OnePice-C/INV.5KW/INV.5KW.OG.Design/Hardware/Main_Display/PCB_Main_Display.html

Altium customize

# Board Information Report

Date: | | 20/5/2025
Time: | | 2:47:24 PM
Elapsed Time: | | 00:00:00
Filename: | | D:\DTKH.INV.13.OFG\INV.5KW.OG.Design\hardware\Main_Display\PCB_Main_Display.PcbDoc
Units: | | mmmils

## Contents

Contents

Board Specification

General

Routing

Routing Information

Layer Information

Layer Information

Drill Pairs

Copper Area

Copper Area

Board Holes

Non-Plated Hole Size

Plated Hole Size

Board Slots

Non-Plated Slot Size

Plated Slot Size

Board Square Holes

Non-Plated Square Hole Size

Plated Square Hole Size

Other

Top Layer Annular Ring Size

Mid Layer Annular Ring Size

Bottom Layer Annular Ring Size

Pad Solder Mask

Pad Paste Mask

Pad Pwr/Gnd Expansion

Pad Relief Conductor Width

Pad Relief Air Gap

Pad Relief Entries

Via Solder Mask

Via Pwr/Gnd Expansion

Track Width

Arc Line Width

Arc Radius

Arc Degrees

Text Height

Text Width

Net Track Width

Net Via Size

## Board Specification

General
Board Size | 125mm x 115mm
Components on board | 172

Back to top

## Routing

Routing Information
Routing completion | 98.84%
Connections | 431
Connections routed | 426
Connections remaining | 5

Back to top

## Layer Information

Layer | Arcs | Pads | Vias | Tracks | Texts | Fills | Regions | ComponentBodies
Top Layer | 0 | 516 | 0 | 776 | 0 | 1 | 701 | 0
Bottom Layer | 0 | 10 | 0 | 191 | 0 | 0 | 157 | 0
Mechanical 1 | 0 | 0 | 0 | 7 | 0 | 0 | 0 | 160
Mechanical 7 | 0 | 0 | 0 | 36 | 12 | 27 | 0 | 0
Mechanical 13 | 9 | 0 | 0 | 28 | 0 | 0 | 0 | 11
Mechanical 14 | 0 | 0 | 0 | 4 | 0 | 0 | 0 | 0
Mechanical 15 | 2 | 1 | 0 | 554 | 0 | 0 | 0 | 0
Multi-Layer | 0 | 133 | 220 | 0 | 0 | 0 | 1 | 0
Top Paste | 0 | 0 | 0 | 0 | 0 | 0 | 1 | 0
Top Overlay | 57 | 0 | 0 | 810 | 314 | 1 | 0 | 0
Top Solder | 0 | 0 | 0 | 1 | 0 | 0 | 1 | 0
Bottom Solder | 0 | 0 | 0 | 0 | 0 | 0 | 1 | 0
Bottom Overlay | 11 | 0 | 0 | 69 | 38 | 0 | 3 | 0
Bottom Paste | 0 | 0 | 0 | 0 | 0 | 0 | 0 | 0
Drill Guide | 0 | 0 | 0 | 0 | 0 | 0 | 0 | 0
Keep-Out Layer | 4 | 0 | 0 | 4 | 0 | 0 | 0 | 0
Drill Drawing | 0 | 0 | 0 | 0 | 0 | 0 | 0 | 0
Total | 83 | 660 | 220 | 2480 | 364 | 29 | 865 | 171

Back to top

Drill Pairs | Vias
Top Layer - Bottom Layer | 220
Total | 220

Back to top

## Copper Area

Layer | Sq.In. | Sq.MM. | Percent of layer
Top Layer | 18.365 | 11848.6 | 82%
Bottom Layer | 18.402 | 11872.267 | 83%
Total | 36.767 | 23720.867

Back to top

## Board Holes

Non-Plated Hole Size | Pads | Vias
Total | 0 | 0

Back to top

Plated Hole Size | Pads | Vias
0mm | 517 | 0
0.3mm | 0 | 220
0.5mm | 32 | 0
0.8mm | 2 | 0
0.8128mm | 9 | 0
0.8636mm | 4 | 0
0.889mm | 4 | 0
1mm | 4 | 0
1.016mm | 20 | 0
1.02mm | 4 | 0
1.2mm | 20 | 0
1.3mm | 2 | 0
1.5mm | 4 | 0
1.5mm | 12 | 0
2mm | 8 | 0
3mm | 4 | 0
3.1mm | 4 | 0
Total | 650 | 220

Back to top

## Board Slots

Non-Plated Slot Size / Length | Pads
Total | 0

Back to top

Plated Slot Size / Length | Pads
Total | 0

Back to top

## Board Square Holes

Non-Plated Square Hole Size | Pads
Total | 0

Back to top

Plated Square Hole Size | Pads
Total | 0

Back to top

## Other

Top Layer Annular Ring Size | Count
0mm | 36
0.1mm | 12
0.2mm | 216
0.635mm | 4
0.762mm | 20
0.78mm | 4
0.8mm | 2
0.8mm | 20
0.8382mm | 9
1mm | 2
1.0414mm | 4
1.2mm | 2
1.24mm | 2
1.5mm | 12
1.5mm | 4
1.9mm | 4
Total | 353

Back to top

Mid Layer Annular Ring Size | Count
0mm | 36
0.1mm | 12
0.2mm | 216
0.635mm | 4
0.762mm | 20
0.78mm | 4
0.8mm | 2
0.8mm | 20
0.8382mm | 9
1mm | 2
1.0414mm | 4
1.2mm | 2
1.24mm | 2
1.5mm | 12
1.5mm | 4
1.9mm | 4
Total | 353

Back to top

Bottom Layer Annular Ring Size | Count
0mm | 36
0.1mm | 12
0.2mm | 216
0.635mm | 4
0.762mm | 20
0.78mm | 4
0.8mm | 2
0.8mm | 20
0.8382mm | 9
1mm | 2
1.0414mm | 4
1.2mm | 2
1.24mm | 2
1.5mm | 12
1.5mm | 4
1.9mm | 4
Total | 353

Back to top

Pad Solder Mask | Count
0mm | 1
0.0508mm | 8
0.1016mm | 651
Total | 660

Back to top

Pad Paste Mask | Count
-1mm | 1
0mm | 659
Total | 660

Back to top

Pad Pwr/Gnd Expansion | Count
0.508mm | 660
Total | 660

Back to top

Pad Relief Conductor Width | Count
0.254mm | 660
Total | 660

Back to top

Pad Relief Air Gap | Count
0.254mm | 660
Total | 660

Back to top

Pad Relief Entries | Count
4 | 660
Total | 660

Back to top

Via Solder Mask | Count
0.1016mm | 220
Total | 220

Back to top

Via Pwr/Gnd Expansion | Count
0.508mm | 220
Total | 220

Back to top

Track Width | Count
0.05mm | 32
0.0762mm | 4
0.1mm | 1111
0.1016mm | 156
0.127mm | 53
0.15mm | 17
0.1778mm | 14
0.2mm | 82
0.2032mm | 564
0.254mm | 29
0.3mm | 344
0.5mm | 70
1mm | 4
Total | 2480

Back to top

Arc Line Width | Count
0.05mm | 2
0.1mm | 5
0.127mm | 2
0.15mm | 1
0.1778mm | 1
0.178mm | 3
0.2mm | 46
0.2032mm | 1
0.25mm | 7
0.254mm | 9
0.4mm | 1
0.6mm | 5
Total | 83

Back to top

Arc Radius | Count
0.0254mm | 2
0.1mm | 4
0.125mm | 7
0.2mm | 1
0.254mm | 1
0.3mm | 5
0.5mm | 5
0.55mm | 1
1mm | 4
2mm | 3
2.5mm | 2
2.8mm | 36
3.0871mm | 4
4mm | 4
4.25mm | 2
4.5mm | 1
11.557mm | 1
Total | 83

Back to top

Arc Degrees | Count
30 | 36
90 | 4
174 | 1
184 | 2
302 | 3
320 | 1
360 | 36
Total | 83

Back to top

Text Height | Count
0.5mm | 12
0.6mm | 1
0.8mm | 343
1mm | 2
1.524mm | 2
3mm | 4
Total | 364

Back to top

Text Width | Count
0.1mm | 1
0.2mm | 343
0.2032mm | 2
0.254mm | 18
Total | 364

Back to top

Net Track Width | Count
0.2032mm | 129
0.254mm | 2
Total | 131

Back to top

Net Via Size | Count
0.5mm | 131
Total | 131

Back to top
