OnePice-C/INV.5KW/INV.5KW.OG.Design/Hardware/INV.OG5K.MAIN.V1/INV.MAIN.PCB1.html

Altium customize

# Board Information Report

Date: | | 26/2/2025
Time: | | 6:48:35 PM
Elapsed Time: | | 00:00:00
Filename: | | D:\DTKH.INV\INV.5KW.OG.Design\Hardware\INV.OG5K.MAIN\INV.MAIN.PCB1.PcbDoc
Units: | | mmmils

## Contents

Contents

Board Specification

General

## Board Specification

General
Board Size | 320mm x 320mm
Components on board | 541

Back to top
