OnePice-C/INV.5KW/INV.5KW.OG.Design/firmware/exemple/sinv_F28P55x/RELEASE/syscfg/pinmux.csv

All device pins and their pinmux options
Pin | Name | Selected Mode | 0 | 1 | 2 | 3 | 4 | 5 | 6 | 7 | 8 | 9 | 10 | 11 | 12 | 13 | 14 | 15
1 | GPIO29 |  | GPIO29 | SCIA_TX |  | EPWM7_B | GPIO29 | OUTPUTXBAR6 | EQEP1_B |  | GPIO29 | EQEP2_INDEX | LINA_RX | SPIB_PTE | GPIO29 | ERRORSTS | I2CB_SCL
2 | A16/ B16/ C16/ GPIO28 |  | GPIO28 | SCIA_RX |  | EPWM7_A | GPIO28 | OUTPUTXBAR5 | EQEP1_A |  | GPIO28 | EQEP2_STROBE | LINA_TX | SPIB_CLK | GPIO28 | ERRORSTS | I2CB_SDA
3 | XRSn | XRSn
4 | GPIO46 |  | GPIO46 |  |  | LINA_TX | GPIO46 | MCANA_TX |  | FSITXA_D1 | GPIO46 | PMBUSA_SDA |  |  | GPIO46
5 | VDDIO | VDDIO
6 | VDD | VDD
7 | VSS | VSS
8 | GPIO47 |  | GPIO47 |  |  | LINA_RX | GPIO47 | MCANA_RX |  | CLB_OUTPUTXBAR2 | GPIO47 | PMBUSA_SCL |  |  | GPIO47
9 | GPIO66 |  | GPIO66 | EQEP1_B | EPWM12_A |  | GPIO66 |  | SPIB_POCI |  | GPIO66 | MCANA_RX |  | I2CA_SDA | GPIO66
10 | GPIO67 |  | GPIO67 | EPWM7_B | EPWM12_B | MCANA_TX | GPIO67 | EQEP1_INDEX | SCIB_RX | PMBUSA_ALERT | GPIO67 | FSIRXA_CLK | LINA_RX | SPIA_POCI | GPIO67 |  |  | SCIC_RX
11 | GPIO48 |  | GPIO48 | OUTPUTXBAR3 |  |  | GPIO48 | MCANA_TX | SCIA_TX |  | GPIO48 | PMBUSA_SDA |  |  | GPIO48
12 | GPIO49 |  | GPIO49 | OUTPUTXBAR4 |  |  | GPIO49 | MCANA_RX | SCIA_RX |  | GPIO49 | LINA_RX |  |  | GPIO49 |  | FSITXA_D0
13 | GPIO50 |  | GPIO50 | EQEP1_A |  |  | GPIO50 | MCANA_TX | SPIB_PICO |  | GPIO50 | I2CB_SDA |  |  | GPIO50 |  | FSITXA_D1
14 | GPIO51 |  | GPIO51 | EQEP1_B |  |  | GPIO51 | MCANA_RX | SPIB_POCI |  | GPIO51 | I2CB_SCL |  |  | GPIO51 |  | FSITXA_CLK
15 | GPIO52 | GPIO52 | GPIO52 | EQEP1_STROBE |  |  | GPIO52 | CLB_OUTPUTXBAR5 | SPIB_CLK |  | GPIO52 | SYNCOUT |  |  | GPIO52 |  | FSIRXA_D0
16 | GPIO53 | GPIO53 | GPIO53 | EQEP1_INDEX |  |  | GPIO53 | CLB_OUTPUTXBAR6 | SPIB_PTE |  | GPIO53 | ADCSOCAO | MCANB_RX |  | GPIO53 |  | FSIRXA_D1
17 | GPIO54 |  | GPIO54 | SPIA_PICO |  |  | GPIO54 | EQEP2_A | OUTPUTXBAR2 |  | GPIO54 | ADCSOCBO | LINA_TX |  | GPIO54 |  | FSIRXA_CLK
18 | A6/ D14/ E14/ GPIO228 | A6_D14_E14_GPIO228 | GPIO228 | EPWM10_A |  | ADCSOCAO | GPIO228 | MCANA_TX | SPIA_POCI |  | GPIO228 | EPWM2_B |  | EQEP1_B | GPIO228 | ADCE_EXTMUXSEL0
19 | B2/ C6/ E12/ GPIO226 | B2_C6_E12_GPIO226 | GPIO226 | EPWM10_B |  | LINA_RX | GPIO226 | EPWM6_A | SPIA_CLK |  | GPIO226 | EPWM1_B |  | EQEP1_STROBE | GPIO226 | ADCE_EXTMUXSEL1 | SCIC_RX
20 | A3/ B3/ PGA2_INP/ C5/ GPIO242 | A3_B3_PGA2_INP_C5_GPIO242 | GPIO242 | EPWM11_A |  |  | GPIO242 | OUTPUTXBAR2 | SPIA_PTE |  | GPIO242 | EPWM4_A | MCANA_RX | EQEP1_INDEX | GPIO242 | ADCE_EXTMUXSEL2
21 | A2/ B6/ C9/ PGA1_INP/ GPIO224 |  | GPIO224 | EPWM11_B |  |  | GPIO224 | OUTPUTXBAR3 | SPIA_PICO |  | GPIO224 | EPWM1_A | MCANA_TX | EQEP1_A | GPIO224 | ADCE_EXTMUXSEL3 | SCIC_TX
22 | A15/ B9/ C7/ PGA1_INM |  | AIO233
23 | C25/ D5/ E5 |  | AIO208
24 | A26/ D6/ E6 |  | AIO209
25 | B26/ D7/ E7 |  | AIO210
26 | A14/ B14/ C4/ PGA1_OUT |  | AIO239
27 | A11/ B10/ C0/ PGA2_OUT |  | AIO237
28 | A5/ B12/ C2/ PGA2_INM |  | AIO244
29 | A1/ B7/ D11/ CMP1_DACL |  | AIO232
30 | A0/ B15/ C15/ DACA_OUT |  | AIO231
31 | D20/ E20/ VREFHI |  | AIO234
32 | D20/ E20/ VREFHI | D20/ E20/ VREFHI
33 | A13/ B13/ C13/ D13/ E13/ VREFLO | A13/ B13/ C13/ D13/ E13/ VREFLO
34 | A13/ B13/ C13/ D13/ E13/ VREFLO |  | AIO235
35 | A12/ C1/ E11/ PGA3_INP |  | AIO238
35 | A12/ C1/ E11/ PGA3_INP |  | AIO248
36 | B11/ D16/ E16/ PGA3_INM |  | AIO251
37 | A7/ B30/ C3/ D12/ E30 |  | AIO245
38 | B5/ D15/ E15/ PGA3_OUT |  | AIO252
39 | A8/ B0/ C11 |  | AIO241
40 | VSSA | VSSA
41 | VDDA | VDDA
42 | A4/ B8/ C14 |  | AIO225
43 | C26/ D8/ E8/ GPIO211 |  | GPIO211 | EPWM10_A |  |  | GPIO211 | EQEP3_A |  |  | GPIO211 |  |  |  | GPIO211
44 | A27/ D9/ E9/ GPIO212 | A27_D9_E9_GPIO212 | GPIO212 | EPWM10_B |  |  | GPIO212 | EQEP3_B |  |  | GPIO212 |  |  |  | GPIO212
45 | B27/ D10/ E10/ GPIO213 | B27_D10_E10_GPIO213 | GPIO213 | EPWM11_A |  |  | GPIO213 | EQEP3_STROBE |  |  | GPIO213 |  |  |  | GPIO213
46 | C27/ D18/ E18/ GPIO214 |  | GPIO214 | EPWM11_B |  |  | GPIO214 | EQEP3_INDEX |  |  | GPIO214 |  |  |  | GPIO214
47 | A28/ D19/ E19/ GPIO215 | A28_D19_E19_GPIO215 | GPIO215 | EPWM7_B |  |  | GPIO215 | EQEP2_A |  |  | GPIO215 |  |  |  | GPIO215
48 | A9/ GPIO227 | A9_GPIO227 | GPIO227 | I2CB_SCL |  | EPWM3_A | GPIO227 | OUTPUTXBAR1 | EPWM2_B |  | GPIO227 |  |  |  | GPIO227
49 | B4/ C8/ GPIO236 | B4_C8_GPIO236 | GPIO236 | EPWM7_A |  |  | GPIO236 | EQEP1_INDEX |  |  | GPIO236 | EPWM12_A |  |  | GPIO236
50 | A10/ B1/ C10/ GPIO230 |  | GPIO230 | I2CB_SDA |  | EPWM3_B | GPIO230 | MCANA_RX | EPWM2_A | I2CA_SDA | GPIO230 | PMBUSA_SCL |  |  | GPIO230
51 | GPIO55 | GPIO55 | GPIO55 | SPIA_POCI |  |  | GPIO55 | EQEP2_B | OUTPUTXBAR3 |  | GPIO55 | ERRORSTS | LINA_RX |  | GPIO55
52 | GPIO60 | GPIO60 | GPIO60 | EPWM12_B |  | MCANA_TX | GPIO60 | OUTPUTXBAR3 | SPIB_PICO |  | GPIO60 |  |  |  | GPIO60
53 | VSS | VSS
54 | VDD | VDD
55 | VDDIO | VDDIO
56 | GPIO64 |  | GPIO64 | SCIA_RX | EPWM11_A | EPWM7_A | GPIO64 | OUTPUTXBAR5 | EQEP1_A |  | GPIO64 | EQEP2_STROBE | LINA_TX | SPIB_CLK | GPIO64 | ERRORSTS | I2CB_SDA
57 | GPIO65 |  | GPIO65 | EQEP1_A | EPWM11_B |  | GPIO65 |  | SPIB_PICO |  | GPIO65 | MCANA_TX |  | I2CA_SCL | GPIO65
58 | GPIO62 | GPIO62 | GPIO62 | EPWM10_A | OUTPUTXBAR3 |  | GPIO62 | MCANA_TX | SCIA_TX |  | GPIO62 | PMBUSA_SDA |  |  | GPIO62
59 | GPIO63 |  | GPIO63 | EPWM10_B | OUTPUTXBAR4 |  | GPIO63 | MCANA_RX | SCIA_RX |  | GPIO63 | LINA_RX |  |  | GPIO63
60 | A17/ B17/ C17/ GPIO20 |  | GPIO20 | EQEP1_A |  |  | GPIO20 | EPWM12_A | SPIB_PICO |  | GPIO20 | MCANA_TX | ADCE_EXTMUXSEL0 | I2CA_SCL | GPIO20 |  |  | SCIC_TX
61 | A18/ B18/ C18/ GPIO21 |  | GPIO21 | EQEP1_B |  |  | GPIO21 | EPWM12_B | SPIB_POCI |  | GPIO21 | MCANA_RX | ADCE_EXTMUXSEL1 | I2CA_SDA | GPIO21 |  |  | SCIC_RX
62 | A19/ B19/ C19/ GPIO13 |  | GPIO13 | EPWM7_B |  | MCANA_TX | GPIO13 | EQEP1_INDEX | SCIB_RX | PMBUSA_ALERT | GPIO13 | FSIRXA_CLK | LINA_RX | SPIA_POCI | GPIO13
63 | A20/ B20/ C20/ GPIO12 |  | GPIO12 | EPWM7_A |  | MCANA_RX | GPIO12 | EQEP1_STROBE | SCIB_TX | PMBUSA_CTL | GPIO12 | FSIRXA_D0 | LINA_TX | SPIA_CLK | GPIO12
64 | A24/ D0/ E0/ GPIO11 | EPWM6_B | GPIO11 | EPWM6_B | MCANA_RX | OUTPUTXBAR7 | GPIO11 | EQEP1_B | SCIB_RX | SPIA_PTE | GPIO11 | FSIRXA_D1 | LINA_RX | EQEP2_A | GPIO11 | SPIA_PICO |  | EQEP3_INDEX
65 | B24/ D1/ E1/ GPIO33 |  | GPIO33 | I2CA_SCL |  | SPIB_PTE | GPIO33 | OUTPUTXBAR4 | LINA_RX |  | GPIO33 | FSIRXA_CLK | MCANB_RX | EQEP2_B | GPIO33 | ADCSOCAO |  | SCIC_RX
66 | C24/ D2/ E2/ GPIO16 |  | GPIO16 | SPIA_PICO |  | OUTPUTXBAR7 | GPIO16 | EPWM9_A | SCIA_TX |  | GPIO16 | EQEP1_STROBE | PMBUSA_SCL | XCLKOUT | GPIO16 | EQEP2_B | SPIB_POCI | EQEP3_STROBE
67 | A25/ D3/ E3/ GPIO17 |  | GPIO17 | SPIA_POCI |  | OUTPUTXBAR8 | GPIO17 | EPWM9_B | SCIA_RX |  | GPIO17 | EQEP1_INDEX | PMBUSA_SDA | MCANA_TX | GPIO17 |  | EPWM6_A
68 | B25/ D4/ E4/ GPIO24 |  | GPIO24 | OUTPUTXBAR1 | EQEP2_A | SPIA_PTE | GPIO24 | EPWM8_A | SPIB_PICO |  | GPIO24 | LINA_TX | PMBUSA_SCL | SCIA_TX | GPIO24 | ERRORSTS | EPWM9_A
69 | GPIO25 |  | GPIO25 | OUTPUTXBAR2 | EQEP2_B |  | GPIO25 | EQEP1_A | SPIB_POCI |  | GPIO25 | FSITXA_D1 | PMBUSA_SDA | SCIA_RX | GPIO25 | EQEP3_A
70 | GPIO26 |  | GPIO26 | OUTPUTXBAR3 | EQEP2_INDEX |  | GPIO26 | OUTPUTXBAR3 | SPIB_CLK |  | GPIO26 | FSITXA_D0 | PMBUSA_CTL | I2CA_SDA | GPIO26 | EQEP3_B
71 | GPIO27 |  | GPIO27 | OUTPUTXBAR4 | EQEP2_STROBE |  | GPIO27 | OUTPUTXBAR4 | SPIB_PTE |  | GPIO27 | FSITXA_CLK | PMBUSA_ALERT | I2CA_SCL | GPIO27 | EQEP3_STROBE
72 | GPIO68 |  | GPIO68 | EPWM7_A | EPWM3_A | MCANA_RX | GPIO68 | EQEP1_STROBE | SCIB_TX | PMBUSA_CTL | GPIO68 | FSIRXA_D0 | LINA_TX | SPIA_CLK | GPIO68 |  |  | SCIC_TX
73 | GPIO69 |  | GPIO69 | EPWM6_B | EPWM3_B | OUTPUTXBAR7 | GPIO69 | EQEP1_B | SCIB_RX | SPIA_PTE | GPIO69 | FSIRXA_D1 | LINA_RX | EQEP2_A | GPIO69 | SPIA_PICO |  | EQEP3_INDEX
74 | GPIO70 |  | GPIO70 | I2CA_SCL |  | SPIB_PTE | GPIO70 | OUTPUTXBAR4 | LINA_RX |  | GPIO70 | FSIRXA_CLK | MCANA_RX | EQEP2_B | GPIO70 | ADCSOCAO |  | EQEP3_A
75 | TCK | TCK
76 | GPIO37/TDO |  | GPIO37 | OUTPUTXBAR2 | SPIA_PTE | I2CA_SCL | GPIO37 | SCIA_TX | MCANB_TX | LINA_TX | GPIO37 | EQEP1_B | PMBUSA_ALERT | EPWM5_A | GPIO37 |  |  | TDO
77 | TMS | TMS
78 | GPIO35/TDI |  | GPIO35 | SCIA_RX | SPIA_POCI | I2CA_SDA | GPIO35 | MCANB_RX | PMBUSA_SCL | LINA_RX | GPIO35 | EQEP1_A | PMBUSA_CTL | EPWM5_B | GPIO35 |  |  | TDI
79 | GPIO32 |  | GPIO32 | I2CA_SDA | EQEP1_INDEX | SPIB_CLK | GPIO32 | EPWM8_B | LINA_TX |  | GPIO32 | FSIRXA_D0 | MCANB_TX | PMBUSA_SDA | GPIO32 | ADCSOCBO
80 | GPIO56 | GPIO56 | GPIO56 | SPIA_CLK | CLB_OUTPUTXBAR7 | MCANA_TX | GPIO56 | EQEP2_STROBE | SCIB_TX |  | GPIO56 | SPIB_PICO | I2CA_SDA | EQEP1_A | GPIO56 |  | FSIRXA_D1
81 | GPIO57 | GPIO57 | GPIO57 | SPIA_PTE | CLB_OUTPUTXBAR8 | MCANA_RX | GPIO57 | EQEP2_INDEX | SCIB_RX |  | GPIO57 | SPIB_POCI | I2CA_SCL | EQEP1_B | GPIO57 |  | FSIRXA_CLK
82 | GPIO58 | GPIO58 | GPIO58 |  |  |  | GPIO58 | OUTPUTXBAR1 | SPIB_CLK |  | GPIO58 | LINA_TX | MCANB_TX | EQEP1_STROBE | GPIO58 |  | FSIRXA_D0
83 | GPIO71 |  | GPIO71 | SPIA_PICO | EPWM4_B | OUTPUTXBAR7 | GPIO71 | EPWM9_A | SCIA_TX |  | GPIO71 | EQEP1_STROBE | PMBUSA_SCL | XCLKOUT | GPIO71 | EQEP2_INDEX | SPIB_POCI | EQEP3_STROBE
84 | GPIO72 |  | GPIO72 | SPIA_POCI | EPWM5_A | OUTPUTXBAR8 | GPIO72 | EPWM9_B | SCIA_RX |  | GPIO72 | EQEP1_INDEX | PMBUSA_SDA | MCANA_TX | GPIO72 |  | EPWM6_A | EQEP3_B
85 | GPIO73 |  | GPIO73 | OUTPUTXBAR1 | EPWM5_B | SPIA_PTE | GPIO73 | EPWM8_A | SPIB_PICO |  | GPIO73 | LINA_TX | PMBUSA_SCL | SCIA_TX | GPIO73 | ERRORSTS | EPWM9_A
86 | GPIO74 |  | GPIO74 | EPWM2_B |  | ADCSOCAO | GPIO74 | MCANA_TX | SPIA_POCI |  | GPIO74 |  |  | EQEP1_B | GPIO74
87 | GPIO18/ X2 |  | GPIO18 | SPIA_CLK | SCIB_TX | MCANB_RX | GPIO18 | EPWM6_A | I2CA_SCL |  | GPIO18 | EQEP2_A | PMBUSA_CTL | XCLKOUT | GPIO18 | LINA_TX |  | EQEP3_INDEX
88 | GPIO19/ X1 |  | GPIO19 | SPIA_PTE | SCIB_RX | MCANB_TX | GPIO19 | EPWM6_B | I2CA_SDA |  | GPIO19 | EQEP2_B | PMBUSA_ALERT | CLB_OUTPUTXBAR1 | GPIO19 | LINA_RX
89 | VDDIO | VDDIO
90 | VDD | VDD
91 | GPIO43 |  | GPIO43 |  |  | OUTPUTXBAR6 | GPIO43 | PMBUSA_ALERT | I2CA_SCL | SCIC_TX | GPIO43 | PMBUSA_ALERT | EQEP1_INDEX | CLB_OUTPUTXBAR4 | GPIO43
92 | VSS | VSS
93 | VREGENZ | VREGENZ
94 | GPIO42 |  | GPIO42 |  | LINA_RX | OUTPUTXBAR5 | GPIO42 | PMBUSA_CTL | I2CA_SDA | SCIC_RX | GPIO42 |  | EQEP1_STROBE | CLB_OUTPUTXBAR3 | GPIO42
95 | GPIO8 | EPWM5_A | GPIO8 | EPWM5_A |  | ADCSOCAO | GPIO8 | EQEP1_STROBE | SCIA_TX | SPIA_PICO | GPIO8 | I2CA_SCL | FSITXA_D1 | CLB_OUTPUTXBAR5 | GPIO8 | EPWM11_A
96 | GPIO4 | EPWM3_A | GPIO4 | EPWM3_A | I2CA_SCL | MCANA_TX | GPIO4 | OUTPUTXBAR3 |  | SPIB_CLK | GPIO4 | EQEP2_STROBE | FSIRXA_CLK | CLB_OUTPUTXBAR6 | GPIO4 | EPWM11_B | SPIA_POCI | EPWM1_A
97 | GPIO3 | EPWM2_B | GPIO3 | EPWM2_B | OUTPUTXBAR2 |  | GPIO3 | OUTPUTXBAR2 | PMBUSA_SCL | SPIA_CLK | GPIO3 | SCIA_RX | FSIRXA_D0 | I2CB_SCL | GPIO3 |  | MCANB_RX | EPWM4_B
98 | GPIO2 | EPWM2_A | GPIO2 | EPWM2_A |  |  | GPIO2 | OUTPUTXBAR1 | PMBUSA_SDA | SPIA_PICO | GPIO2 | SCIA_TX | FSIRXA_D1 | I2CB_SDA | GPIO2 | EPWM10_A | MCANB_TX | EPWM4_A
99 | GPIO1 | EPWM1_B | GPIO1 | EPWM1_B |  |  | GPIO1 | SCIA_TX | I2CA_SCL | SPIA_POCI | GPIO1 | EQEP1_STROBE | MCANA_TX | CLB_OUTPUTXBAR7 | GPIO1 | EPWM10_B |  | EPWM3_B
100 | GPIO0 | EPWM1_A | GPIO0 | EPWM1_A |  | OUTPUTXBAR7 | GPIO0 | SCIA_RX | I2CA_SDA | SPIA_PTE | GPIO0 | FSIRXA_CLK | MCANA_RX | CLB_OUTPUTXBAR8 | GPIO0 | EQEP1_INDEX |  | EPWM3_A
101 | GPIO40 | GPIO40 | GPIO40 | SPIB_PICO |  |  | GPIO40 | EPWM2_B | PMBUSA_SDA | FSIRXA_D0 | GPIO40 | SCIB_TX | EQEP1_A | LINA_TX | GPIO40 |  | CLB_OUTPUTXBAR4 | EQEP3_STROBE
102 | GPIO23 |  | GPIO23 | EQEP1_INDEX |  | SCIB_RX | GPIO23 |  | SPIB_PTE |  | GPIO23 | LINA_RX | CLB_OUTPUTXBAR3 | LINA_RX | GPIO23 | EPWM12_A | EPWM4_B
103 | GPIO41 |  | GPIO41 | EPWM7_A |  |  | GPIO41 | EPWM2_A | PMBUSA_SCL | FSIRXA_D1 | GPIO41 | SCIB_RX | EQEP1_B | LINA_RX | GPIO41 | EPWM12_B | SPIB_POCI
104 | GPIO22 |  | GPIO22 | EQEP1_STROBE |  | SCIB_TX | GPIO22 |  | SPIB_CLK |  | GPIO22 | LINA_TX | CLB_OUTPUTXBAR1 | LINA_TX | GPIO22 |  | EPWM4_A | EQEP3_A
105 | GPIO7 |  | GPIO7 | EPWM4_B | EPWM2_A | OUTPUTXBAR5 | GPIO7 | EQEP1_B |  | SPIB_PICO | GPIO7 | FSITXA_CLK | CLB_OUTPUTXBAR2 | SCIA_TX | GPIO7 |  | MCANA_TX | EPWM2_B
106 | GPIO44 | GPIO44 | GPIO44 |  |  | OUTPUTXBAR7 | GPIO44 | EQEP1_A | PMBUSA_SDA | FSITXA_CLK | GPIO44 | PMBUSA_CTL | CLB_OUTPUTXBAR3 | FSIRXA_D0 | GPIO44 |  | LINA_TX
107 | VSS | VSS
108 | VDD | VDD
109 | VDDIO | VDDIO
110 | GPIO45 |  | GPIO45 |  |  | OUTPUTXBAR8 | GPIO45 |  |  | FSITXA_D0 | GPIO45 | PMBUSA_ALERT | CLB_OUTPUTXBAR4 |  | GPIO45
111 | GPIO75 |  | GPIO75 | EPWM1_B |  | LINA_RX | GPIO75 | EPWM6_A | SPIA_CLK |  | GPIO75 |  |  | EQEP1_STROBE | GPIO75 |  | SCIC_RX
112 | GPIO76 |  | GPIO76 | EPWM4_A |  |  | GPIO76 | OUTPUTXBAR2 | SPIA_PTE |  | GPIO76 |  | MCANA_RX | EQEP1_INDEX | GPIO76
113 | GPIO77 |  | GPIO77 | EPWM1_A |  |  | GPIO77 | OUTPUTXBAR3 | SPIA_PICO |  | GPIO77 |  | MCANA_TX | EQEP1_A | GPIO77 |  | SCIC_TX
114 | GPIO78 |  | GPIO78 |  | EPWM8_A | EPWM3_A | GPIO78 | OUTPUTXBAR1 | EPWM2_B |  | GPIO78 | FSITXA_CLK |  |  | GPIO78
115 | GPIO79 |  | GPIO79 |  | EPWM8_B | EPWM3_B | GPIO79 | MCANA_RX | EPWM2_A | I2CA_SDA | GPIO79 | PMBUSA_SCL |  |  | GPIO79
116 | GPIO80 |  | GPIO80 | EPWM1_A |  | OUTPUTXBAR7 | GPIO80 | SCIA_RX | I2CB_SDA | SPIA_PTE | GPIO80 | FSITXA_D0 | MCANA_RX | CLB_OUTPUTXBAR8 | GPIO80 | EQEP1_INDEX |  | EPWM3_A
117 | GPIO81 |  | GPIO81 | EPWM1_B | OUTPUTXBAR6 | SCIC_RX | GPIO81 | SPIB_CLK | I2CB_SCL |  | GPIO81 | FSITXA_D1 | MCANA_TX | EQEP3_INDEX | GPIO81
118 | GPIO5 | EPWM3_B | GPIO5 | EPWM3_B | I2CA_SDA | OUTPUTXBAR3 | GPIO5 | MCANA_RX |  | SPIA_PTE | GPIO5 | FSITXA_D1 | CLB_OUTPUTXBAR5 | SCIA_RX | GPIO5 |  |  | EPWM1_B
119 | GPIO9 | EPWM5_B | GPIO9 | EPWM5_B | SCIB_TX | OUTPUTXBAR6 | GPIO9 | EQEP1_INDEX | SCIA_RX | SPIA_CLK | GPIO9 | I2CA_SCL | FSITXA_D0 | LINA_RX | GPIO9 | PMBUSA_SCL | I2CB_SCL | EQEP3_B
120 | GPIO61 | GPIO61 | GPIO61 |  |  | MCANA_RX | GPIO61 | OUTPUTXBAR4 | SPIB_POCI |  | GPIO61 |  |  |  | GPIO61 |  | MCANB_RX
121 | GPIO59 |  | GPIO59 |  |  |  | GPIO59 | OUTPUTXBAR2 | SPIB_PTE |  | GPIO59 | LINA_RX | MCANB_RX | EQEP1_INDEX | GPIO59
122 | GPIO10 | EPWM6_A | GPIO10 | EPWM6_A |  | ADCSOCBO | GPIO10 | EQEP1_A | SCIB_TX | SPIA_POCI | GPIO10 | I2CA_SDA | FSITXA_CLK | LINA_TX | GPIO10 | EQEP3_STROBE |  | CLB_OUTPUTXBAR4
123 | GPIO34 | GPIO34 | GPIO34 | OUTPUTXBAR1 |  |  | GPIO34 |  | PMBUSA_SDA |  | GPIO34 |  |  |  | GPIO34 |  | I2CB_SDA
124 | GPIO15 |  | GPIO15 | EPWM8_B | SCIB_RX |  | GPIO15 | I2CB_SCL | OUTPUTXBAR4 | PMBUSA_SCL | GPIO15 | SPIB_PTE | EQEP2_B | LINA_RX | GPIO15 | EPWM3_B | CLB_OUTPUTXBAR6
125 | GPIO14 |  | GPIO14 | EPWM8_A | SCIB_TX |  | GPIO14 | I2CB_SDA | OUTPUTXBAR3 | PMBUSA_SDA | GPIO14 | SPIB_CLK | EQEP2_A | LINA_TX | GPIO14 | EPWM3_A | CLB_OUTPUTXBAR7
126 | GPIO6 |  | GPIO6 | EPWM4_A | OUTPUTXBAR4 | SYNCOUT | GPIO6 | EQEP1_A |  | SPIB_POCI | GPIO6 | FSITXA_D0 |  | FSITXA_D1 | GPIO6 |  | CLB_OUTPUTXBAR8 | EPWM2_A
127 | GPIO30 |  | GPIO30 |  |  | SPIB_PICO | GPIO30 | OUTPUTXBAR7 | EQEP1_STROBE |  | GPIO30 | FSIRXA_CLK | MCANA_RX | EPWM1_A | GPIO30 | EQEP3_INDEX
128 | GPIO31 |  | GPIO31 |  |  | SPIB_POCI | GPIO31 | OUTPUTXBAR8 | EQEP1_INDEX |  | GPIO31 | FSIRXA_D1 | MCANA_TX | EPWM1_B | GPIO31
