OnePice-C/INV.5KW/Mẫu thiết kế INV/Off Grid 5kw.MPS/Picture INV.5k/ACDC/DCDC/Q30+Q28.bmp

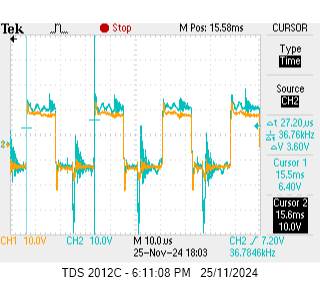
Mẫu thiết kế INV/Off Grid 5kw.MPS/Picture INV.5k/ACDC/DCDC/Q30+Q28.bmp
