OnePice-C/INV.5KW/Mẫu thiết kế INV/Off Grid 5kw.MPS/Picture INV.5k/dcac/QB2+QC1.S1.bmp

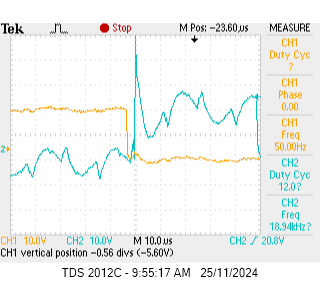
Mẫu thiết kế INV/Off Grid 5kw.MPS/Picture INV.5k/dcac/QB2+QC1.S1.bmp
