OnePice-C/INV.5KW/Mẫu thiết kế INV/Off Grid 5kw.MPS/Picture INV.5k/dcdc/gt1-hl.bmp

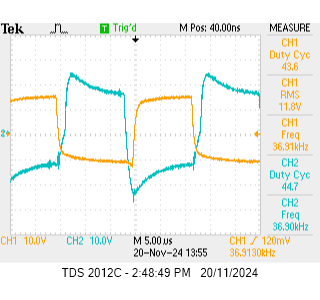
Mẫu thiết kế INV/Off Grid 5kw.MPS/Picture INV.5k/dcdc/gt1-hl.bmp
