OnePice-C/INV.5KW/Mẫu thiết kế INV/Off Grid 5kw.MPS/Picture INV.5k/dcdc/gt1L_gt2L_deadtime.bmp

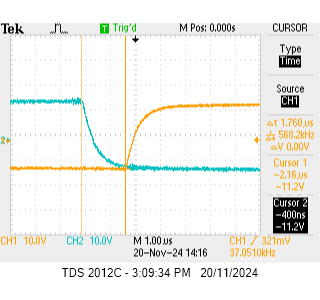
Mẫu thiết kế INV/Off Grid 5kw.MPS/Picture INV.5k/dcdc/gt1L_gt2L_deadtime.bmp
