OnePice-C/INV.5KW/Doc.Design.INV.OFG/Bom.DAB.Ti.pdf

Fitted Fitted Fitted | Description CAP, CERM, 0.01 uF, 100 V, +/- 5%, Printed Circuit Board X7R, 0603 | Designator C1, C4, C6, C12, C313, C319, C320, !PCB1 C321, C322 | PartNumber C0603C103J1RAC TU TIDA-DAB-010054 | Quantity | Manufacturer 9 Kemet 1 Any | PackageReference 0603 | Value 0.01uF

Fitted | CAP, CERM, 10 µF, 25 V,+/- 10%, X7R, 1206 | C2, C8, C14 | C3216X7R1E106K 160AB | 3 TDK | 1206 | 10uF

Fitted | CAP, CERM, 1 µF, 16 V,+/- 10%, X7R, AEC-Q200 Grade 1, 0603 | C3, C7, C13 | CL10B105KO8VPN C | 3 Samsung Electro-Mechanics | 0603 | 1uF

Fitted | CAP, CERM, 0.1 uF, 50 V, +/- 10%, X7R, 0603 | C5, C154, C197 | 885012206095 | 3 Wurth Elektronik | 0603 | 0.1uF

Fitted | CAP, CERM, 47 pF, 50 V, +/- 5%, C0G/NP0, 0603 | C9, C11 | JA01D GRM1885C1H470 | 2 MuRata | 0603 | 47pF

Fitted | CAP, CERM, 4700 pF, 50 V, +/- 10%, X7R, 0603 | C10 | C0603X472K5RAC TU | 1 Kemet | 0603 | 4700pF

Fitted | CAP, CERM, 0.1 uF, 1000 V, +/-30 µF Film Capacitor 800V Polypropylene 10%, X7R, 1812 (PP), Metallized Radial - 4 Leads | C15, C16, C19, C20, C25, C26, C21, C22 C28, C30 | C1812V104KDRAC TU B32716H8306K00 0 | 8 Kemet 2 TDK | 1812 RADIAL | 0.1uF 30µF

Fitted | Power Film Capacitor, 15 uF, 1.1 kVDC, ± 10%, Metallized PP, Radial Box - 4 Pin, Through Hole | C23, C24 | B32716H1156K00 0 | 2 TDK | RADIAL | 15µF

Fitted | CAP, CERM, 0.47 µF, 1000 V,+/-10%, X7R, AEC-Q200 Grade 1, 2220 | C31, C33, C35, C37, C39, C41, C43, C45, C47, C49, C51, C53, C55, C57 | 2220Y1K00474KE TWS2 | 14 Knowles Capacitors | 2220 | 0.47uF

Fitted | CAP, CERM, 0.47 µF, 630 V,+/- 20%, X7T, AEC-Q200 Grade 1, 2220 | C32, C34, C36, C38, C40, C42, C44, C46, C48, C50, C52, C54, | CGA9P1X7T2J474 M250KC | 14 TDK | 2220 | 0.47uF

Fitted | CAP, CERM, 2200 pF, 3KV, +/- 20%, E, Cap, 7x12x9 mm | C56, C58 C59, C60, C61 | CK45-B3FD222KYVNA | 3 MuRata | Cap, 7x12x9 mm | 2200pF

Fitted | CAP, CERM, 0.1 uF, 50 V, +/- 10%, X7R, AEC-Q200 Grade 1, 0402 | C62, C85, C86, C91, C116, C117, C120 | GCM155R71H104 KE02D | 7 MuRata | 0402 | 0.1uF

Fitted | CAP, CERM, 2.2 uF, 16 V, +/- 10%, X7R, 0603 | C63, C65, C67, C69 C64, C68, C78, | EMK107BB7225K A-T | 4 Taiyo Yuden | 0603 | 2.2uF

Fitted | Automotive CAP, 100㎋, 25V, ±10%, X7R, 0603, 5mm Bending | C80, C81, C88, C94, C95, C97, C99, C102, C104, C126, C146, C151 | CL10B104KA8VPJ C | 15 Samsung | 0603 | 100nF

Fitted | CAP, CERM, 0.22 uF, 16 V, +/- 10%, X7R, 0603 | C66, C77 | C1608X7R1C224K 080AC | 2 TDK | 0603 | 0.22uF

Fitted | CAP, CERM, 1 uF, 16 V, +/- 10%, X7R, AEC-Q200 Grade 1, 0603 | C70 | GCM188R71C105 KA64D | 1 MuRata | 0603 | 1uF

Fitted | CAP, CERM, 47 uF, 10 V, +/- 10%, X7R, 1210 | C71, C72 | GRM32ER71A476 KE15L | 2 MuRata | 1210 | 47uF

Fitted | CAP, AL, 100 µF, 25 V, +/- 20%, SMD | C73, C96, C138, C145, C314 | UWT1E101MCL1G S | 5 Nichicon | 6.6x6.6mm | 100uF

Fitted | CAP, CERM, 10 uF, 50 V, +/- 10%, X7R, 1206 | C74, C75 | CL31B106KBHNN NE | 2 Samsung | 1206 | 10uF

Fitted | CAP, CERM, 33 pF, 50 V, +/- 5%, CAP, CERM, 2.2 µF, 16 V,+/- 10%, C0G/NP0, 0603 X7R, 0603 | C76 C79, C82, C98, C100, C101, C103, C129, C131, C142, C143 | JA01D GRM1885C1H330 CC0603KRX7R7BB 225 | 1 MuRata 10 Yageo America | 0603 | 33pF 2.2uF

Fitted | Cap Ceramic 1uF 25V X7R ±10% Pad SMD 0603 +125°C T/R | C84, C87, C90, C111, C115, C118, C119, C148 | CL10B105KA8VPJ C | 8 Samsung | 0603 | 1µF

Fitted | CAP, CERM, 0.082 CAP, CERM, 10 pF, 10 V, +/- 10%, uF, 16 V, +/- 10%, X7R, 0603 X7R, 0603 | C93, C107, C108, C239, C267 C89, C124 | 0603ZC100KAT2A 0603YC823KAT2A | 5 AVX 2 AVX | 0603 | 10pF 0.082uF

Fitted | CAP, CERM, 82 pF, 50 V, +/- 10%, C0G/NP0, 0603 | C105, C106 | C0603C820K5GAC TU | 2 Kemet | 0603 | 82pF

Fitted | CAP, CERM, 220 pF, 50 V, +/- 5%, C0G/NP0, 0603 | C109 | JA01D GRM1885C1H221 | 1 MuRata | 0603 | 220pF

Fitted | CAP, CERM, 0.1 uF, 25 V, +/- 10%, CAP, CERM, 10 µF, 50 V,+/- 10%, X7R, X7R, 0603 AEC-Q200 Grade 1, 1206 | C110, C147 C112, C149, C155, C157, C198, C200, C237, C275, C325, C326, C327, C328, C329, C330, C331, C332 | 06033C104KAT2A CGA5L1X7R1H106 K160AC | 2 AVX 16 TDK | 0603 1206 | 0.1uF 10uF

Fitted | CAP, CERM, 0.1 uF, 50 V, +/- 10%, X7R, AEC-Q200 Grade 1, 0603 | C113, C150, C156, C158, C159, C160, C165, C167, C199, C201, C202, C203, C208, C210, C232, C236, C238, C244, C246, C276, C277, C280, C282, C285 | CGA3E2X7R1H104 K080AA | 24 TDK | 0603 | 0.1uF

Fitted | CAP, CERM, 3900 pF, 100 V,+/- 5%, C0G/NP0, 0603 | C114, C140, C153, C323, C324, C333, C334 | C1608C0G2A392J 080AE | 7 TDK | 0603 | 3900pF

Fitted | CAP, CERM, 10 pF, 50 V, +/- 5%, C0G/NP0, 0603 CAP, CERM, 1000 | C121, C122, C136, C137 | C0603C100J5GAC TU | 4 Kemet | 0603 | 10pF

Fitted | pF, 250 V, +/- 10%, CAP, CERM, 0.1 uF, 25 V, +/- 10%, X7R, AEC-Q200 X7R, 0603 Grade 1, 0603 | C128, C139 C130, C132, C141, C144 | GRM188R72E102 KW07D CGA3E2X7R1E104 K080AA | 2 MuRata 4 TDK | 0603 | 1000pF 0.1uF

Fitted | CAP, CERM, 0.01 uF, 100 V, +/- 10%, X7R, 0603 | C135 | GRM188R72A103 KA01D | 1 MuRata | 0603 | 0.01uF

Fitted | CAP, CERM, 0.01 uF, 25 V, +/- 5%, C0G/NP0, 0603 CAP, CERM, 330 pF, 50 V, +/- 10%, X7R, 0603 | C152 C161, C162, C163, C164, C188, C189, C204, C205, C206, C207, C230, C235, C240, C241, C242, C243, C269, C278, C279, C283, C284, C302, C308, C312 | C0603H103J3GAC TU C0603C331K5RAC TU | 1 Kemet 24 Kemet | 0603 | 0.01uF 330pF

Fitted | CAP, CERM, 2.2 uF, 50 V, +/- 10%, X7R, 1206 CAP, CERM, 0.1 uF, 50 V, +/- 10%, X7R, 1206 | C166, C168, C209, C169, C171, C173, C176, C178, C181, C211, C245, C247, C281, C286 C196, C213, C215, C218, C220, C223, C248, C250, C252, C255, C257, C260, C287, C289, C291, C294, C296, C300 | C3216X7R1H225K 160AB C1206C104K5RAC TU | 8 TDK 24 Kemet | 1206 | 2.2uF 0.1uF

Fitted | CAP, CERM, 3.3 uF, 50 V, +/- 10%, X5R, 1206 CAP, CERM, 1 uF, 100 V, +/- 10%, X7R, 1206 | C170, C172, C212, C214, C249, C251, C288, C290 C174, C177, C216, C219, C253, C256, C292, C295 | C3216X5R1H335K 160AB C3216X7R2A105K 160AA | 8 TDK | 1206 | 3.3uF 1uF

Fitted | CAP, CERM, 100 pF, 50 V,+/- 1%, C0G/NP0, 0603 | C175, C180, C183, C184, C185, C190, C217, C222, C225, C226, C227, C231, C254, C259, C262, C264, C265, C270, C293, C299, C303, C304, C305, C309 | C0603C101F5GAC TU | 24 Kemet | 0603 | 100pF

Fitted | CAP, CERM, 0.47 uF, 50 V, +/- 10%, X7R, 1206 | C179, C182, C221, C224, C258, C261, C297, C301 | C3216X7R1H474K 160AA | 8 TDK | 1206 | 0.47uF

Fitted | Automotive CAP, 1㎌, 35V, ±10%, X7R, 0603, 5mm Bending | C186, C191, C228, C233, C266, C274, C306, C310 | CL10B105KL9VPJC | 8 Samsung | 0603 | 1µF

Fitted | CAP, CERM, 0.1 uF, 10 V, +/- 10%, X7R, 0603 CAP, CERM, 330 | C187, C192, C229, C234, C268, C298, C307, C311 | 0603ZC104KAT2A | 8 AVX | 0603 | 0.1uF

Fitted | pF, 50 V, +/- 5%, Diode, Standard Recovery Rectifier, 250 V, 0.2 A, SOD-C0G/NP0, 0603 323 | C315, C316, C317, C318 D1, D3 | 06035A331JAT2A BAV21WS-TP | 4 AVX 2 Micro Commercial Components | 0603 SOD-323 | 330pF 250V

Fitted Fitted Fitted Fitted Fitted Fitted Fitted | Diode, Zener, 12 V, 1.5 W, SMA Diode TVS Single Bi-Dir 36V 600W 2-Pin SMB Diode, TVS, Bi, 36 V, 58.1 Vc, SMC LED, Red, SMD Diode, Schottky, 50 V, 2 A, SMA LED, Green, SMD Diode, Schottky, 60 V, 0.5 A, SOD-123 Diode Standard | D2, D4 D5 D7 D6 D9 D8, D10, D11, D12 D13, D16 | 1SMA5927BT3G SMBJ36CA SMCJ36CA LTST-C193KRKT-5A B250A-13-F 150060VS75000 SBR0560S1-7 | 2 ON Semiconductor 1 Littelfuse 1 1 Littelfuse Lite-On 1 4 Wurth Elektronik Diodes Inc. 2 Diodes Inc. | SMA DO-214AA SMC 1.6x0.8mm SMA LED_0603 SOD-123 | 12V 36V Red 50V Green 60V

Fitted | 1200 V 1A Surface Mount DO-214AC (SMA) | D14, D15, D18, D19, D22, D25, D26, D27 | US1Q-TP | 8 MCC | SMA

Fitted | Standard LEDs -SMD Green TOPLED E 1608 | D17, D20, D21, D23, D31, D32, D33, D34 | JGKH-24 KG DELLS1.22- | 8 Osram Opto | 0603

Fitted | Fiducial mark. There is nothing to buy or mount. | FID1, FID2, FID3, FID4, FID5, FID6 | N/A | 6 N/A | N/A

Fitted | Machine Screw, Round, #4-40 x 1/4, Nylon, Philips panhead | H1, H2, H3, H4 | NY PMS 440 0025 PH | 4 B&F Fastener Supply | Screw

Fitted Fitted Fitted | Header, 2.54mm, 2x1, Gold, SMT Standoff, Hex, 0.5"L #4-40 Nylon C2000 controlCARD-120HSEC connector, SMT | J1, J3 H5, H6, H7, H8 J2 | 61000218321 1902C HSEC8-160-01-L-DV-A-BL | 2 Wurth Elektronik 4 Keystone 1 Samtec | Header, 2.54mm, Standoff C2000 pin 2x1, SMT numbering

Fitted | Header, 2.54mm, 3x1, Gold, SMT Receptacle, D-Sub, 9 Position, R/A, TH | J4, J5 J6 | 61000318221 618009231121 | 2 Wurth Elektronik 1 Wurth Elektronik | Header, 2.54mm, Receptacle, D-Sub, 9 Position, R/A, TH 3x1, SMT

Fitted | Shorting Jumper, 7.62mm, 2 Position, Gold, TH | J8, J9 | 999-11-113-10-000000 | 2 Mill-Max | Shorting Jumper, 7.62mm, 2 Position, Gold, TH

Fitted Fitted | Power Element Bush, M3, TH Header, 2.54 mm, 2x1, Gold, TH General Purpose Power Jack, SMT Relay SPST-NO (1 Form A) 12VDC Coil Through Hole | J11, J12, J13, J14 J10 J15 K1, K3 | 74650073R 61300211121 PJ-002AH-SMT-TR G9KB-1A DC12 | 4 Wurth Elektronik 1 Wurth Elektronik 1 CUI Inc. 2 Omron | Power Element Header, 2.54mm, 2x1, TH Bush, M3, TH 14.8x11x12.6mm PTH_RELAY_50M M0_36MM7

Fitted | Ferrite Bead, 26 ohm @ 100 MHz, 6.5 A, 0603 | L1, L2, L4, L5, L6, L7, L8, L9, L10, L11, L12, L13, L14, L15, L17, L18 | 74279228260 | 16 Wurth Elektronik | 0603 | 26 ohm

Fitted | 100µH @ 100kHz 2 Line Common Mode Choke Surface Mount 5.8 kOhms @ 10MHz 150mA DCR 2Ohm | L3 | ACT45B-101-2P-TL003 | 1 TDK | SMT_4MM5_3M M2

Fitted | Thermal Transfer Printable Labels, 0.650" W x 0.200" H - 10,000 per roll | LBL1 | THT-14-423-10 | 1 Brady | PCB Label 0.650 x 0.200 inch

Fitted | CD-02-05 Series 0.95 x 0.75 inch w/ Hole TO-247 Phase Change Thermal Pad | MP1, MP2, MP4, MP5, MP8, MP9, MP11, MP12 | CD-02-05-247 | 8 Wakefield-Vette | THERM_PAD_24M M13_19MM05

Fitted | Heat Sinks Aluminum heatsink 50mmdegreased | MP3, MP6, MP7, MP10 | CR201-50VE | 4 Ohmite | PTH_HEATSINKS_ 34MM0_50MM0

Fitted | Hex Standoff Threaded #8-32 Brass 0.500" (12.70mm) 1/2" #8-32 Pan Head | MP13, MP14, MP15, MP16 | 1474C | 4 Keystone Electronics | HEX_STANDOFF_8-32_1IN2

Fitted | Machine Screw Phillips Drive Stainless Steel | MP17, MP18, MP19, MP20 | PMSSS 832 0063 PH | 4 Building Fasteners | SCREW_0IN322

Fitted | Test Point, Miniature, SMT | PWM1, PWM2, PWM3, PWM4, PWM5, PWM6, PWM7, PWM8, TP6, TP8, TP9, TP10, TP12, TP13, TP14, TP15, TP16, TP17, TP18, TP19, TP20, TP21, TP22, TP23, TP24, TP25, TP26, TP27, TP28, TP29, TP31 | 5015 | 31 Keystone Electronics | Testpoint_Keyston e_Miniature

Fitted | 30-V N-Channel NexFET™ Power MOSFET | Q1, Q2, Q3, Q4 | CSD17318Q2 | 4 Texas Instruments | WSON6

Fitted | MOSFET, N-CH, 900 V, 63 A, TO-247-4 | Q6, Q7, Q10, Q11 | C3M0030090K | 4 Cree | TO-247-4 | 900V

Fitted Fitted | MOSFET, N-CH, 1200 V, 30 A, TO-247-4 RES, 10.0 k, 0.1%, 0.1 W, 0603 RES, 200, 0.1%, 0.1 W, 0603 RES, 0, 1%, 0.1 W, AEC-Q200 Grade 0, 0603 | Q8, Q9, Q12, Q13 R2, R5, R43, R51, R158 R1, R4, R39, R48 R3, R10, R15, R19, R22, R23, R36, R38, R41, R61, R63, R85, R137, R141, R144, R147, R150, R193, R194, R206, R207, R210, R211, R212, R213, R251, R252, R263, R264 | C3M0075120K RT0603BRD0710K L RT0603BRD07200 RL RMCF0603ZT0R00 | 4 Cree 5 Yageo America 4 Yageo America 29 Stackpole Electronics Inc | TO-247-4 0603 0603 0603 | 1200V 10.0k 200 0

Fitted | RES, 10.0 k, 1%, 0.1 W, AEC-Q200 Grade 0, 0603 | R24, R25, R26, R27, R28, R31, R32, R34, R35, R52, R79, R82, R174, R175, R176, R177, R178, R179, R180, R181, R182, R186, R190, R204, R205, R232, R233, R234, R235, R236, R237, R238, R239, R240, R244, R248, R287, R292, R330, R345 | CRCW060310K0F KEA | 40 Vishay-Dale | 0603 | 10.0k

Fitted Fitted Fitted Fitted Fitted | RES, 8.2 k, 5%, 0.1 W, 0603 RES, 49.9, 1%, 0.1 W, 0603 RES, 1.2 k, 5%, 0.1 RES, 2.2 k, 5%, 0.1 W, 0603 0 Ohms Jumper 0.1W, 1/10W Chip W, 0603 Resistor 0603 (1608 Metric) -Thick Film | R37, R45 R30, R33, R42, R86 R40 R46 R53, R56 | RC0603JR-078K2L RC0603FR-0749R9L RC0603JR-072K2L RC0603JR-071K2L CR0603-10W-000T | 2 Yageo 4 Yageo 1 Yageo 1 Yageo 2 Venkel | 0603 0603 0603 0603 0603 | 8.2k 49.9 2.2k 1.2k 0uΩ

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

# IMPORTANT NOTICE AND DISCLAIMER

TI PROVIDES TECHNICAL AND RELIABILITY DATA (INCLUDING DATA SHEETS), DESIGN RESOURCES (INCLUDING REFERENCE DESIGNS), APPLICATION OR OTHER DESIGN ADVICE, WEB TOOLS, SAFETY INFORMATION, AND OTHER RESOURCES “AS IS” AND WITH ALL FAULTS, AND DISCLAIMS ALL WARRANTIES, EXPRESS AND IMPLIED, INCLUDING WITHOUT LIMITATION ANY IMPLIED WARRANTIES OF MERCHANTABILITY, FITNESS FOR A PARTICULAR PURPOSE OR NON-INFRINGEMENT OF THIRD PARTY INTELLECTUAL PROPERTY RIGHTS.
These resources are intended for skilled developers designing with TI products. You are solely responsible for (1) selecting the appropriate TI products for your application, (2) designing, validating and testing your application, and (3) ensuring your application meets applicable standards, and any other safety, security, regulatory or other requirements.
These resources are subject to change without notice. TI grants you permission to use these resources only for development of an application that uses the TI products described in the resource. Other reproduction and display of these resources is prohibited. No license is granted to any other TI intellectual property right or to any third party intellectual property right. TI disclaims responsibility for, and you will fully indemnify TI and its representatives against, any claims, damages, costs, losses, and liabilities arising out of your use of these resources.
TI’s products are provided subject to TI’s Terms of Sale (https://www.ti.com/legal/terms-conditions/terms-of-sale.html) or other applicable terms available either on ti.com or provided in conjunction with such TI products. TI’s provision of these resources does not expand or otherwise alter TI’s applicable warranties or warranty disclaimers for TI products.
TI objects to and rejects any additional or different terms you may have proposed. IMPORTANT NOTICE

# Mailing Address: Texas Instruments, Post Office Box 655303, Dallas, Texas 75265 Copyright © 2024, Texas Instruments Incorporated
