OnePice-C/INV.5KW/INV.5KW.OG.Design/Hardware/BomList/INV.5KW.OG.BOM.xlsx

Sheet: INV_500W
 |  |  | DANH SÁCH LINH KIỆN - VẬT TƯ BILL OF MATERIALS |  |  |  |  |  | Số hiệu:
Đơn vị: TT R&D Chiếu Sáng |  |  | Sản phẩm: BỘ INVETTER 500W NỘI ĐỊA |  |  |  |  |  | Model: |  |  | Giá sơ bộ(đồng)
STT No. | Name | Ký hiệu Designator | Mô tả - đặc tính kỹ thuật Description - Specification | Mã linh kiện Part Number (chính/dự phòng) | Định mức | Nhà cung cấp Vendor |  | Mức độ kiểm soát/ Control level | Ghi chú | Mã ERP | Tên hàng hóa + Model
 |  |  |  |  |  | Chính Preferable | Dự phòng Alternative
I. | Mạch INV
1 | Capacitor | C1, C2, C4, C6, C11, C12 | 100nF/25V; Multilayer Ceramic Capacitor Tụ dán-104K-25V-X7R-0805; 104K/25V/10%/X7R/0805, Tape type, PN: 0805B104K0250NT, Fenghua | 00018342 | 6 |  |  |  | SMT
 |  | C3 | Tụ Dán 1uF/25V/10%/0805 |  | 1 |  |  |  | SMT
 |  | C5 | Tụ điện cao áp CBB 630V 104J 100nF 0.1UF 104J630V 16mm |  | 1 |  |  |  | THT
 |  | C7, C8 | Tụ lọc cao áp 0.47uF/275Vac/15mm Metallized Polypropylene Film Capacitor |  | 2 |  |  |  | THT
 |  | C9 | Tụ lọc cao áp 2.2uF/275Vac/27mm Metallized Polypropylene Film Capacitor |  | 1 |  |  |  | THT
 |  | C13, C14, C15 | Tụ cao áp 103/10nF/2KV/8mm | CLA1234 | 3 | Linhkienchatluong |  |  | THT |  |  | 400
 |  | E1, E12, E13 | Tụ hoá 4.7uF/50V/5x10mm |  | 3 |  |  |  | THT
 |  | E2, E5, E10, E11 | Tụ hoá 47uF/50V/6.5x12mm |  | 4 |  |  |  | THT
 |  | E3 | Tụ hoá 100uF/35V/6.5x12mm |  | 1 |  |  |  | THT
 |  | E4 | Tụ hoá 4700uF/35V/18x25MM |  | 1 |  |  |  | THT
 |  | E6, E7 | Tụ hoá 47uF/500V/18x25MM |  | 2 |  |  |  | THT
 |  | E8, E9 | tụ hoá 1000uF/35V/10x22MM |  | 2 |  |  |  | THT
2 | Diode | D1, D2, D3, D4, D13, D14, D15, D16 | DIODE RS1M 1000V/1A/DO214AC-SMA |  | 8 |  |  |  | SMT
 |  | D5, D6, D9, D10 | DIODE chỉnh lưu SF58 600V/5A |  | 4 |  |  |  | THT
 |  | D7, D8, D11, D12, D17, D18, D20 | DIODE Xung 1N4148-T4 100V/2A/SOD-123 |  | 7 |  |  |  | SMT
 |  | D19 | DIODE P6KE6 600W/T-18, Axial | CLA1525 | 1 | Linhkienchatluong |  |  | THT |  |  | 1800
3 | Header | H5 | Header đực 5P XH2.54-5P chân thẳng | CLA1881 | 1 | Linhkienchatluong |  |  | THT |  |  | 2500
 |  | H6 | Header đực 2P XH2.54-2P chân thẳng | CLA1878 | 1 | Linhkienchatluong |  |  | THT |  |  | 1500
4 | Transformer | T1 | Biến áp xung 600W | VC23116 | 1 | VICOILS |  |  | THT
 |  | PT1 | Biến áp đo điện áp ZHTPT107 |  | 1 |  |  |  | THT
5 | Common Mode Choke | L1 | Cuận Kháng lọc | VC23115 | 1 | VICOILS |  |  | THT
6 | Current Transformer | L2 | Cản biến dòng 1:25 | VC23114 | 1 | VICOILS |  |  | THT
7 |  | CT1 | Cảm biến dòng 1:3000 |  | 1 |  |  |  | THT
8 | Mosfet | M1, M2, M3, M4 | N-Channel Power MOSFET CS1404 202A/40V/TO-220AB |  | 4 |  |  |  | THT
 |  | VS1, VS2, VS3, VS4 | N-Channel Power MOSFET CS25N50 500V/25A/TO-220AB |  | 4 |  |  |  | THT |  |  | 1.65$/200pcs
9 | Transistor | Q1, Q3, Q5 | TRANSISTOR D882 NPN 30V/3A/SOT-89 |  | 3 | IBS technology |  |  | SMT |  |  | 0.18$/200pcs
 |  | Q2, Q4 | TRANSISTOR B772 PNP 30V/3A/SOT-89 |  | 2 | IBS technology |  |  | SMT |  |  | 0.18$/200pcs
10 | Resistor | R1, R57 | - Resistor 2K/0.25W/1% 0805 - Tape type for auto insertion machine |  | 2 |  |  |  | SMT
 |  | R2, R4, R18, R52, R61 | - Resistor 10K/0.125W/1% 0805 - Tape type for auto insertion machine |  | 5 |  |  |  | SMT
 |  | R3, R58, R60 | - Resistor 200R/0.125W/5% 0805 - Tape type for auto insertion machine |  | 3 |  |  |  | SMT
 |  | R5 | - Resistor 4K99/0.125W/1% 0805 - Tape type for auto insertion machine |  | 1 |  |  |  | SMT
 |  | R7, R8, R9 | - Resistor 200K/0.125W/5% 0805 - Tape type for auto insertion machine |  | 3 |  |  |  | SMT
 |  | R11 | - Resistor 20K/0.125W/1% 0805 - Tape type for auto insertion machine |  | 1 |  |  |  | SMT
 |  | R12, R22 | - Resistor 100R/0.125W/5% 0805 - Tape type for auto insertion machine |  | 2 |  |  |  | SMT
 |  | R13, R14, R15, R25, R29, R55 | - Resistor 10R/0.125W/5% 0805 - Tape type for auto insertion machine |  | 6 |  |  |  | SMT
 |  | R30 | Trở dán-0.033 ôm-2W-1%-2512 |  | 1 |  |  |  | SMT
 |  | R20, R21, R24, R26, R32, R33, R34, R35 | - Resistor 20R/0.125W/5% 0805 - Tape type for auto insertion machine |  | 8 |  |  |  | SMT
 |  | R10, R16, R17, R27, R28, R31, R36, R37,R56 | - Resistor 4K7/0.125W/5% 0805 - Tape type for auto insertion machine |  | 9 |  |  |  | SMT
 |  | R49, R50 | - Resistor 47K/0.125W/5% 0805 - Tape type for auto insertion machine |  | 2 |  |  |  | SMT
 |  | R23 | - Resistor 470K/0.125W/5% 0805 - Tape type for auto insertion machine |  | 1 |  |  |  | SMT
 |  | R38, R59, R62 | - Resistor 1K/0.125W/1% 0805 - Tape type for auto insertion machine |  | 3 |  |  |  | SMT
 |  | R6,R39, R40, R46, R47, R51 | - Resistor 51K/0.125W/5% 0805 - Tape type for auto insertion machine |  | 6 |  |  |  | SMT
 |  | R48, R54 | - Resistor 100K/0.125W/5% 0805 - Tape type for auto insertion machine |  | 2 |  |  |  | SMT
 |  | R53 | - Resistor 6K8/0.125W/5% 0805 - Tape type for auto insertion machine |  | 1 |  |  |  | SMT
11 | Rheostat | VR1 | Biến trở dán 3x3mm 20K ôm EVM3ESX50B24 | CLA3213 | 1 | Linhkienchatluong |  |  | SMT |  |  | 1500
12 | Sensor Temp | RT1 | Cảm biến nhiệt độ |  | 1 |  |  |  | THT
13 | IC | U3 | Shunt Voltage Reference IC TL431 36V ±1% SOT-23-3 | TL431G-AE2-R | 1 | IBS technology |  |  | SMT |  |  | 0.1$/200pcs
 |  | U1, U2, U5, U6 | Single Opto FL817/SOP4 |  | 4 |  |  |  | SMT |  |  | 0.17$/200pcs
 |  | U4 | IC nguồn ổn áp 78M12/12V/1A/TO252 | 78R12G-TN3-R | 1 | IBS technology |  |  | SMT |  |  | 0.25$/200pcs
 |  | U7 | IC so sánh LM358 Dual, 32-V, 1-MHz op ampb SOP8 |  | 1 |  |  |  | SMT
14 | Fuse | Fu1, Fu2 | Cầu chì dẹp 40A chân to | CL06592 | 2 | Linhkienchatluong |  |  | THT |  |  | 2000
15 | Mạch PCB FR4 | PCB | Phíp thủy tinh FR4-1.6mm, mạ thiếc, Size: 199x132mm |  | 1

Sheet: DCDC
 |  |  | DANH SÁCH LINH KIỆN - VẬT TƯ BILL OF MATERIALS |  |  |  |  |  | Số hiệu:
Đơn vị: TT R&D Chiếu Sáng |  |  | Sản phẩm: BOARD ĐIỀU KHIỂN DCDC INVERTER 500W NỘI ĐỊA |  |  |  |  |  | Model:
STT No. | Name | Ký hiệu Designator | Mô tả - đặc tính kỹ thuật Description - Specification | Mã linh kiện Part Number (chính/dự phòng) | Định mức | Nhà cung cấp Vendor |  | Mức độ kiểm soát/ Control level | Ghi chú | Mã ERP | Tên hàng hóa + Model | Báo giá
 |  |  |  |  |  | Chính Preferable | Dự phòng Alternative
I. | Mạch Điều khiển DCDC
1 | Header | P1 | Jump đực đơn 2.54mm 1x40P chân cong | 00034937 | 1 |  |  |  | THT
 |  | P3 | IDE10 đực cong 2.54mm | CLA2540 | 1 | Linhkienchatluong |  |  | THT |  |  | 0.05$/100pcs
2 | IC | AMS1 | IC nguồn ổn áp AMS1117 3.3V/1A/SOT223 |  | 1 |  |  |  | SMT
 |  | IC1 | IC đo dòng điện, điện áp, tần số BL0937 3.3V/1.7mA/SOP-8 |  | 1 |  |  |  | SMT
 |  | U1 | MCU AMP32F030CCT6 48-pin LQFP-48 |  | 1 | IBS teachnology |  |  | SMT |  |  | 1.6$
 |  | U2 | IC nguồn dao động SG3525AN 40V/500mA/SOP-16 |  | 1 | IBS teachnology |  |  | SMT
 |  | U3 | IC nguồn 78M05/5V/1A/TO-252 |  | 1 | IBS teachnology |  |  | SMT |  |  | 0.25$/200pcs
3 | Capacitor | C1, C3, C4, C13, C16, C17, C18 | CAP 22uF/25V/10%/1206 |  | 7 |  |  |  | SMT
 |  | C2, C5, C6, C7, C8, C15, C19, C21, C23 | CAP 104-100nF/25V/10%/0805 | 00018342 | 9 |  |  |  | SMT
 |  | C11 | CAP 103-10nF/25V/1%/0805 |  | 1 |  |  |  | SMT
 |  | C12 | CAP 103-10nF/25V/10%/0805 |  | 1 |  |  |  | SMT
 |  | C22 | CAP 105-1uF/25V/10%/0805 |  | 1 |  |  |  | SMT
4 | Resistor | R1, R9, R26, R15, R22 | Resistor 4K7/5%/0805 |  | 5 |  |  |  | SMT
 |  | R2, R3, R5, R13, R24, R27, R28 | Resistor 10K/1%/0805 |  | 7 |  |  |  | SMT
 |  | R4 | Resistor 20K/1%/0805 |  | 1 |  |  |  | SMT
 |  | R6 | Resistor 5K6/1%/0805 |  | 1 |  |  |  | SMT
 |  | R8, R10 | Resistor 510R/5%/0805 |  | 2 |  |  |  | SMT
 |  | R11, R19 | Resistor 1K/1%/0805 |  | 2 |  |  |  | SMT
 |  | R12, R25 | Resistor 51K/5%/0805 |  | 2 |  |  |  | SMT
 |  | R14 | Resistor 100K/5%/0805 |  | 1 |  |  |  | SMT
 |  | R16 | Resistor 100R/5%/0805 |  | 1 |  |  |  | SMT
 |  | R17 | Resistor 6K8/5%/0805 |  | 1 |  |  |  | SMT
 |  | R18 | Resistor 200R/5%/0805 |  | 1 |  |  |  | SMT
 |  | R20 | Resistor 2K2/5%/0805 |  | 1 |  |  |  | SMT
 |  | R21,R23 | Resistor 10R/5%/0805 |  | 2 |  |  |  | SMT
5 | DIODE | D1 | FR207 S2M-SMA Diode xung 2A/1000V/DO-214AA(SMB) |  | 1 |  |  |  | SMT
6 | LED | LED1 | LED dán 0805 màu đỏ |  | 1 |  |  |  | SMT
7 | Buzz | LS1 | Còi Xung 3V 8.5x8.5x3 MLT-8530 | MLT-8530 | 1 | jiangsu |  |  | SMT |  |  | 0.17$/150pcs
8 | Transistor | Q1 | Transistor J3Y/S8050 0.5A/40V SOT-23 |  | 1 |  |  |  | SMT
9 | Rheostat | VR1,VR2 | Biến trở dán 3x3mm 10K Ôm EVM3ESX50B14 | CLA3212 | 2 | Linhkienchatluong |  |  | SMT |  |  | 0.048$/100pcs
10 | Mạch PCB FR4 | PCB | Phíp thuỷ tinh FR4-1.6mm, mạ thiếc, Size: 60.8x31.5mm |  | 1

Sheet: SPWM
 |  |  | DANH SÁCH LINH KIỆN - VẬT TƯ BILL OF MATERIALS |  |  |  |  |  | Số hiệu:
STT No. | Name | Ký hiệu Designator | Mô tả - đặc tính kỹ thuật Description - Specification | Mã linh kiện Part Number (chính/dự phòng) | Định mức | Nhà cung cấp Vendor |  | Mức độ kiểm soát/ Control level | Ghi chú | Mã ERP | Tên hàng hóa + Model | Báo giá
 |  |  |  |  |  | Chính Preferable | Dự phòng Alternative
I. | Mạch Điều khiển SPWM
1 | Header | H2 | Jump đực đơn 2.54mm 1x40P chân cong | 00034937 | 1 |  |  |  | THT
2 | Capacitor | C1, C2, C9, C22,C10, C11 C13, C14, C15, C21, C25, C28 | Capacitor 104-100nF/25V/10%/0805 | 00018342 | 12 |  |  |  | SMT
 |  | C3, C4,C23 | Capacitor 22uF/25V/10%/1206 |  | 3 |  |  |  | SMT
 |  | C12, C18 | Capacitor Tantalum 22uF/25V/10%/1210(3528) 3.5x2.8mm |  | 2 | IBS technology |  |  | SMT |  |  | 0.62$/200pcs
 |  | C17 | Capacitor 470nF/10V/10%/0805 |  | 1 |  |  |  | SMT
 |  | C19, C20 | Capacitor 20pF/10V/10%/0603 |  | 2 |  |  |  | SMT
 |  | C24, C26, C27 | Capacitor 103-10nF/25V/10%/0805 |  | 3 |  |  |  | SMT
3 | Resistor | R1, R3, R5, R8,R19 | Resistor 3K/5%/0805 |  | 5 |  |  |  | SMT
 |  | R2, R4, R7, R9 | Resistor 4R7/5%/0805 |  | 4 |  |  |  | SMT
 |  | R6, R10, R17 | Resistor 1K/1%/0805 |  | 3 |  |  |  | SMT
 |  | R11,R20 | Resistor 510R/5%/0805 |  | 2 |  |  |  | SMT
 |  | R13,R14,R15,R22, R24 | Resistor 10K/1%/0805 |  | 5 |  |  |  | SMT
 |  | R16 | Resistor 30K/5%/0805 |  | 1 |  |  |  | SMT
 |  | R18 | Resistor 270K/5%/0805 |  | 1 |  |  |  | SMT
 |  | R21,R25 | Resistor 4K7/5%/0805 |  | 2 |  |  |  | SMT
 |  | R23 | Resistor 51K/5%/0805 |  | 1 |  |  |  | SMT
4 | DIODE | D1, D4 | DIODE xung S2M/1000V/2A/DO-214 |  | 2 |  |  |  | SMT
 |  | D2 | DIODE xung 1N4148-T4 100V/2A/SOD-123 |  | 1 |  |  |  | SMT
 |  | D3 | DIODE zener BZT52C3V3-W3 3.3V/500mW/SOD-123 |  | 1 |  |  |  | SMT
5 | IC | IC1, IC2 | IC Driver IR2113S 600V/2A/SOIC-16 |  | 2 | IBS technology |  |  | SMT |  |  | 1.52$/200pcs
 |  | IC3 | MCU APM32F030CCT6 48-pin LQFP-48 |  | 1 | IBS technology |  |  | SMT |  |  | 1.6$
 |  | U1 | IC nguồn 78M05 5V/1A/TO-252 |  | 1 | IBS technology |  |  | SMT |  |  | 0.25$/200pcs
 |  | U2 | IC nguồn LM1117 3.3V/800mA/SOT-89 |  | 1 |  |  |  | SMT
 |  | U3,U4 | IC so sánh LM393 36V/20mA/SOP-8 |  | 2 | IBS technology |  |  | SMT |  |  | 0.12$/200pcs
6 | Transistor | Q1,Q2 | Transistor J3Y/S8050 0.5A/40V SOT-23 |  | 2 |  |  |  | SMT
7 | Crystal | X1 | Thạch anh 8Mhz HC-49S DIP | CLA1571 | 1 | Linhkienchatluong |  |  | THT |  |  | 0.07$/100pcs
8 | LED | LED1 | LED dán 0805 màu đỏ |  | 1 |  |  |  | SMT
9 | Mạch PCB FR4 | PCB | Phíp thuỷ tinh FR4-1.6mm, mạ thiếc, Size 60.4x32.4mm |  | 1

Sheet: Vật Tư Khác
 |  |  | DANH SÁCH LINH KIỆN - VẬT TƯ BILL OF MATERIALS |  |  |  |  |  | Số hiệu:
STT No. | Name | Ký hiệu Designator | Mô tả - đặc tính kỹ thuật Description - Specification | Mã linh kiện Part Number (chính/dự phòng) | Định mức | Nhà cung cấp Vendor |  | Mức độ kiểm soát/ Control level | Ghi chú | Mã ERP | Tên hàng hóa + Model | Báo giá
 |  |  |  |  |  | Chính Preferable | Dự phòng Alternative
I. | Vật Tư Khác
1 | Header |  | Dây IDE10 10P 30cm chân 2.54mm bấm sẵn đầu cốt | CLA3943 | 1 | Linhkienchatluong |  |  |  |  |  | 6000
 |  |  | Dây Bus 5P XH2.54 dây 22AWG 1 đầu cắm | CL06921, CLA2437 | 1 | Linhkienchatluong |  |  |  |  |  | 4500
2 | Swich Power |  | Nút nhấn nguồn nhấn thả có đèn LED |  | 1
3 | LCD - HT1621 |  | Màn hình hiển thị LCD | JDA0801-16037C1 | 1 | JDA LCM R&D CENTER
4 | Ổ cắm đôi |  | Ổ cắm đôi đầu ra 220VAC |  | 1
5 | Dây nguồn Ắc Quy |  | Dây Silicon 8 AWG (6-7mm) màu đỏ |  | 1 | Shopee
 |  |  | Dây Silicon 8 AWG (6-7mm) màu xanh |  | 1 | Shopee
6 | Đầu COS |  | Đầu Cos SC6-8 đường kính lỗ bắt ốc vít: 8mm |  | 2 | Shopee |  |  |  |  |  | 2000
 |  |  | Đầu Cos SC6-6 đường kính lỗ bắt ốc vít: 6mm |  |  |  |  |  |  |  |  | 1800
 |  |  | Cốt kim lỗ 3.2mm VE4009 màu đỏ | CL09432 | 1 | Linhkienchatluong |  |  |  |  |  | 200
 |  |  | Cốt kim lỗ 3.2mm VE4009 màu xanh | CL09433 | 1 | Linhkienchatluong |  |  |  |  |  | 200
7 | Tiếp địa |  | Dây tiếp địa |  | 1
8 | Bộ vỏ |  | Bộ vỏ |  | 1
9 | Tản nhiệt |  | Tấm tản nhiệt cho Mosfet |  | 2
10 | Quạt |  | Quạt tản nhiệt DC 12V/50mA |  | 1
11 | Cầu đấu |  | TERMINAL hàn mạch 4 chân lỗ M5 - 70A | CL08833 (https://dgtelian.en.made-in-china.com/product/ImWYusCDXbVU/China-Welding-Tab-Terminal-M5-Pure-Copper-Tinned-Soldering-Terminal-Four-Pins-PCB-Wire-Connector-Sc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) | 2 | Linhkienthanhcong |  |  |  |  |  | 5000
 |  |  | Bộ đầu cắm đực – cái 6.3mm(tìm kiếm lại) |  | 2
12 | Ốc vít |  | Ốc vít M3 cho thanh tản nhiệt 2 tầng |  | 8
 |  |  | Vòng đệm cách điện TO220 | CLA2158 | 4 | Linhkienchatluong |  |  |  |  |  | 100
 |  |  | Bulong lục giác đầu bắt vít |  | 2 |  |  |  |  |  |  | 860
 |  |  | Ốc vít tiếp địa |  | 1

Sheet: SAP
 | Mã SAP | Description
CAP | 00018342 | Tụ dán-104K-50V-X7R-0805 | v
 | 00022393 | Tụ dán 470nF/50V- F (0805) | v
 | 00022388 | Tụ dán 22pF/50V- Y (0805) | v
 | 00021491 | Tụ dán-103K-50V-X7R-0805 | v
 | 00018305 | Tụ dán-105K-50V-X7R-0805 | v
 |  | tụ dán 22uF-50V-1206
RES | 00022014 | Trở dán-0.033 ôm-2W-1%-2512 | v
 | 00002490 | Trở dán-10 ôm-0.25W-5%-1206-FH | R15
 | 00024007 | Trở dán-10 ôm-0.125W-5%-0805 | k.ddtd
 | 00024307 | Trở dán-100 ôm-0.125W-5%-0805 | v
 | 00022169 | Trở dán-1 K.ôm-0.125W-1%-0805 | v
 | 00022220 | Trở dán-10 K.ôm-0.125W-1%-0805 | có thể dùng 5% - K.s
 | 00022212 | Trở dán-100 K.ôm-0.125W-5%-0805 | v
 | 00022226 | Trở dán-18 ôm-0.125W-1%-0805 | thay thế 20R - k.s v
 | 00034994 | Trở dán-4.7 ôm-0.125W-1%-0805 | thay thế 4R7 5% - K.ddtd
 | 00022200 | Trở dán-4.7 K.ôm-0.125W-5%-0805 | kho hết 1%, có thể dùng 5%
 | 00022208 | Trở dán-47 K.ôm-0.125W-5%-0805 | k.ddtd
 | 00022219 | Trở dán-470 K.ôm-0.125W-5%-0805 | v
 | 00041207 | Trở dán-200 ôm-0.125W-5%-0805 | v
 | 00040122 | Trở dán-2 K.ôm-0.25W-1%-0805 | kho sẵn 1% v
 | 00022159 | Trở dán-2.2 K.ôm-0.125W-5%-0805 | v
 | 00040129 | Trở dán-20 K.ôm-0.25W-1%-0805 | v
 | 00022217 | Trở dán-270 K.ôm-0.125W-5%-0805 | v
 | 00022170 | Trở dán-510 ôm-0.125W-5%-0805 | v
 | 00022260 | Trở dán-5.6 K.ôm-0.125W-1%-0805 | v
 | 00022209 | Trở dán-51 K.ôm-0.125W-5%-0805 | v
 | 00022201 | Trở dán-6.8 K.ôm-0.125W-5%-0805 | v
 | 00026181 | Trở dán-3 K.ôm-0.125W-5%-0805 | v
 | 00021515 | Trở dán-30 k.ôm-0.125W-5%-0805 | v
 | 00040746 | Transistor PMBT2222A (SOT-23) | 0.6A-40V thay thế S8050 (giao thiếu)
 | 00042987 | Con LED Green FC-DA1608UGK-520D10 | Faill
 | 00042988 | Con LED đỏ FC-DA1608HRK-620D | Faill
 | 00022303 | IC dán LM358DR | v
 | 00043650 | IC nguồn SCJT1117B-3.3 (SOT-223) | k đặt
 | 00039721 | IC nguồnAZ1117CR-3.3V (SOT89) | v
 | 00022318 | IC dán L78M05CTD-1 | Faill
 | 00044704 | Diode zener-BZT52C3V3-T-S (SOD123) | v
 | 00018308 | Diode-1N4148WS-T-S | v
 | 00034937 | Jump đực đơn 2.54mm 1x40P chân cong | v
 | 00020498 | IC-TL431 (SMT) | v
 | 00022003 | Điot cắm SF58 | k đặt
 | 00002022 | Diode-RS1MA-T-S-HY | cũ quá
 | 00002091 | Tụ hóa-22MF-50V-LY-6.3x12-B-10-FH | v
Bộ sạc PWM Hybrid
 | 00022006 | Điot dán BZT52C12S-7-F | Faill
 | 00022360 | Transitor BCP56-16.115 | v
 | 00022364 | Tranzitor dán MMBT8050D | v
 | 00037156 | Tranzitor MMBT5551L-SOT23 | v
 | 00022359 | Tranzitor BC857 | v (test lại)
 | 00022542 | IC dán HT7133-1/SOT89 | v
 | 00057486 | Diode TVS SMBJ100A-SMB-600W | v
 | 00002005 | Diode-1N4007-T-S-HY | Faill
 | 00047542 | Trở dán-0 ôm-0.5W-1%-2010-FH | Faill - 1210
 | 00039907 | Trở dán-100 ôm-0.1W-5%-0603 | v
 | 00029830 | Trở dán-1 K.ôm-0.1W-5%-0603 | v
 | 00032524 | Trở dán-10 k.ôm-0.1W-5%-0603 | Giao thiếu
 | 00002521 | Trở dán-10 K.ôm-0.25W-5%-1206-FH | v
 | 00038273 | Trở dán-15 K.ôm-0.1W-5%-0603 | thay cho 16K (v)
 | 00032533 | Trở dán-100 K.ôm-0.1W-1%-0603 | v
 | 00002491 | Trở dán-100 K.ôm-0.25W-5%-1206-FH | thay thế 1%
 | 00022249 | Trở dán-150 K.ôm-0.25W-1%-1206 | thay thế 200K
 | 00002452 | Trở dán-1 M.ôm-0.25W-5%-1206-FH | v
 | 00002584 | Trở dán-30 ôm-0.25W-5%-1206-VH | v
 | 00002551 | Trở dán-3.9 ôm-0.25W-1%-1206-FH | thay 3.6R v
 | 00043569 | Trở dán-470 ôm-0.1W-5%-0603 | v
 | 00032535 | Trở dán-4.7 K.ôm-0.1W-5%-0603 | v
 | 00029811 | Trở dán-47 K.ôm-0.1W-1%-0603 | thay cho 5% v
 | 00025179 | Trở dán-20 K.ôm-0.25W-5%-1206-FH | v

Sheet: Sheet1
 |  | PHIẾU YÊU CẦU MUA LINH KIỆN THỬ NGHIỆM |  |  |  | Số : MTN……...2021
 |  | Đơn vị đề nghị: TRUNG TÂM R&D CHIẾU SÁNG |  |  |  | PR
STT No. | Name | Mô tả - đặc tính kỹ thuật Description - Specification | Mã linh kiện Part Number (chính/dự phòng) | Định mức (quantity) | Nhà cung cấp Vendor | Liên kết (Link)
1 | Capacitor | Tụ cao áp 103/10nF/2KV/8mm | CLA1234 |  | linhkienchatluong | linhkienchatluong (https://linhkienchatluong.vn/tu-cao-ap/tu-cao-ap-2kv103-10nf-2000v_sp638_ct2446.aspx)
 |  | Tụ hóa 35V/1000uF/10x25mm | ERJ1VM102G25OT |  | AiShi
 |  | Tụ hoá 500V/47uF/18x30/10000hrs | EGN2HM470M30OT |  | AiShi
 |  | Tụ hoá 35V/1800uF/18x20/10000hrs | ERS1VM182M20OT |  | AiShi
 |  | Tụ gốm 50V/22uF/1206 | 1206B226K500NT |  | Fenghua
 |  | Capacitor Tantalum 22uF/25V/10%/1210(3528) 3.5x2.8mm | CA45B226K200T |  | Fenghua
2 | Diode | DIODE P6KE6 600W/T-18, Axial | P6KE6.8 |  | M.C.C
 |  | Diode FR2M-L - 1000V/2A | FR2M-L |  | M.C.C
3 | Transistor | TRANSISTOR D882 NPN 30V/3A/SOT-89 | D882 |  | Unisonic - UTC
 |  | TRANSISTOR B772 PNP 30V/3A/SOT-89 | B772 |  | Unisonic - UTC
4 | IC | Shunt Voltage Reference IC TL431 36V ±1% SOT-23-3 | TL431 |  | Unisonic - UTC
 |  | IC nguồn ổn áp 5V/1A/TO252 | 78R05 |  | Unisonic - UTC
 |  | IC nguồn ổn áp 12V/1A/TO252 | 78R12 |  | Unisonic - UTC
 |  | IC nguồn ổn áp 5V/1.5A/TO-252 | 78D05 |  | Unisonic - UTC
 |  | IC so sánh LM393/SOP8 | LM393 |  | Unisonic - UTC
 |  | IR2113S SOP-16 chính hãng IR | CL06725 |  | linhkienchatluong | linhkienchatluong (https://linhkienchatluong.vn/ic-driver/ir2113s-sop-16-chinh-hang-ir_sp568_ct8900.aspx)
5 | Khác | Cầu chì dẹp 40A 32V chân to cho ô tô, xe máy | CL06594 |  | linhkienchatluong | linhkienchatluong (https://linhkienchatluong.vn/cau-chi-dep-o-to-xe-may/cau-chi-dep-40a-32v-chan-to-cho-o-to-xe-may_sp996_ct8706.aspx)
 |  | Biến trở dán 3x3mm 10K EVM3ESX50B14 | CLA3212 |  | linhkienchatluong | linhkienchatluong (https://linhkienchatluong.vn/bien-tro-dan-evm3e-3x3mm/bien-tro-dan-3x3mm-10k-evm3esx50b14_sp904_ct4481.aspx)
 |  | Nhiệt điện trở NTC | BT103F3435B30 |  | Fenghua
Tổng số lượng mẫu: |  |  |  | 0
DUYỆT (nếu cần) |  |  | ĐƠN VỊ MUA HÀNG |  | Ngày tháng năm 2023
 |  |  | P.KDTV |  | P. ĐƠN VỊ ĐỀ NGHỊ
 |  |  |  |  | Nguyễn Hồng Thu
