OnePice-C/INV.5KW/(list of files, cad)

Other CAD files:
INV.5KW.OG.Design/firmware/FW.INV.HR.V1.0/use.main/CPU1_FLASH/inv_hr_main.obj
INV.5KW.OG.Design/firmware/FW.INV.HR.V1.0/use.main/CPU1_RAM/inv_hr_main.obj
INV.5KW.OG.Design/firmware/exemple/sinv_F28P55x/RELEASE/syscfg/device.obj
INV.5KW.OG.Design/firmware/FW.INV.HR.V1.0/use.main/CPU1_FLASH/device/device.obj
INV.5KW.OG.Design/firmware/FW.INV.HR.V1.0/use.main/CPU1_FLASH/syscfg/c2000ware_libraries.obj
INV.5KW.OG.Design/firmware/FW.INV.HR.V1.0/use.main/CPU1_RAM/controler_CL.obj
INV.5KW.OG.Design/firmware/FW.INV.HR.V1.0/use.main/CPU1_RAM/device/device.obj
INV.5KW.OG.Design/firmware/FW.INV.HR.V1.0/use.main/CPU1_RAM/syscfg/board.obj
INV.5KW.OG.Design/firmware/exemple/sinv_F28P55x/RELEASE/syscfg/board.obj
INV.5KW.OG.Design/firmware/FW.INV.HR.V1.0/use.main/CPU1_FLASH/controler_CL.obj
INV.5KW.OG.Design/firmware/FW.INV.HR.V1.0/use.main/CPU1_FLASH/device/f28p65x_codestartbranch.obj
INV.5KW.OG.Design/firmware/FW.INV.HR.V1.0/use.main/CPU1_FLASH/syscfg/board.obj
INV.5KW.OG.Design/firmware/FW.INV.HR.V1.0/use.main/CPU1_RAM/device/f28p65x_codestartbranch.obj
INV.5KW.OG.Design/firmware/FW.INV.HR.V1.0/use.main/CPU1_RAM/syscfg/c2000ware_libraries.obj
INV.5KW.OG.Design/firmware/exemple/sinv_F28P55x/RELEASE/syscfg/device_cmd.obj
INV.5KW.OG.Design/firmware/exemple/sinv_F28P55x/RELEASE/syscfg/c2000ware_libraries.obj
