OnePice-C/INV.5KW/Doc.Design.INV.OFG/DAB-SCH.pdf

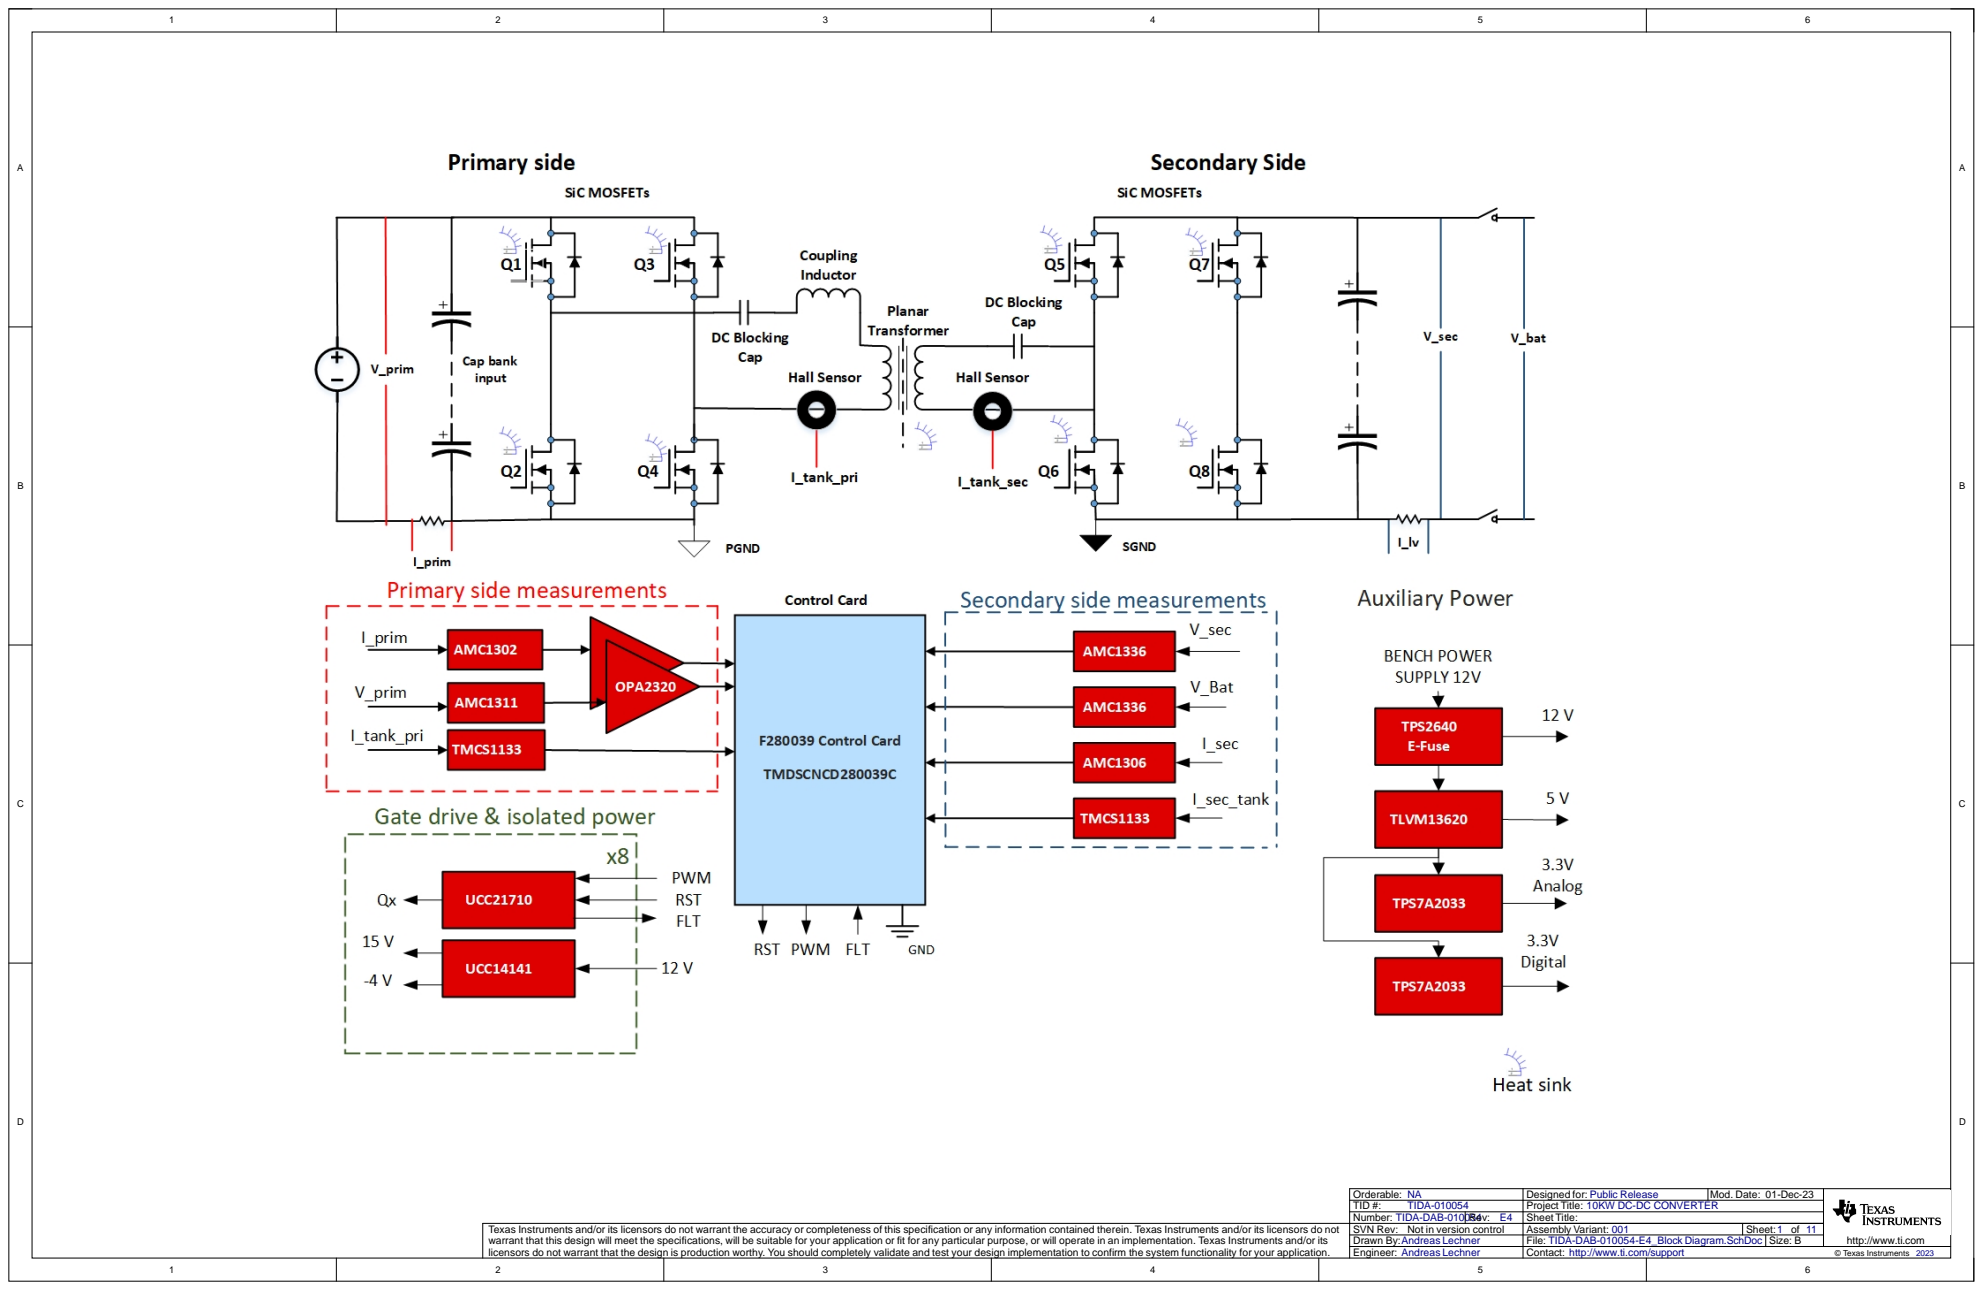
[picture p87: page 1]

Designed for: Public Release

TID #: TIDA-010054 | Project Title: 10KW DC-DC CONVERTER
Number: TIDA-DAB-010054 Rev: E4 | | Sheet Title:
SVN Rev: Not in version control | Assembly Variant: 001 | Sheet: of

Texas Instruments and/or its licensors do not warrant the accuracy or completeness of this specification or any information contained therein. Texas Instruments and/or its licensors do not
warrant that this design will meet the specifications, will be suitable for your application or fit for any particular purpose, or will operate in an implementation. Texas Instruments and/or its
licensors do not warrant that the design is production worthy. You should completely validate and test your design implementation to confirm the system functionality for your application.

TIDA-DAB-010054-E4_Block Diagram.SchDoc
File:
Contact: http://www.ti.com/support

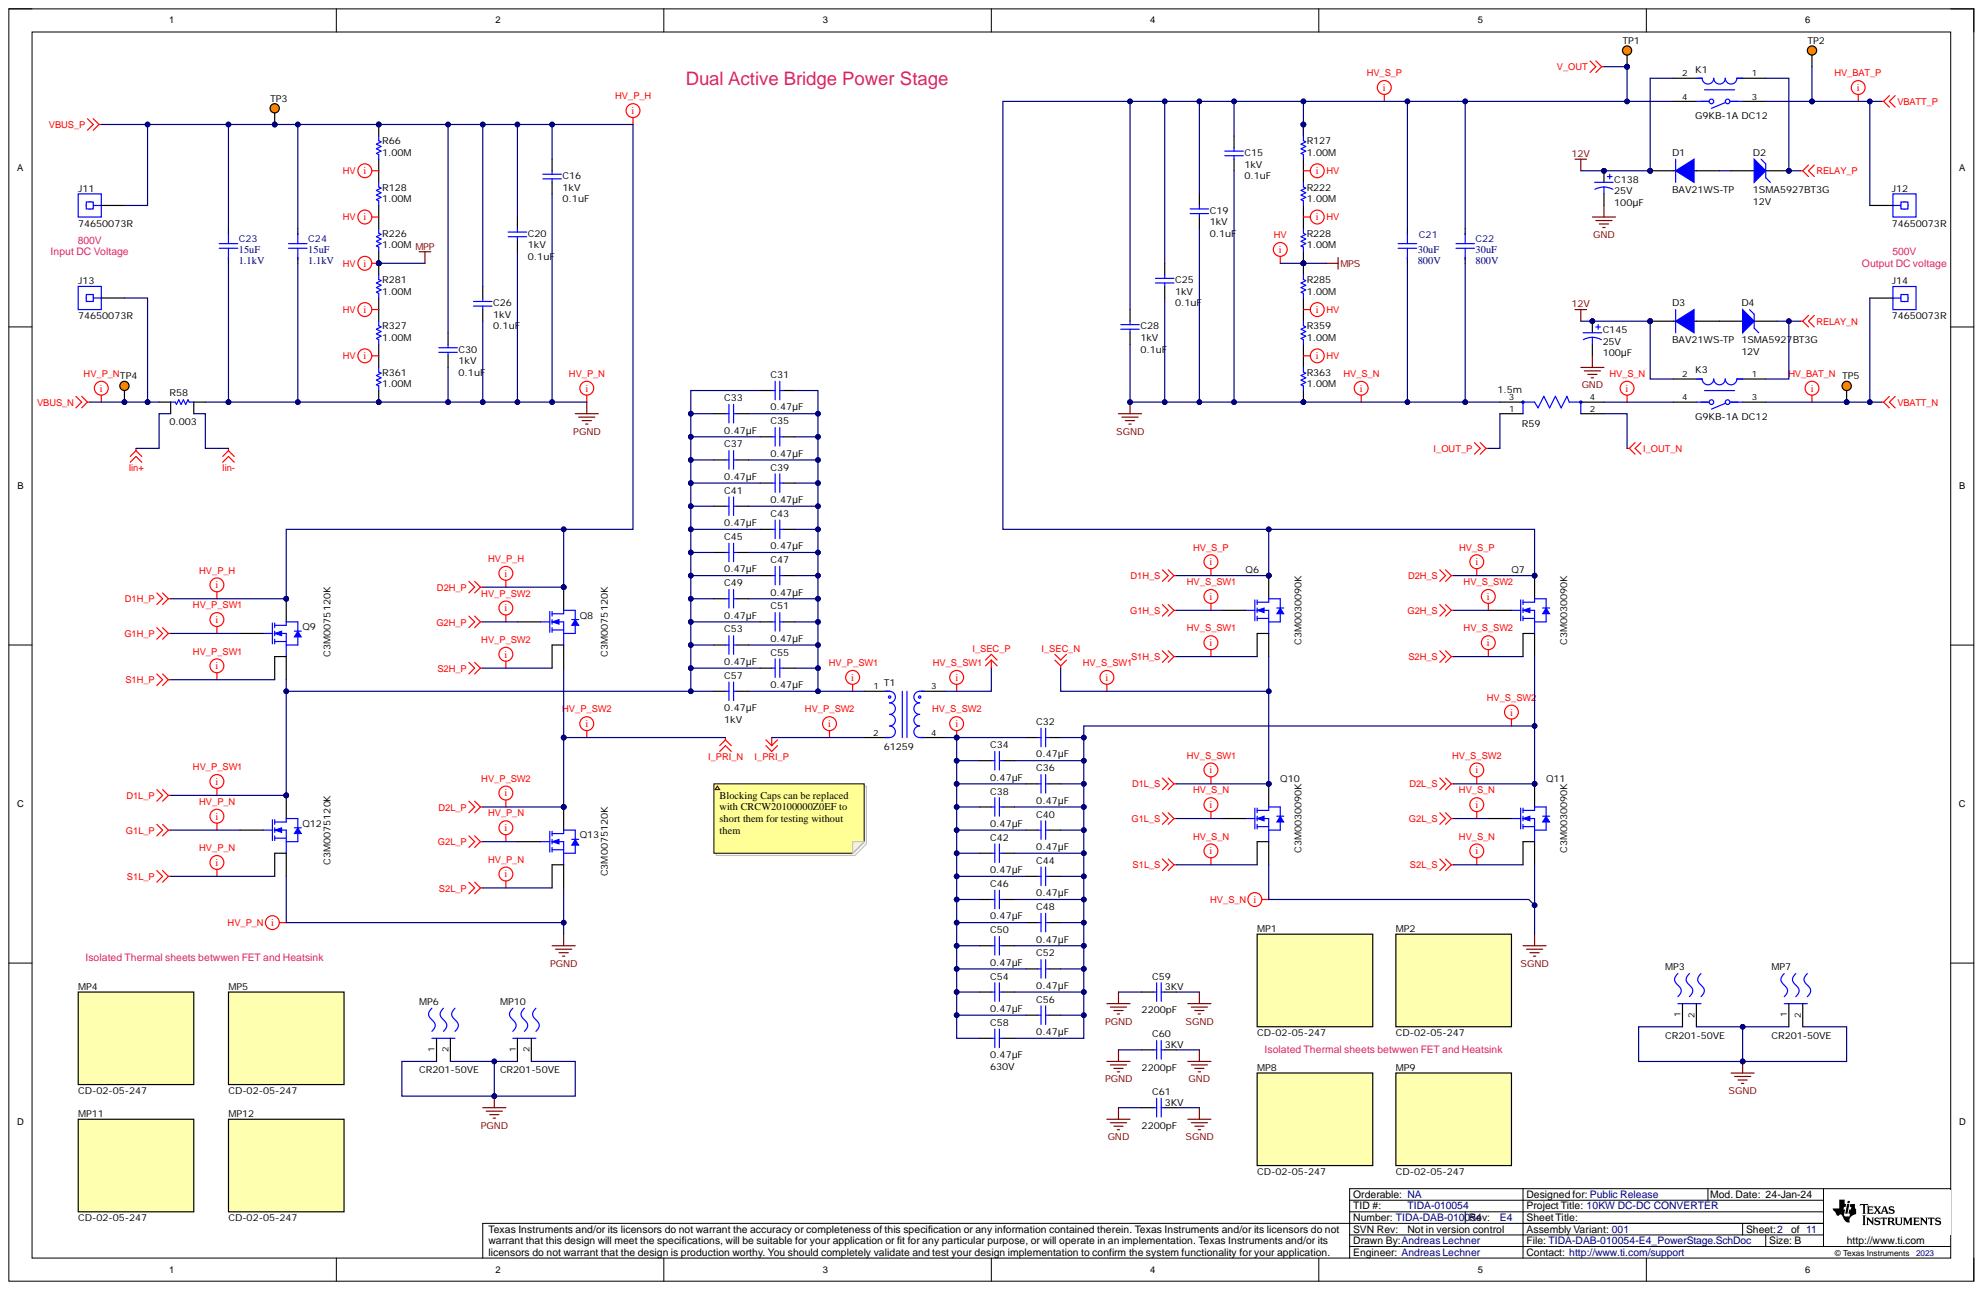
[picture p88: page 2]

Dual Active Bridge Power Stage

Blocking Caps can be replaced
with CRCW20100000Z0EF to
short them for testing without
them

TID TIDA-010054 | Project 0KW DC-DC CONVER TER
Number TIDA-DAB-010054 Rev: E4 | | Sh e et Title :
SVN Rev: Not in versio ntro l | Assembly Varia nt: 001 | eet

http://www.ti.com

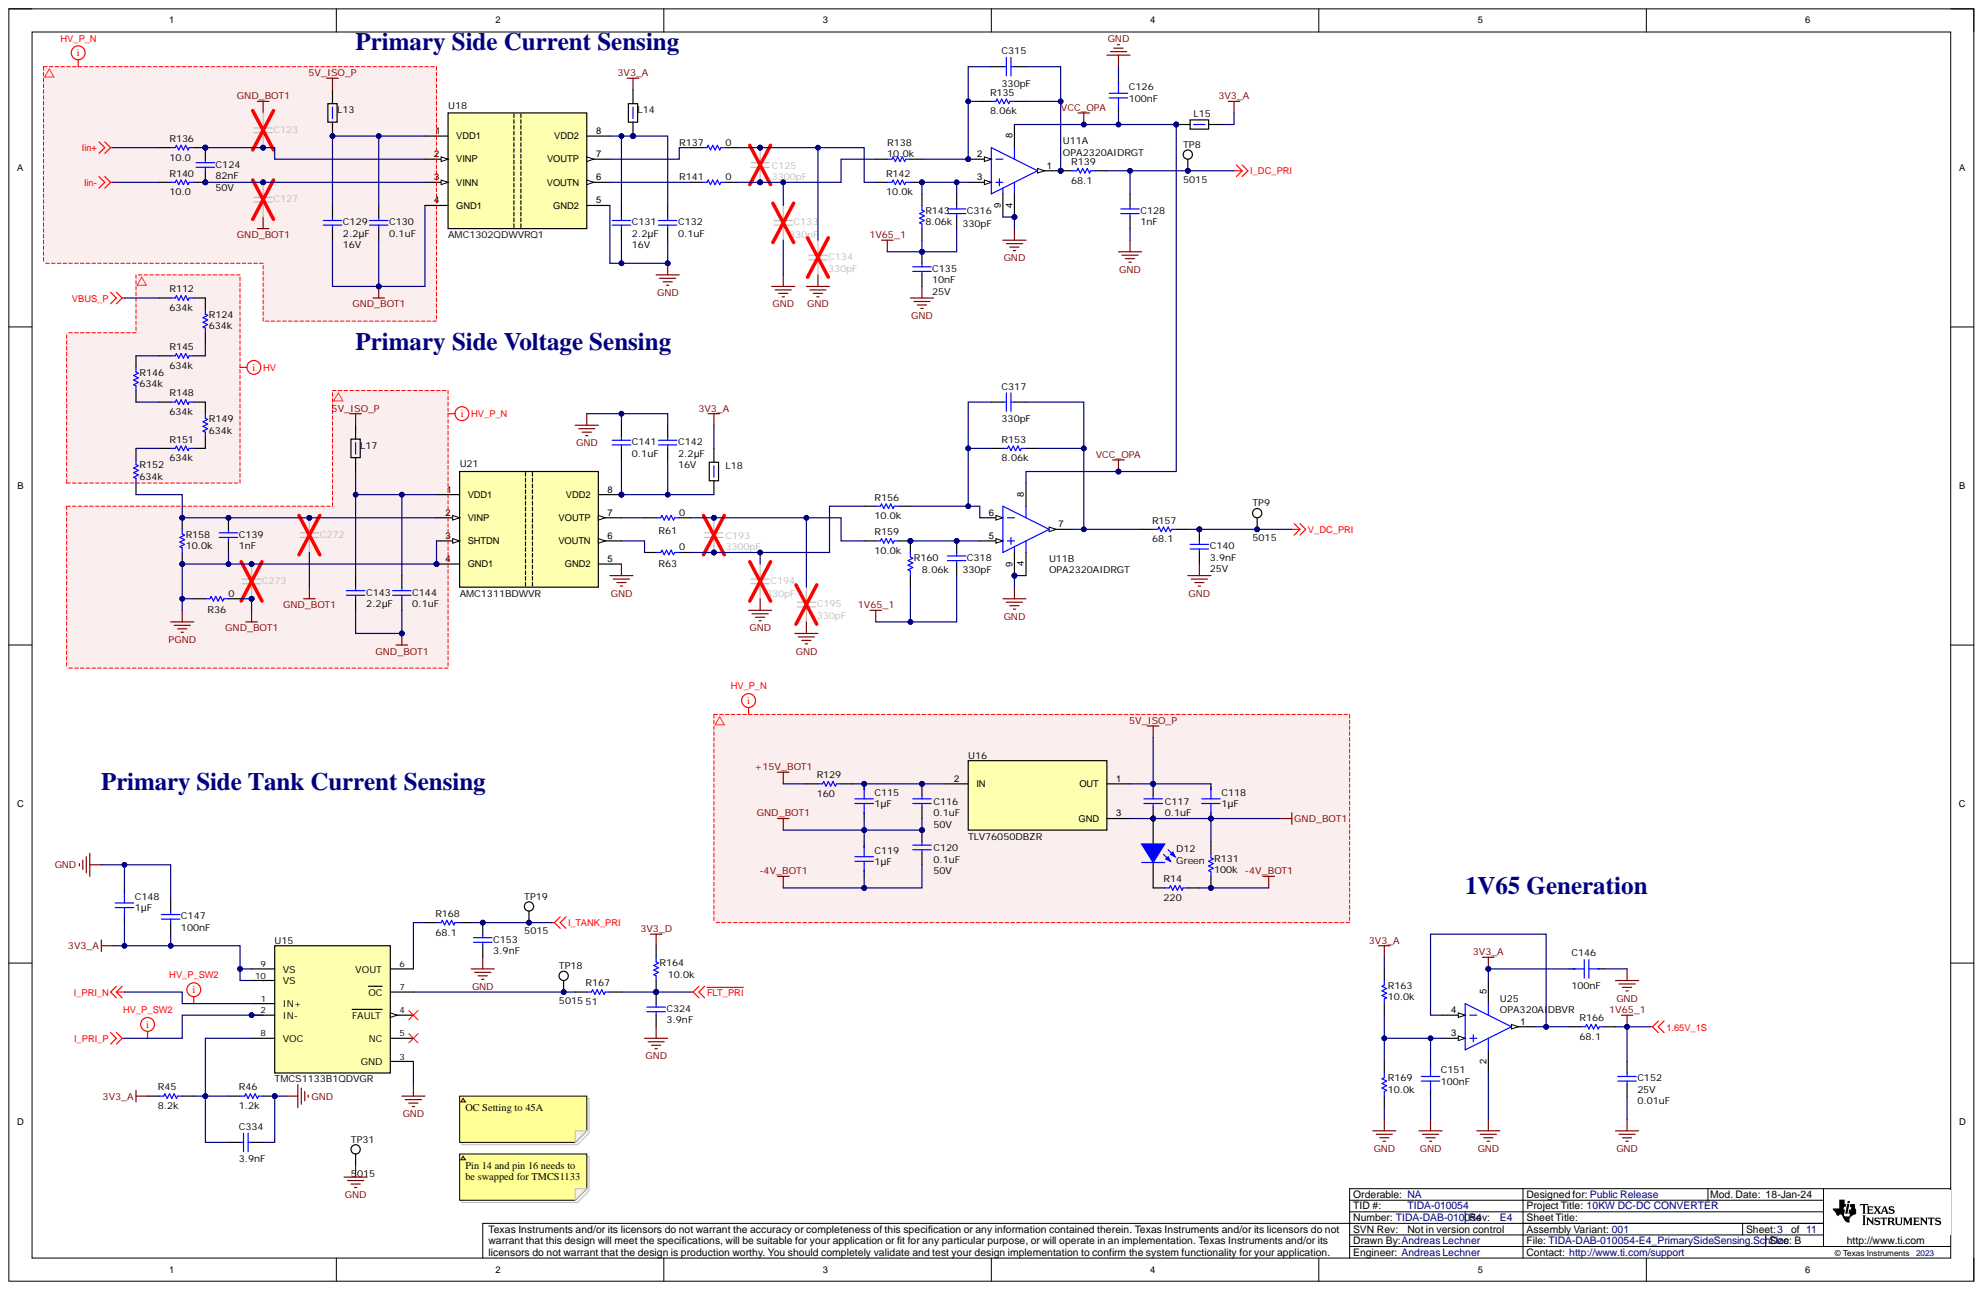
[picture p89: page 3]

Primary Side Current Sensing

GND_BOT1
Primary Side Voltage Sensing

Primary Side Tank Current Sensing

Pin 14 and pin 16 needs to
be swapped for TMCS1133

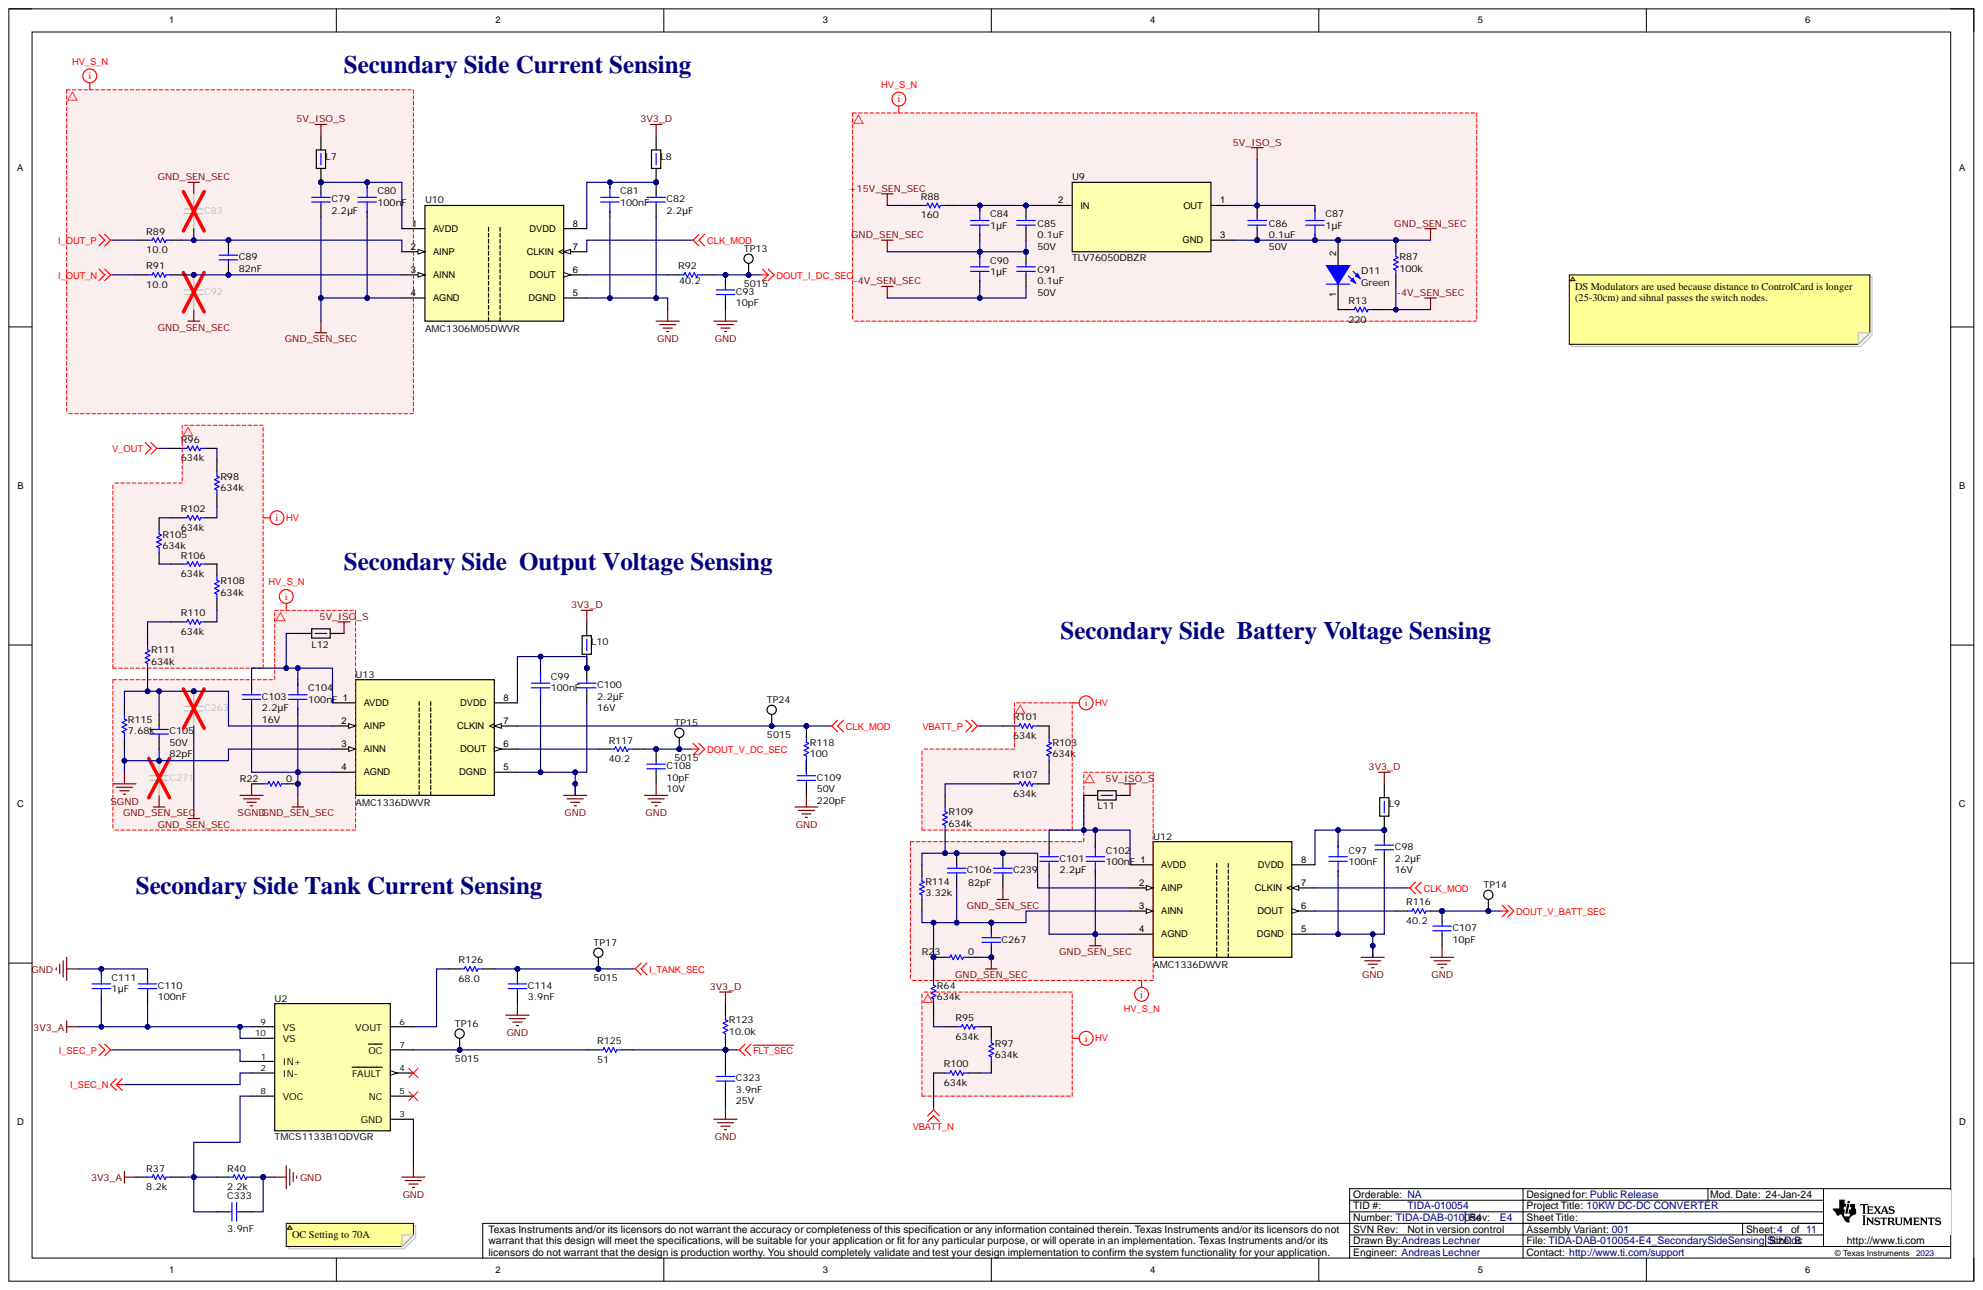
[picture p90: page 4]

Secundary Side Current Sensing

AINP 2

DS Modulators are used because distance to ControlCard is longer
(25-30cm) and sihnal passes the switch nodes.

Secondary Side Output Voltage Sensing

Secondary Side Tank Current Sensing

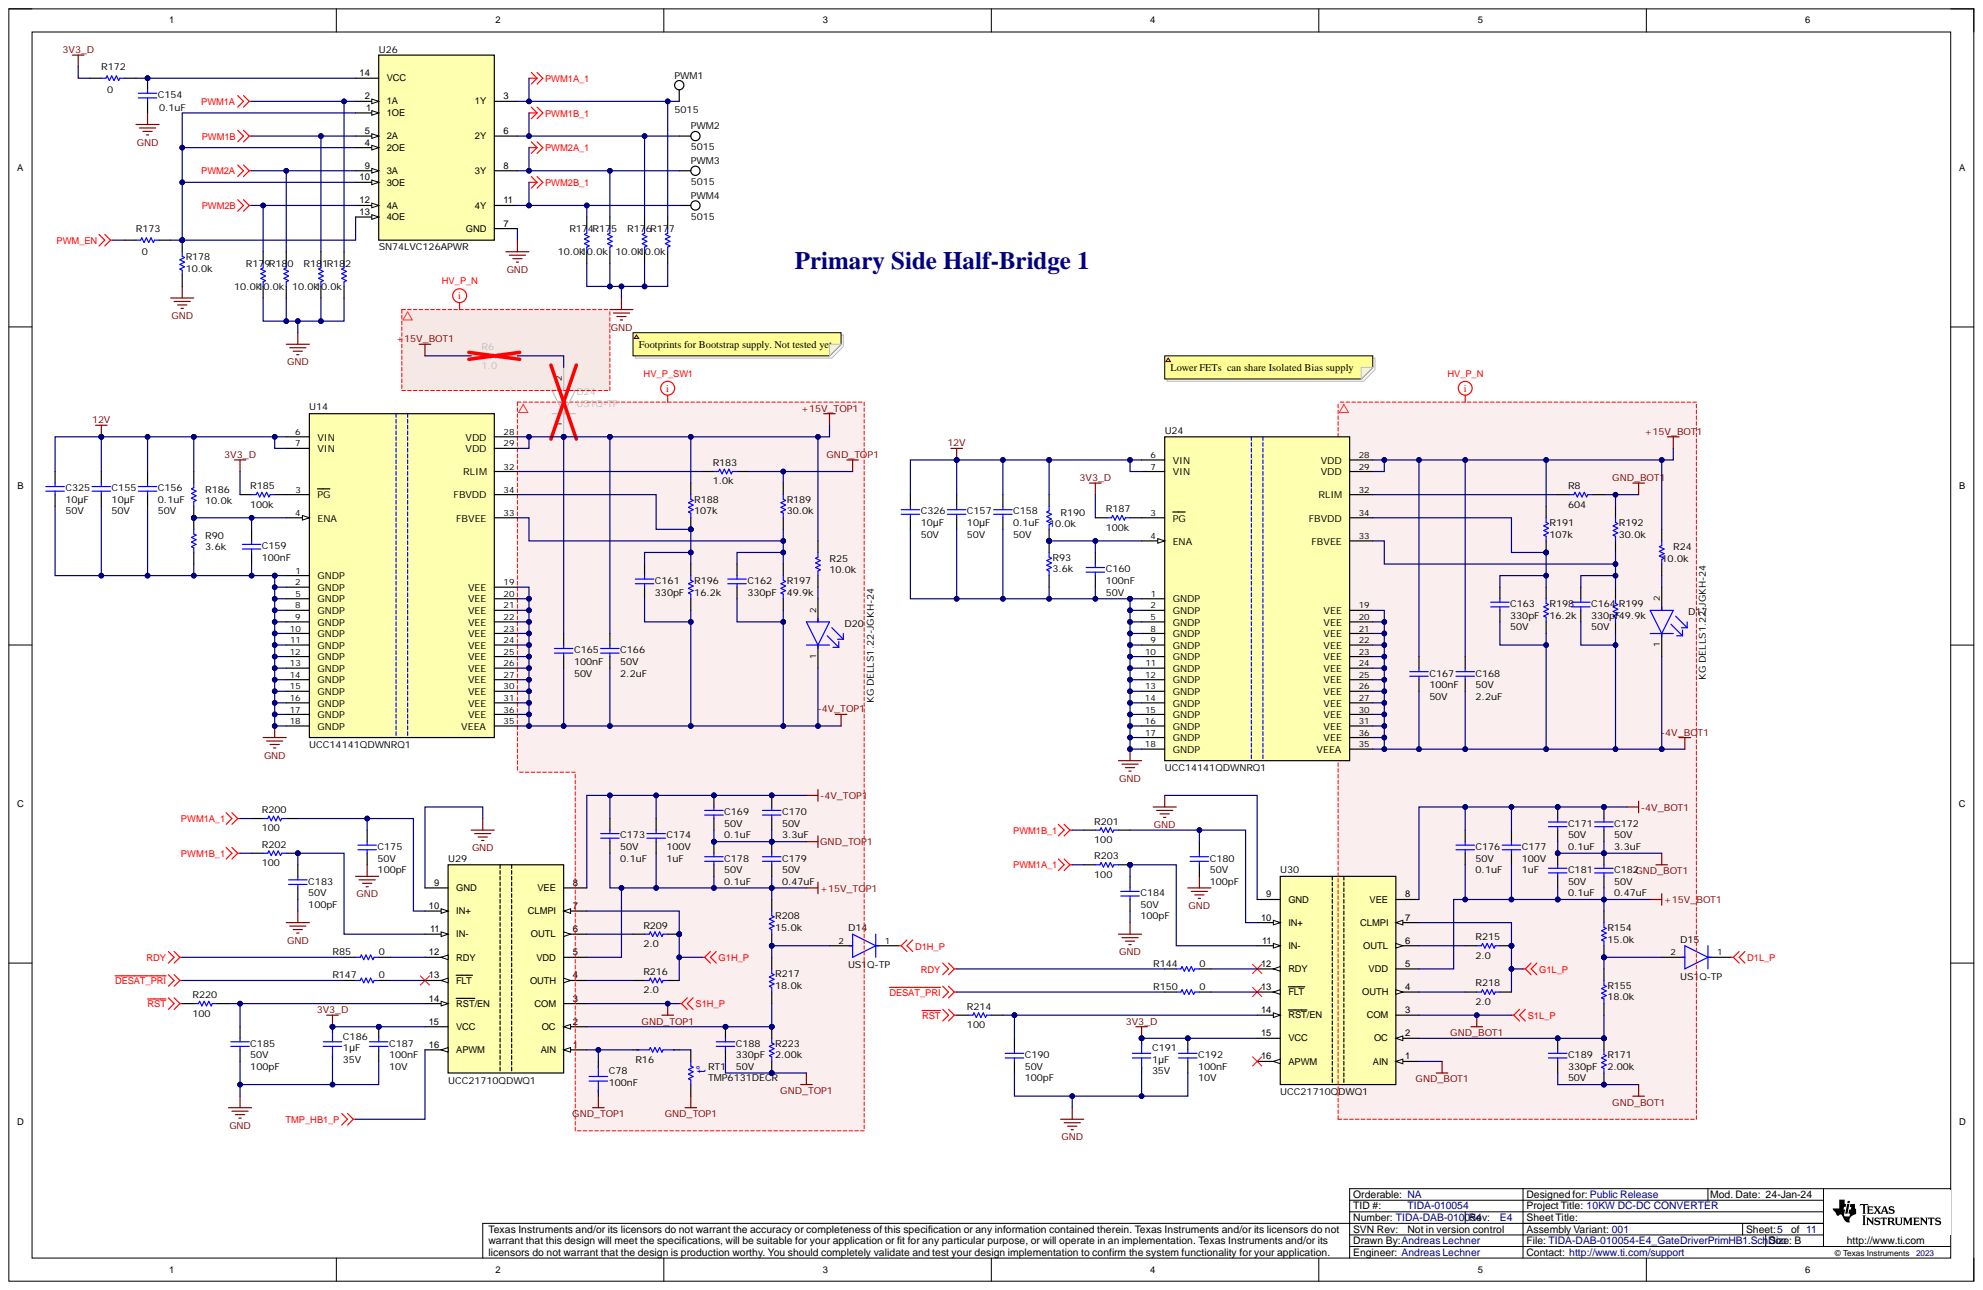
[picture p91: page 5]

Primary Side Half-Bridge 1

GND
Footprints for Bootstrap supply. Not tested yet

Lower FETs can share Isolated Bias supply

US1Q-TP +15V_TOP1

U24 VIN 6

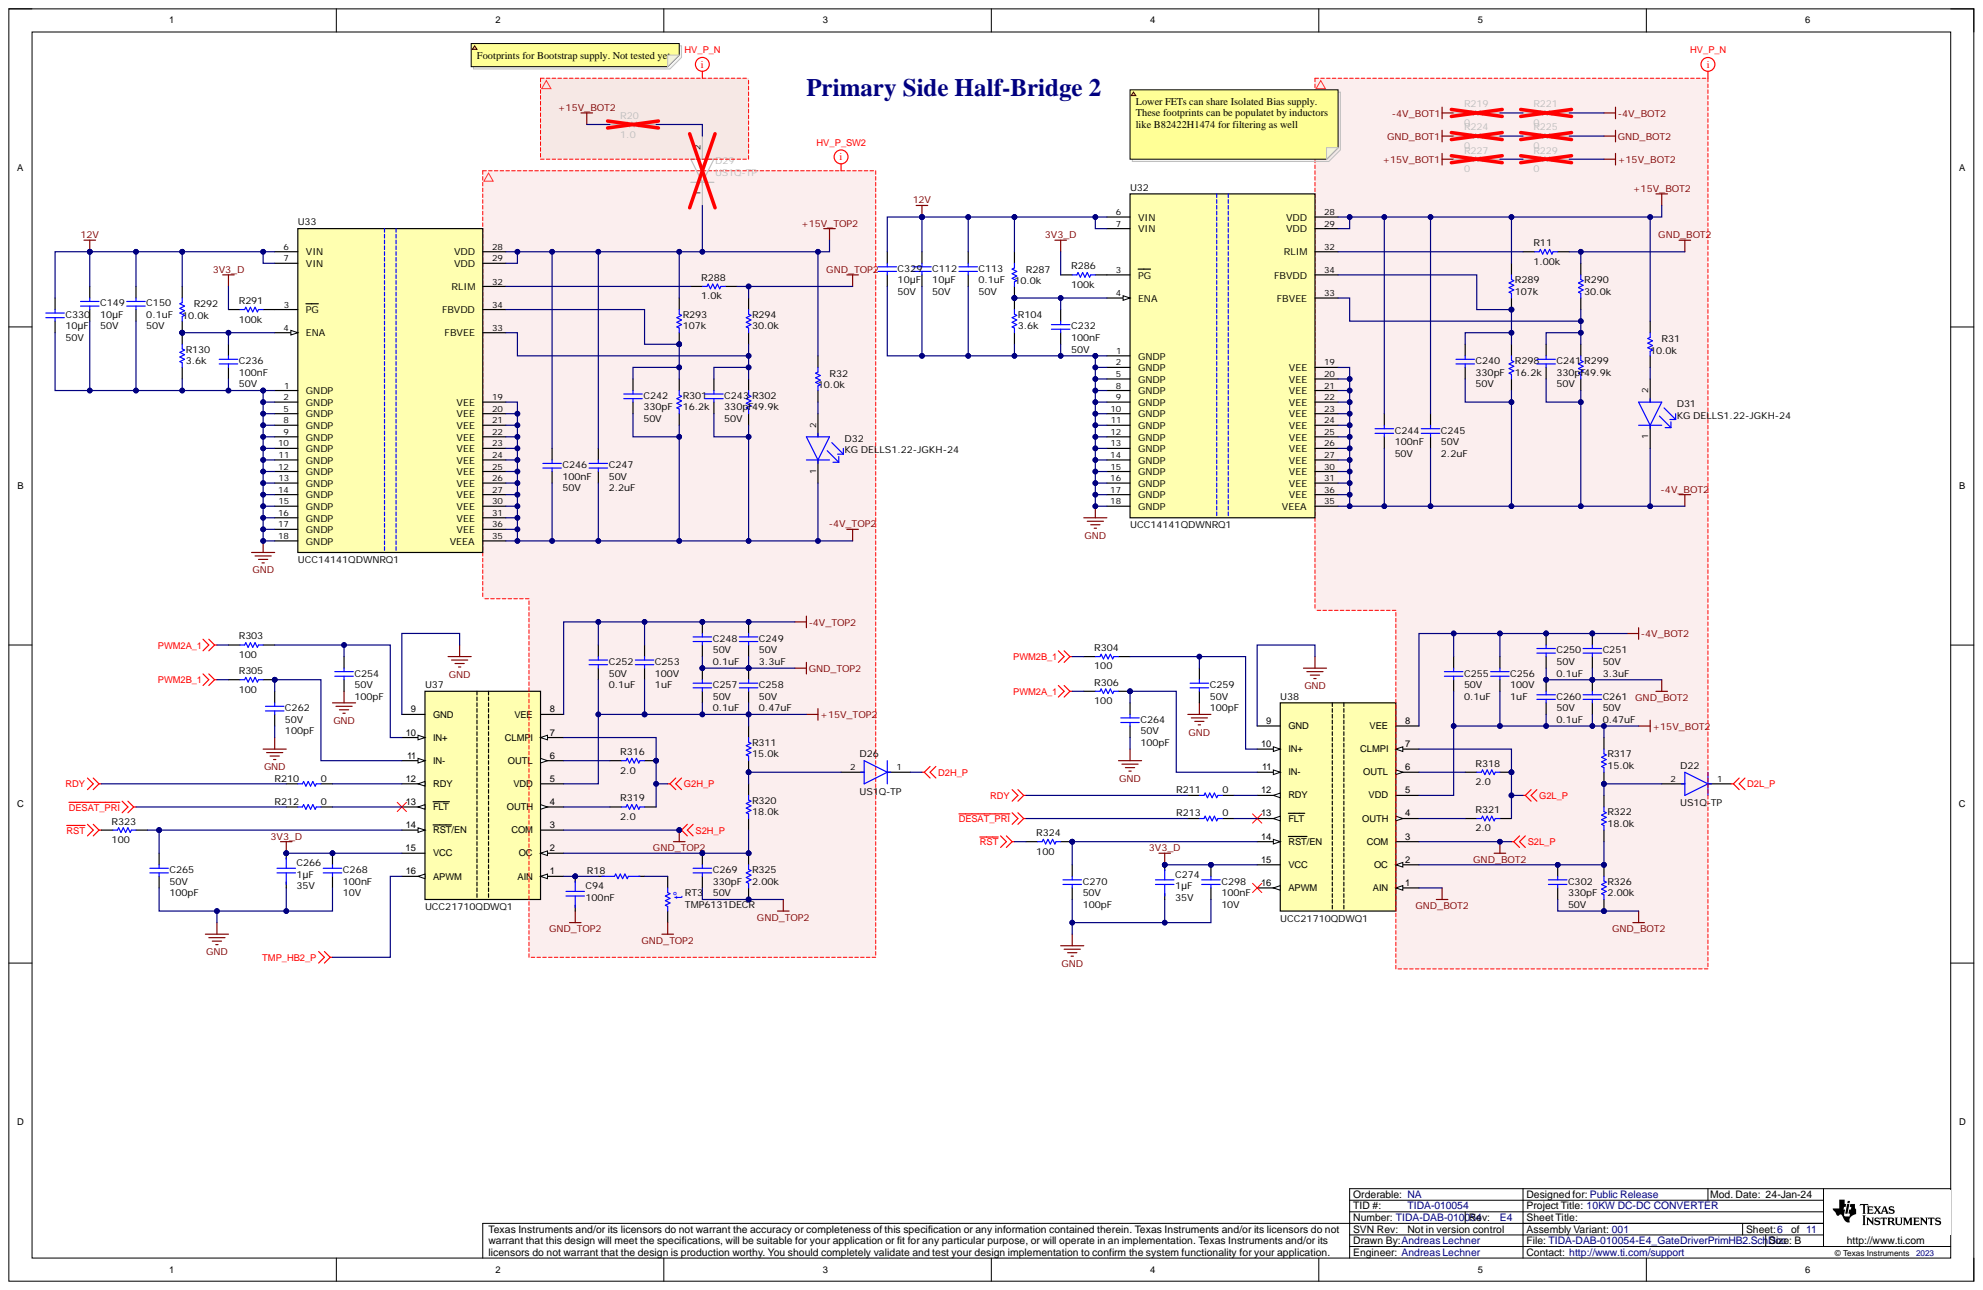
[picture p92: page 6]

Footprints for Bootstrap supply. Not tested yet

Primary Side Half-Bridge

Lower FETs can share
These footprints can be populatet by inductors
like B82422H1474 for filtering as well

CLM P OUT V D D OUT N CO M O C AI N | E I L H | 7 IN+ 1 APWM

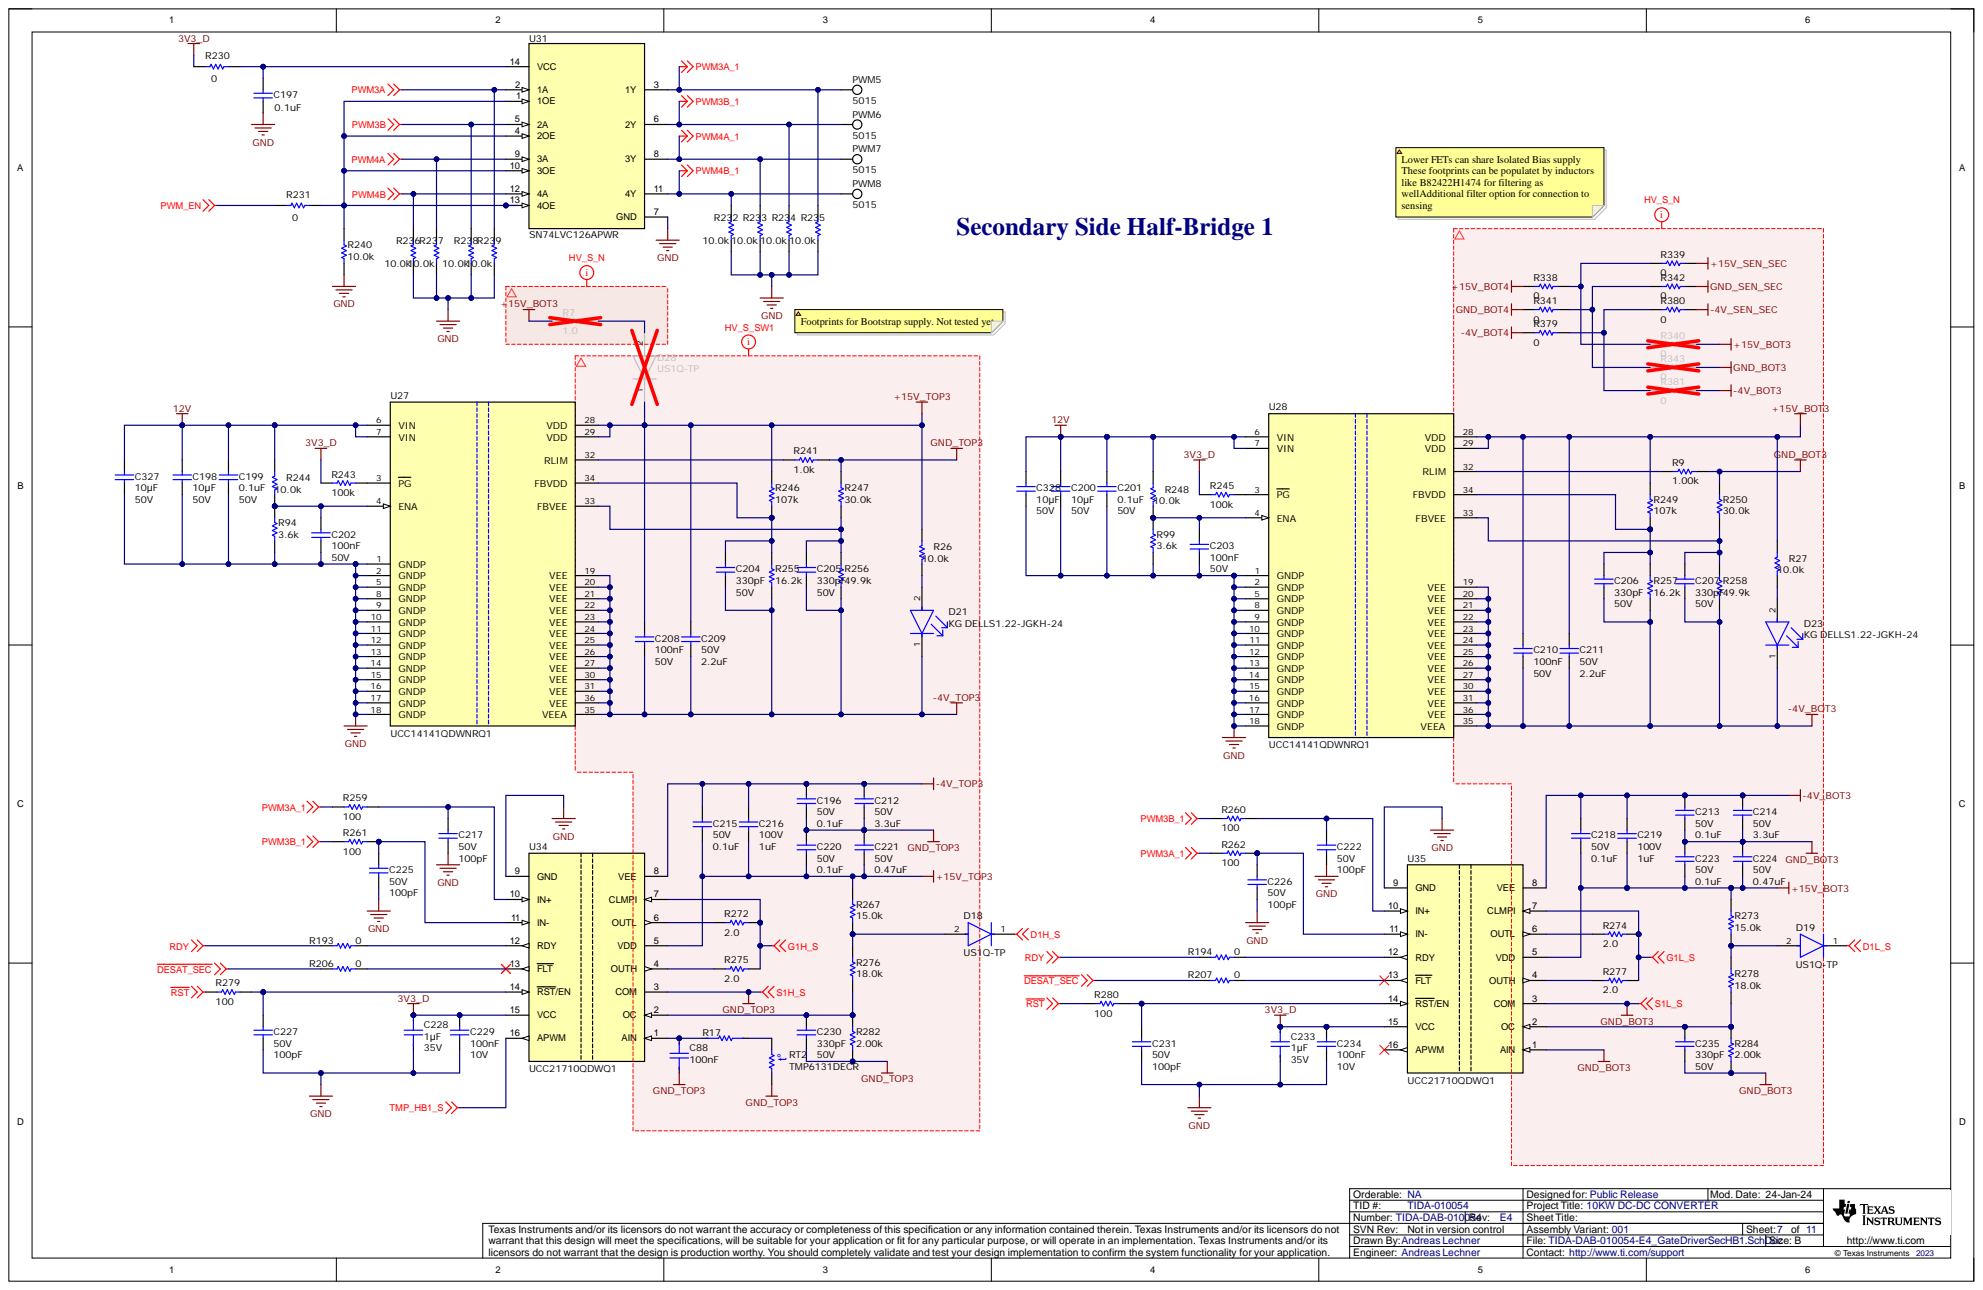
[picture p93: page 7]

PWM3B | 2A 5

PWM4A

Lower FETs can share Isolated Bias supply
These footprints can be populatet by inductors
like B82422H1474 for filtering as
wellAdditional filter option for connection to
sensing

Secondary Side Half-Bridge 1

Footprints for Bootstrap supply. Not tested yet

VIN 7 | R241 R246 107k

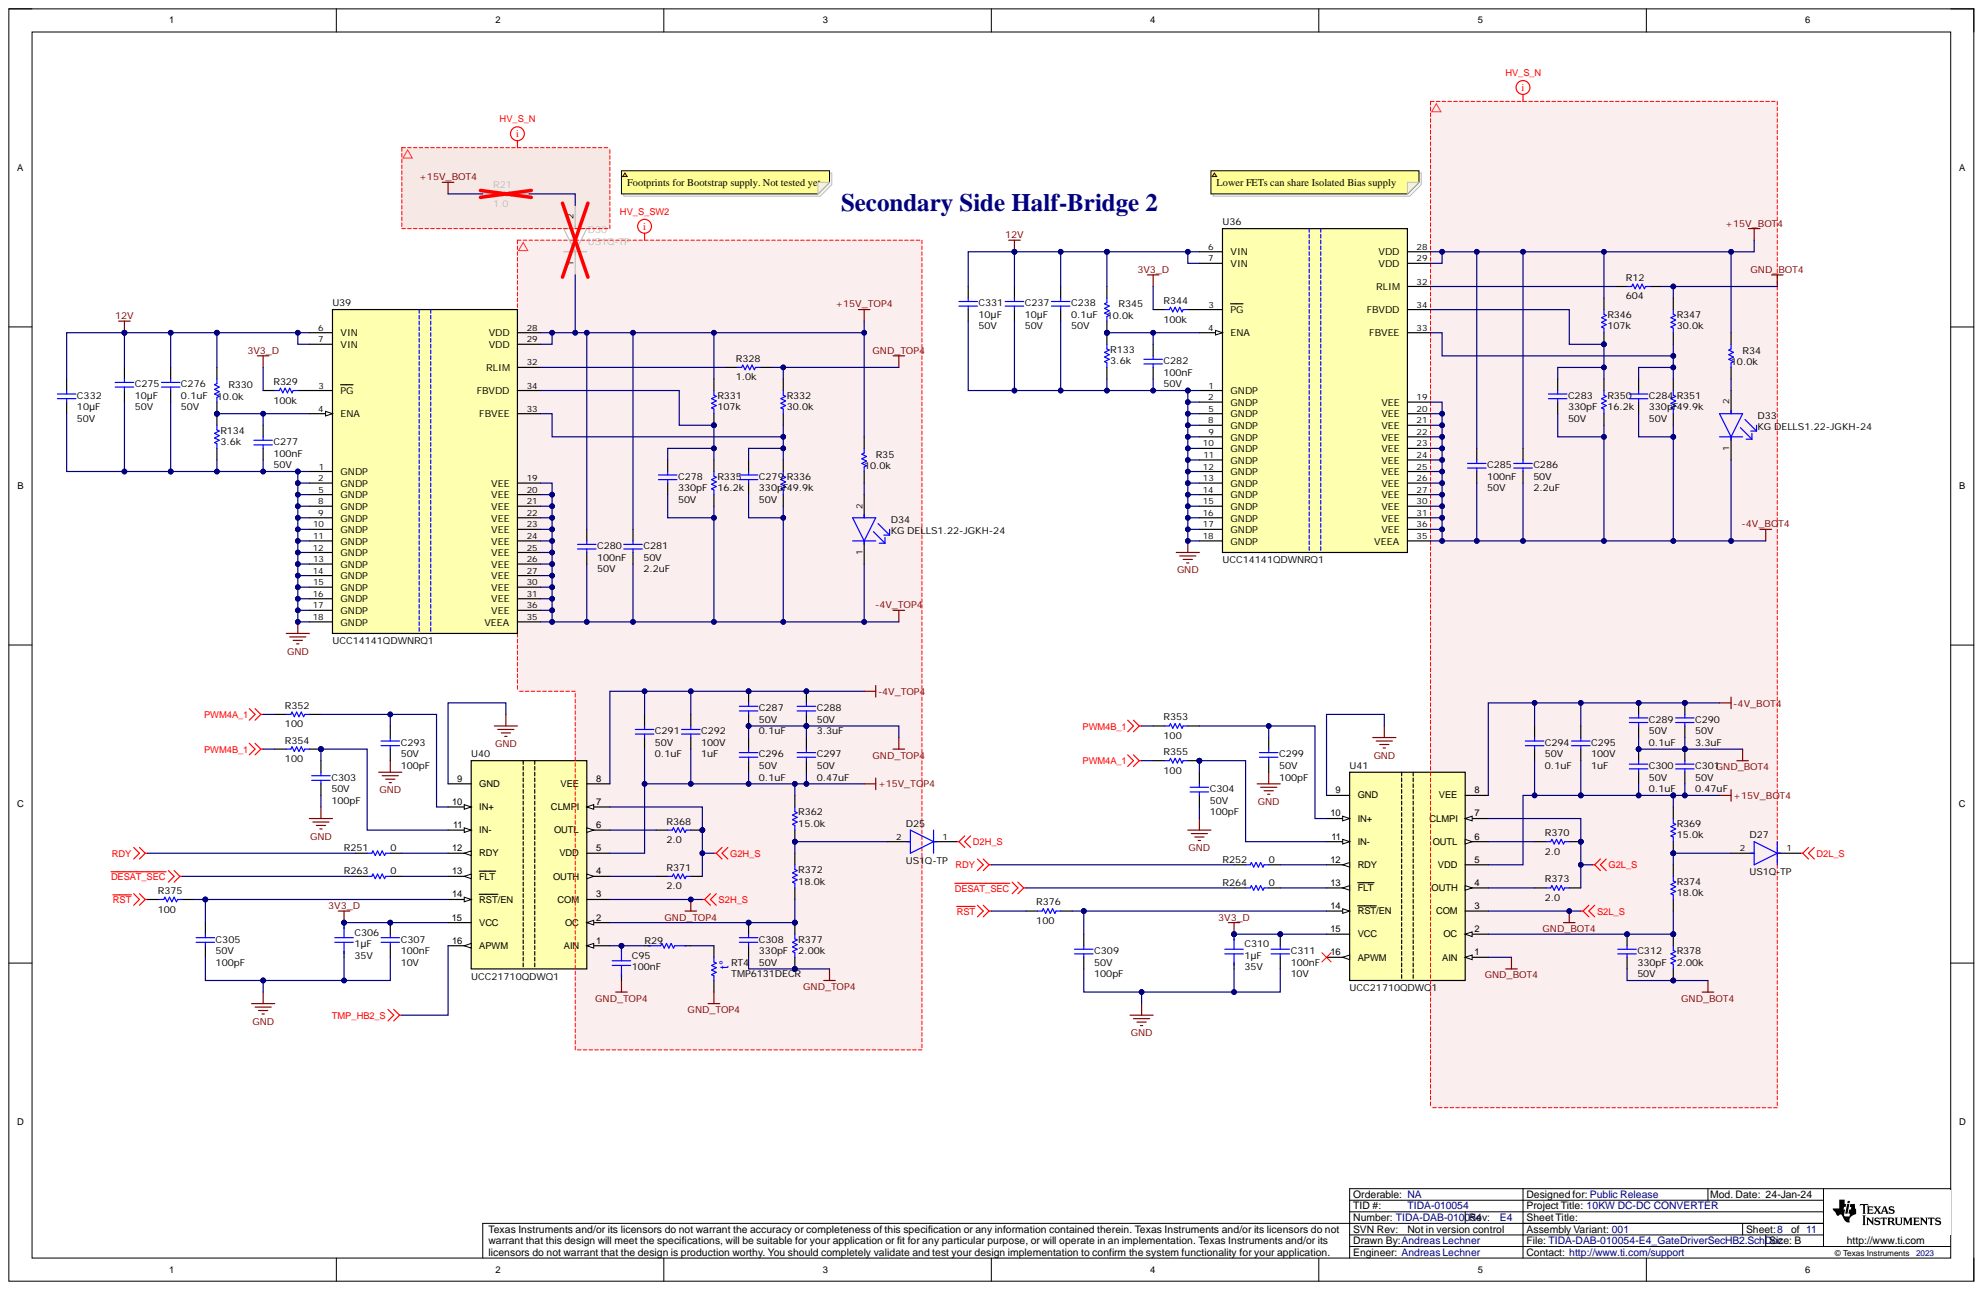
[picture p94: page 8]

Secondary Side Half-Bridge

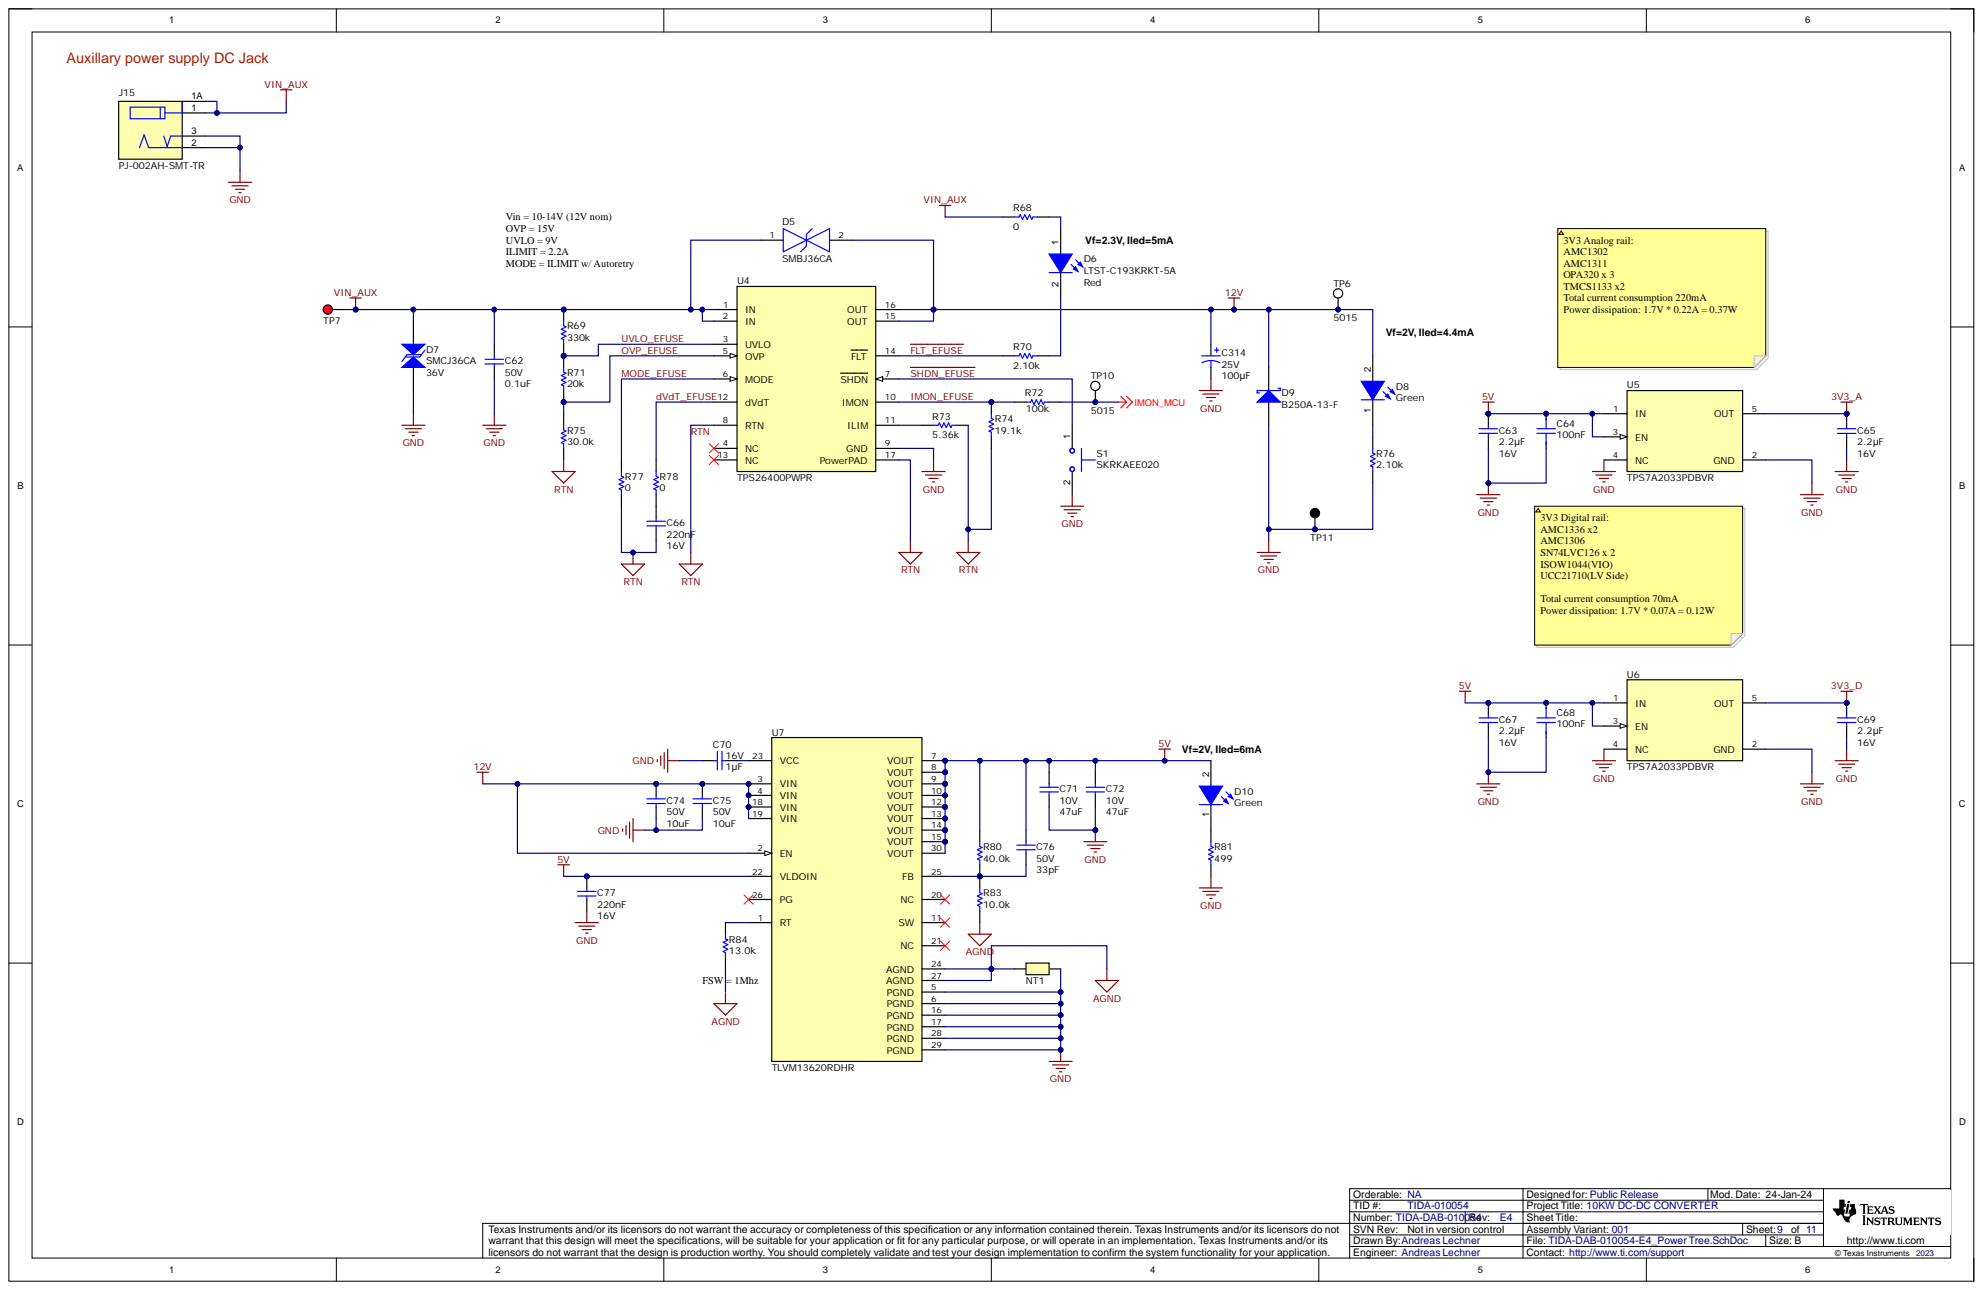
[picture p95: page 9]

Auxillary power supply DC Jack

OVP_E F U S E | 5

R71 MODE_E F U S E | 6

Total current consumption 70mA Power dissipation: 1.7V * 0.07A = 0.12W

FS W = 1Mhz

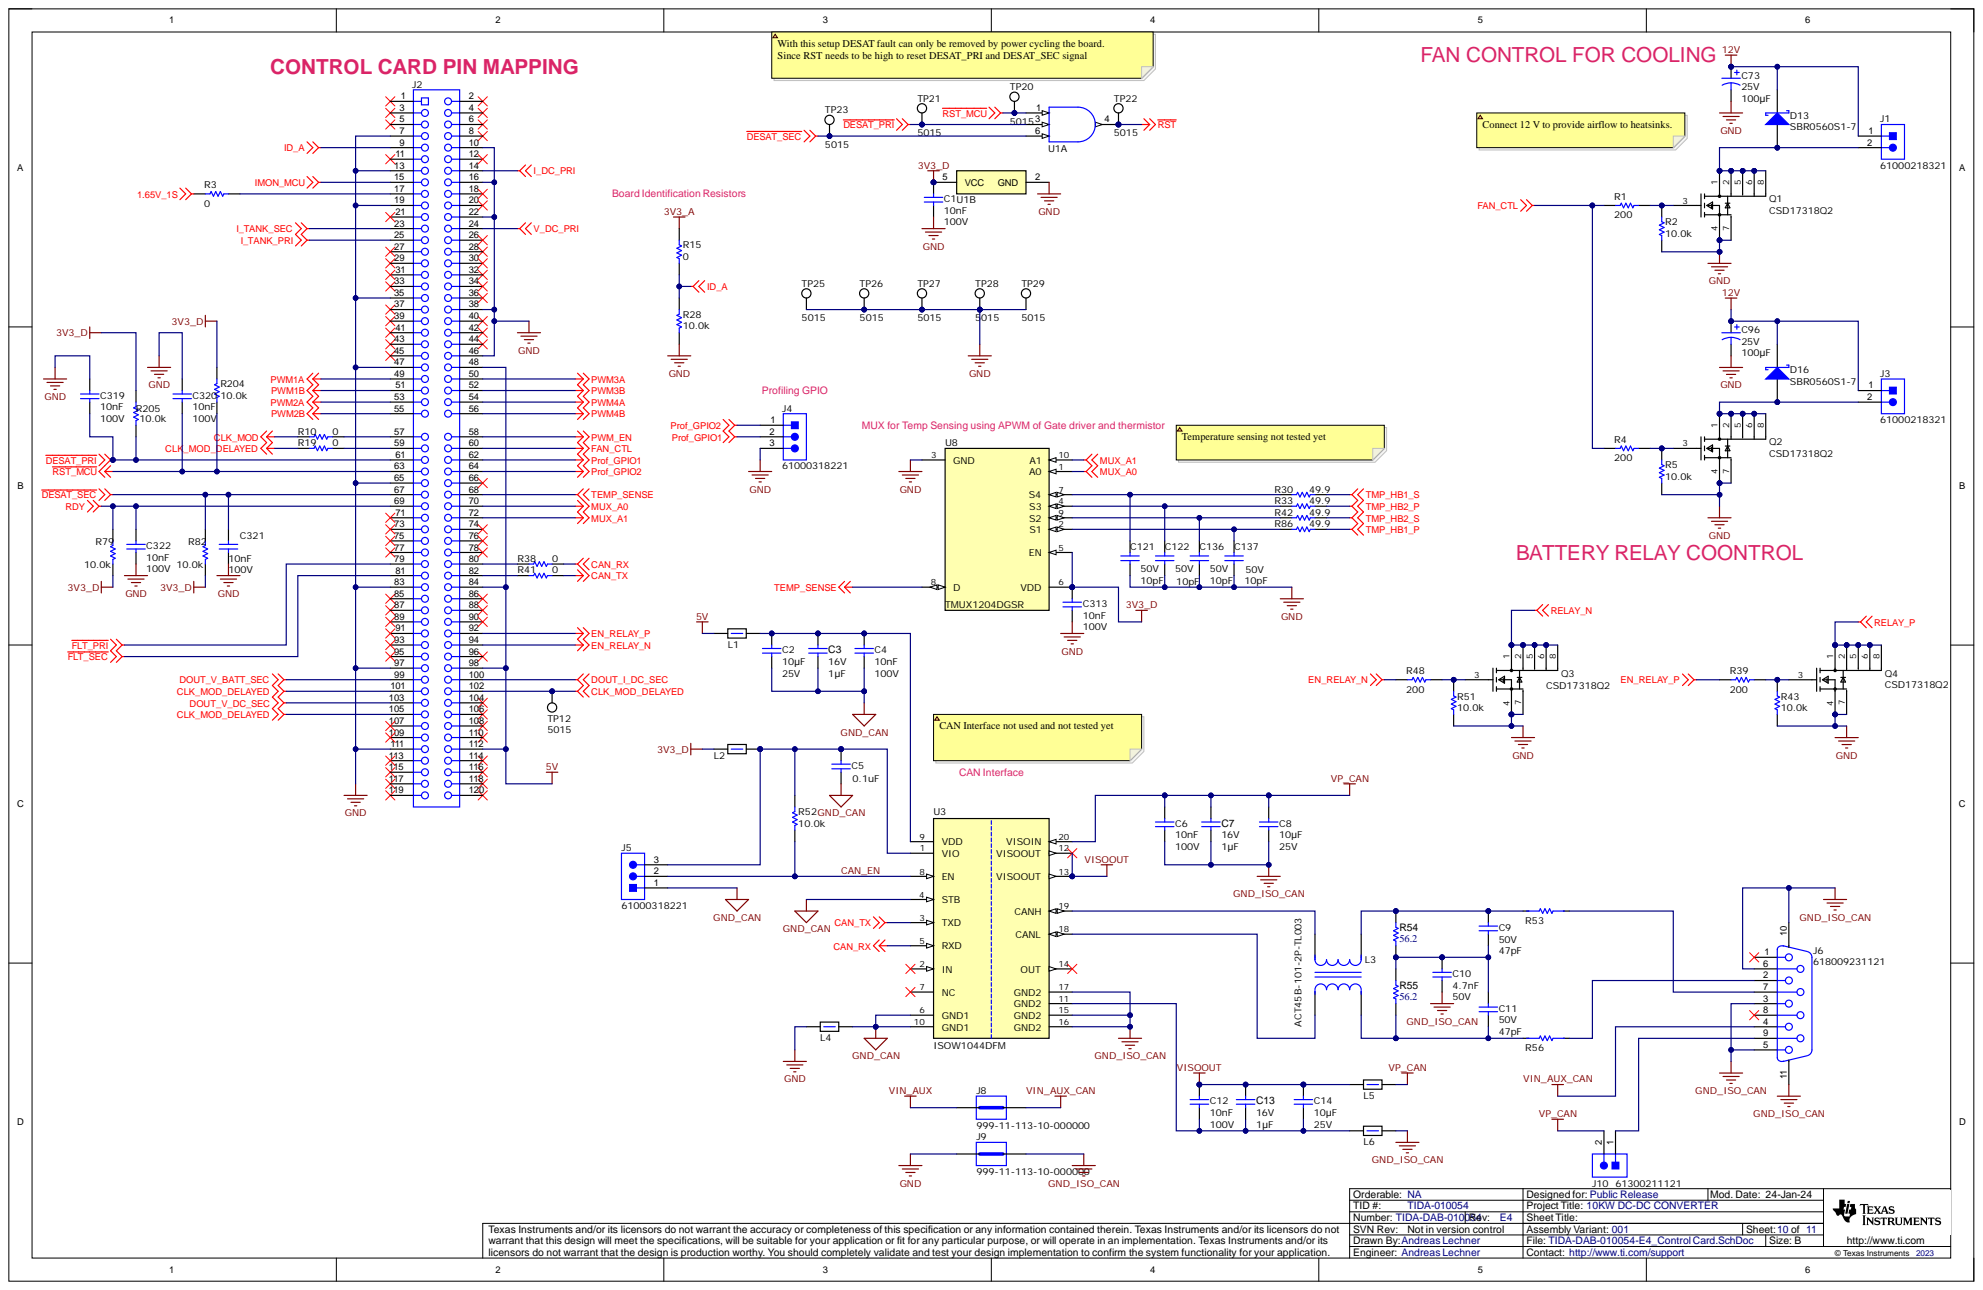
[picture p96: page 10]

FAN CONTROL FOR COOLING

With this setup DES
Since RST needs to be high to reset DES

AT fault can only be removed by power cycling the board.

V to provide airflow to heatsinks.

Temperature sensing not tested yet

9 | R42 49. 9

Interface not used and not tested yet

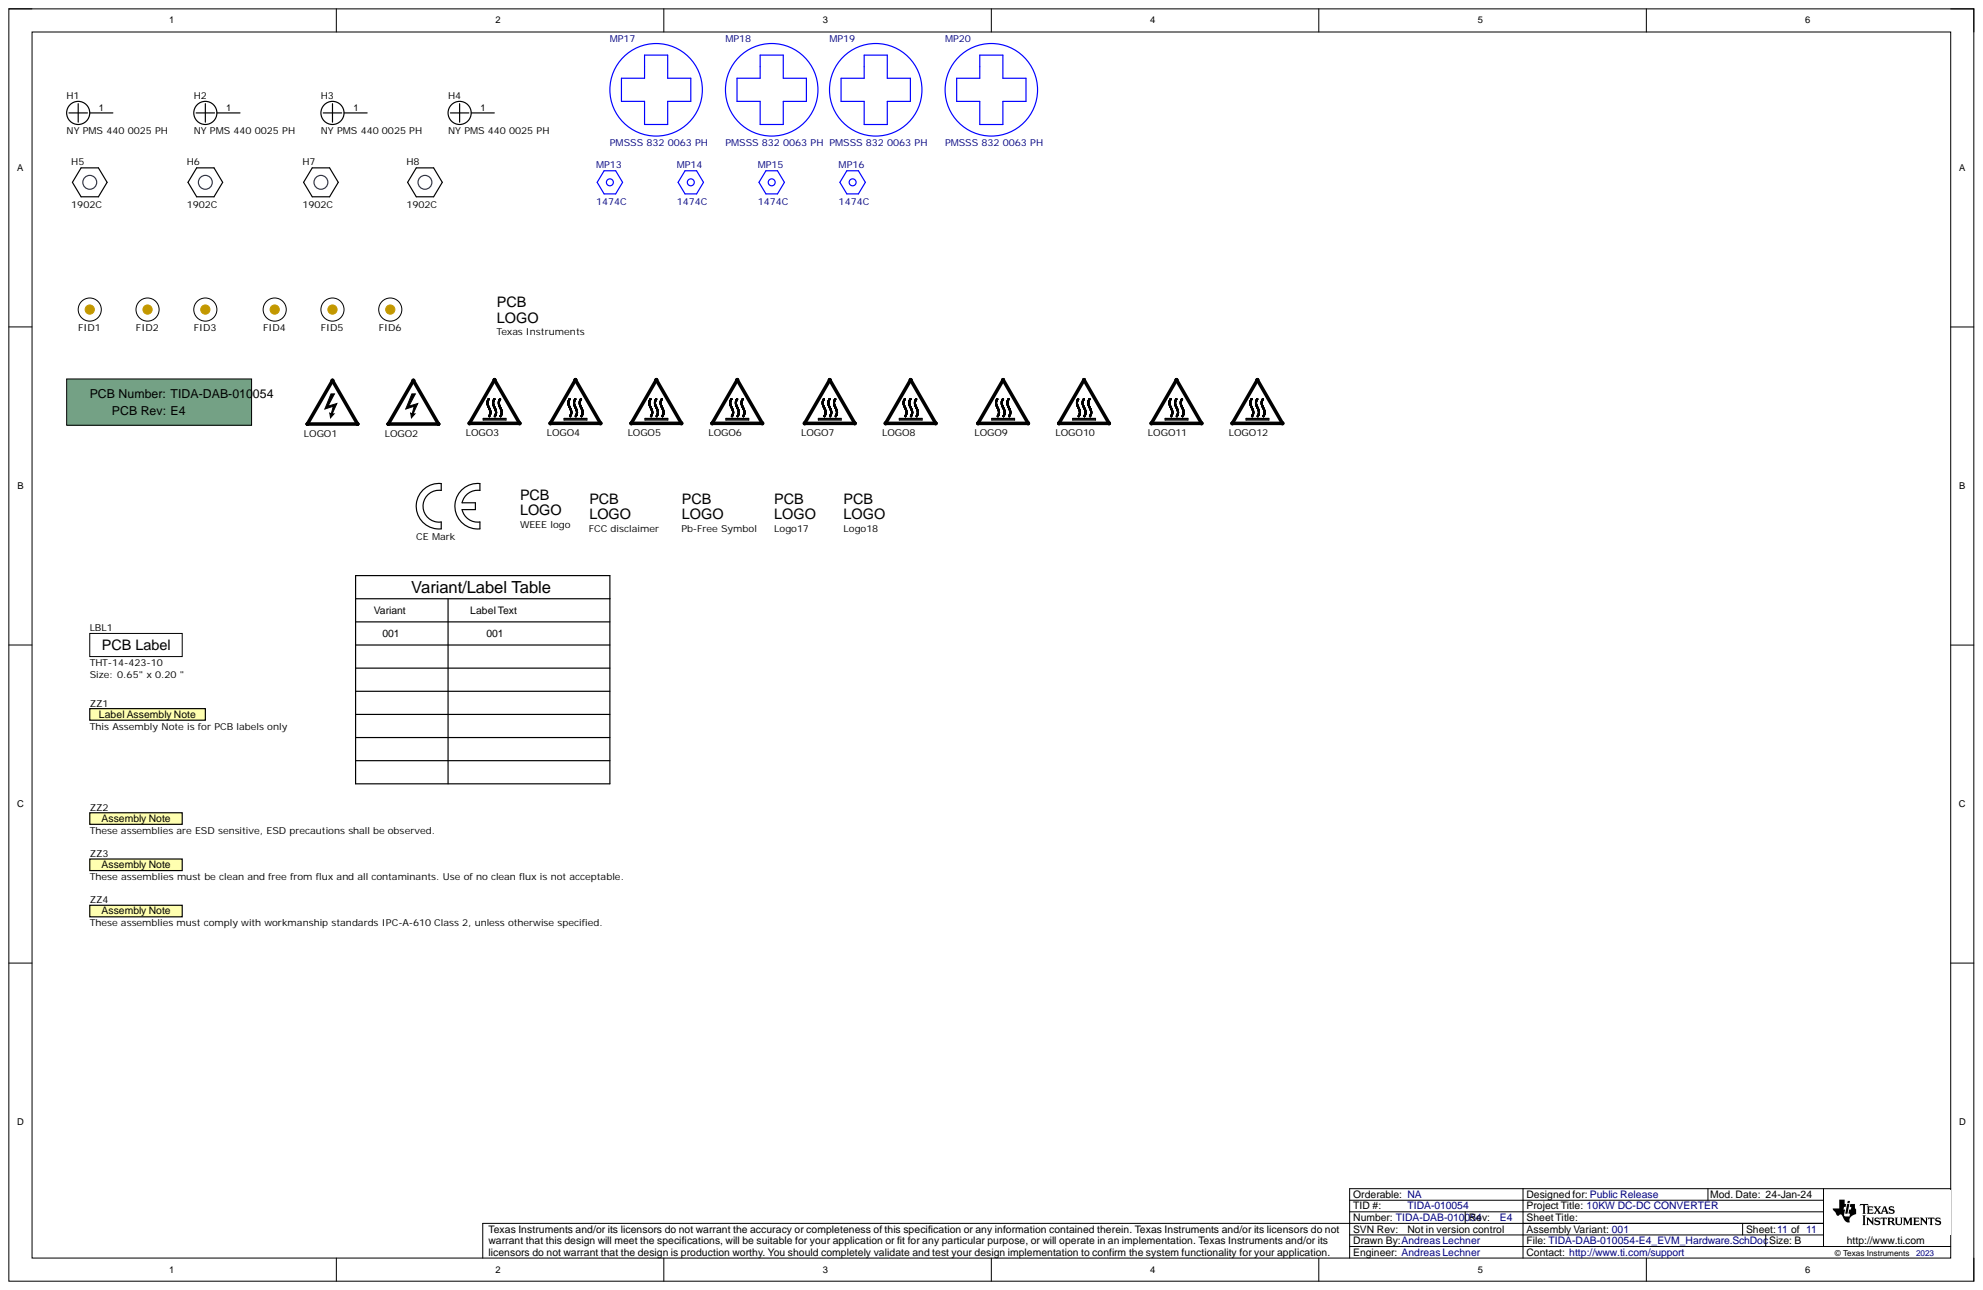
[picture p97: page 11]

Variant | Label Text

Label Assembly Note
This Assembly Note is for PCB labels only

Assembly Note
These assemblies are ESD sensitive, ESD precautions shall be observed.

These assemblies must be clean and free from flux and all contaminants. Use of no clean flux is not acceptable.

These assemblies must comply with workmanship standards IPC-A-610 Class 2, unless otherwise specified.

# IMPORTANT NOTICE AND DISCLAIMER

TI PROVIDES TECHNICAL AND RELIABILITY DATA (INCLUDING DATA SHEETS), DESIGN RESOURCES (INCLUDING REFERENCE DESIGNS), APPLICATION OR OTHER DESIGN ADVICE, WEB TOOLS, SAFETY INFORMATION, AND OTHER RESOURCES “AS IS” AND WITH ALL FAULTS, AND DISCLAIMS ALL WARRANTIES, EXPRESS AND IMPLIED, INCLUDING WITHOUT LIMITATION ANY IMPLIED WARRANTIES OF MERCHANTABILITY, FITNESS FOR A PARTICULAR PURPOSE OR NON-INFRINGEMENT OF THIRD PARTY INTELLECTUAL PROPERTY RIGHTS.
These resources are intended for skilled developers designing with TI products. You are solely responsible for (1) selecting the appropriate TI products for your application, (2) designing, validating and testing your application, and (3) ensuring your application meets applicable standards, and any other safety, security, regulatory or other requirements.
These resources are subject to change without notice. TI grants you permission to use these resources only for development of an application that uses the TI products described in the resource. Other reproduction and display of these resources is prohibited. No license is granted to any other TI intellectual property right or to any third party intellectual property right. TI disclaims responsibility for, and you will fully indemnify TI and its representatives against, any claims, damages, costs, losses, and liabilities arising out of your use of these resources.
TI’s products are provided subject to TI’s Terms of Sale (https://www.ti.com/legal/terms-conditions/terms-of-sale.html) or other applicable terms available either on ti.com or provided in conjunction with such TI products. TI’s provision of these resources does not expand or otherwise alter TI’s applicable warranties or warranty disclaimers for TI products.
TI objects to and rejects any additional or different terms you may have proposed. IMPORTANT NOTICE

## Mailing Address: Texas Instruments, Post Office Box 655303, Dallas, Texas 75265 Copyright © 2024, Texas Instruments Incorporated
