OnePice-C/INV.5KW/INV.5KW.OG.Design/Hardware/INV.OG5K.PWR.V1/INV.OG5K.PW.V1.pdf

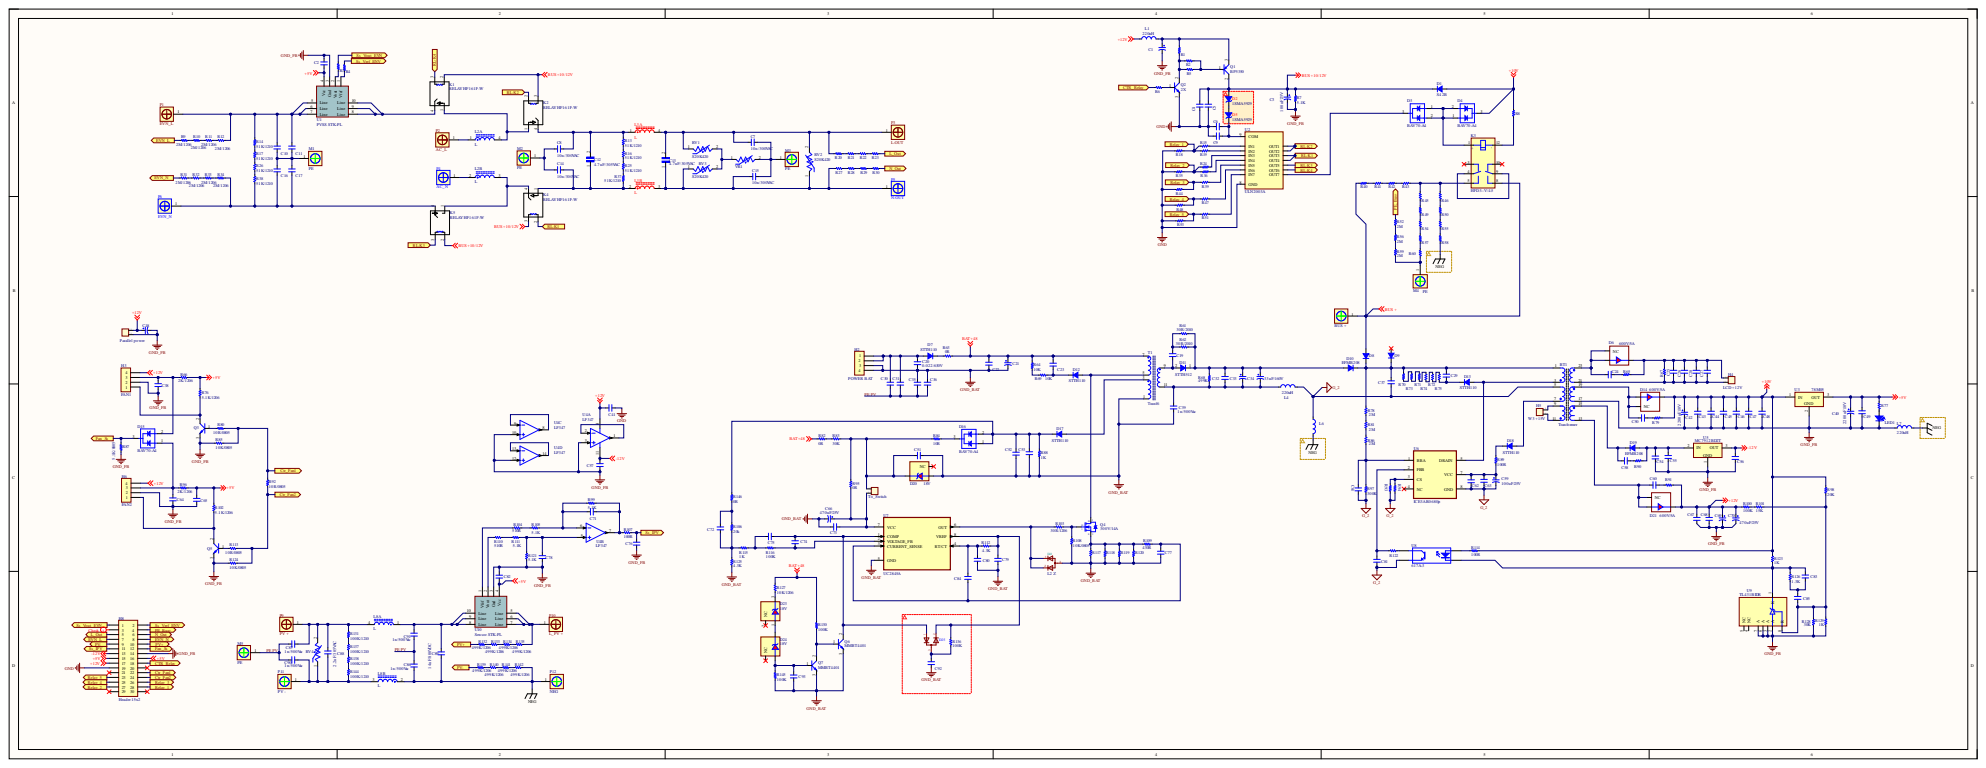
[picture p99: page 1]
