OnePice-C/INV.5KW/INV.5KW.OG.Design/Hardware/INV.OG5K.CTL.V1/PDF SCH/INV.CTL.V1.pdf

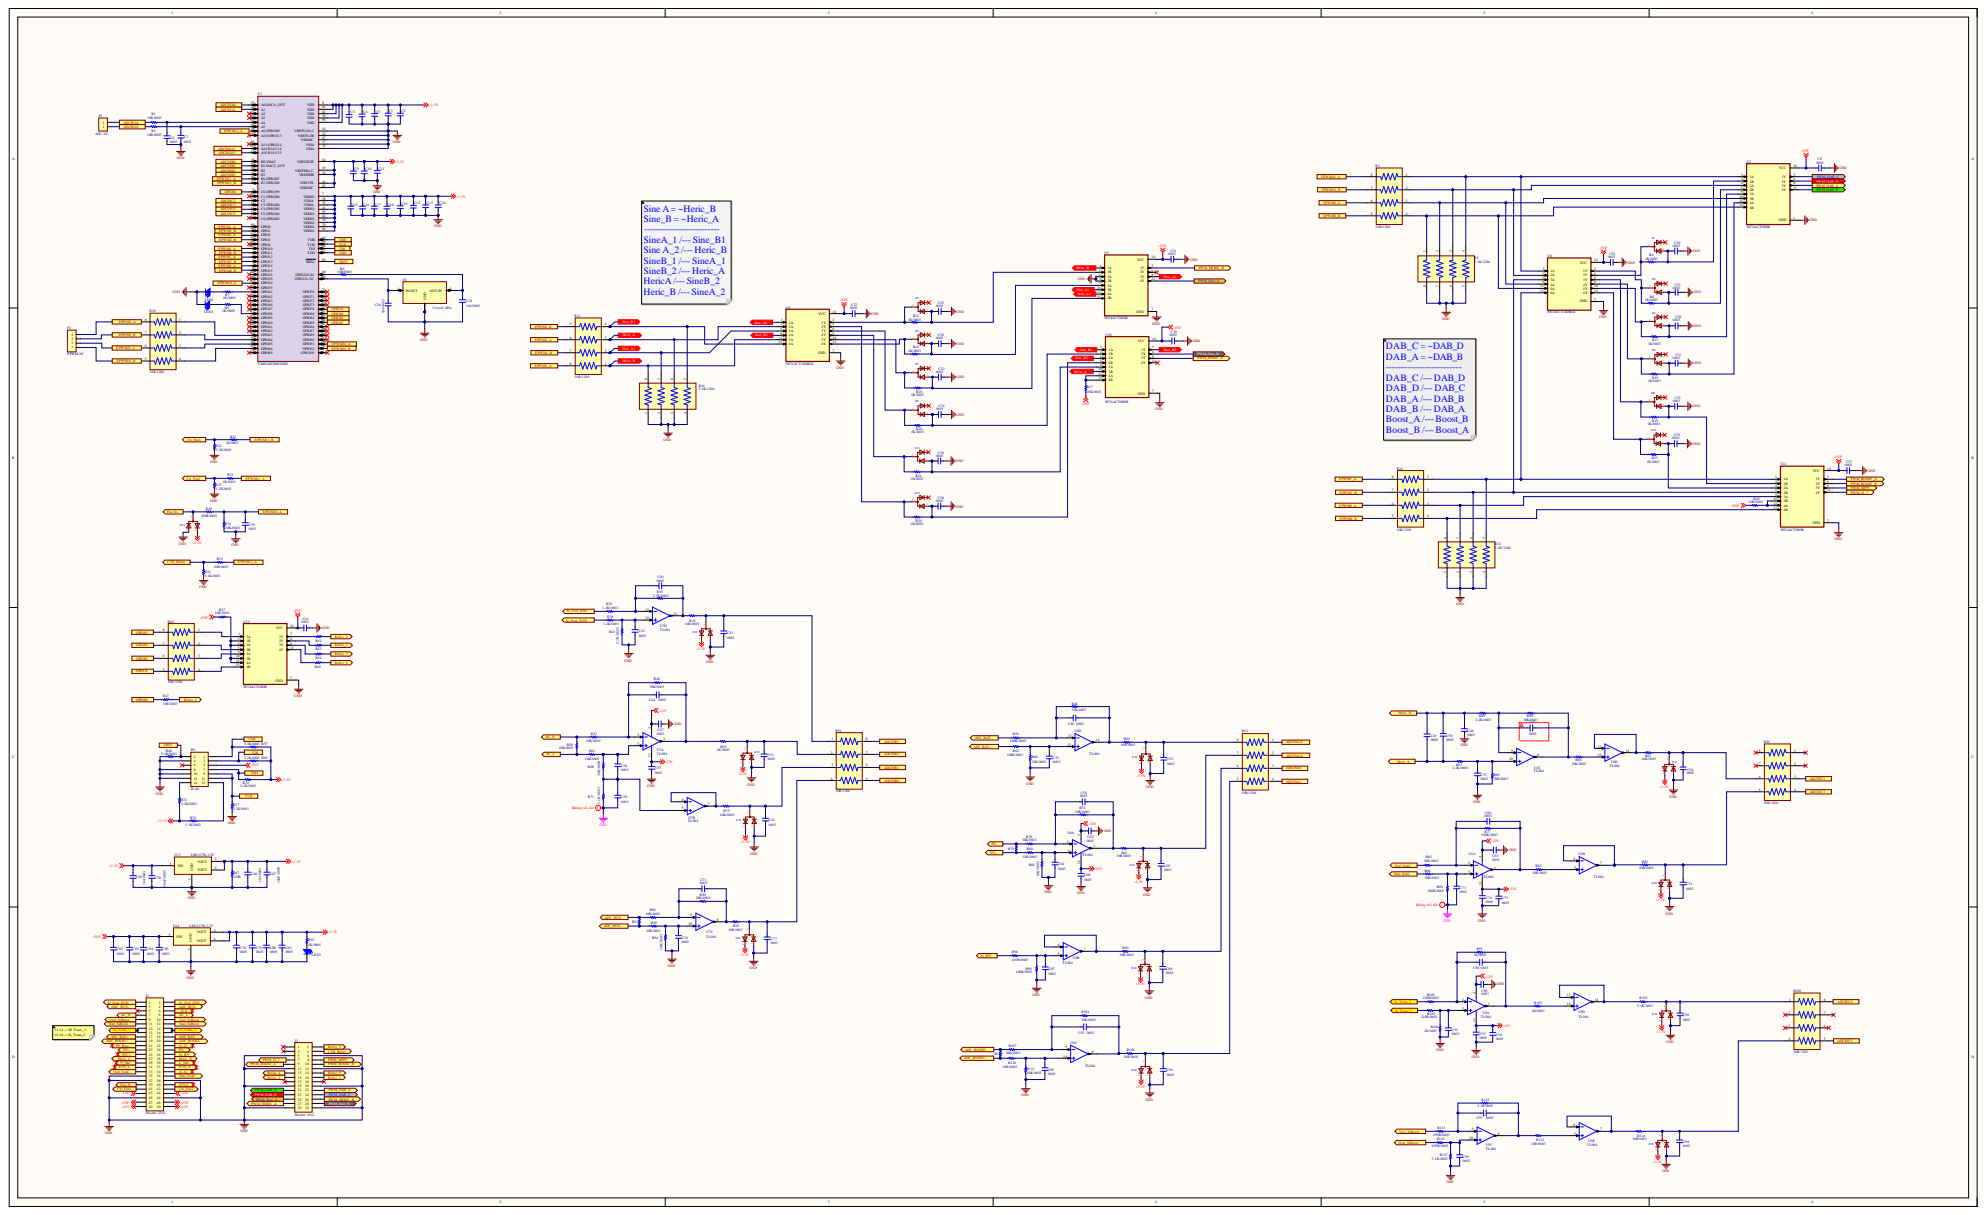
[picture p100: page 1]
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
