OnePice-C/INV.5KW/Mẫu thiết kế INV/INV.OnGrid-3.6kW.pdf

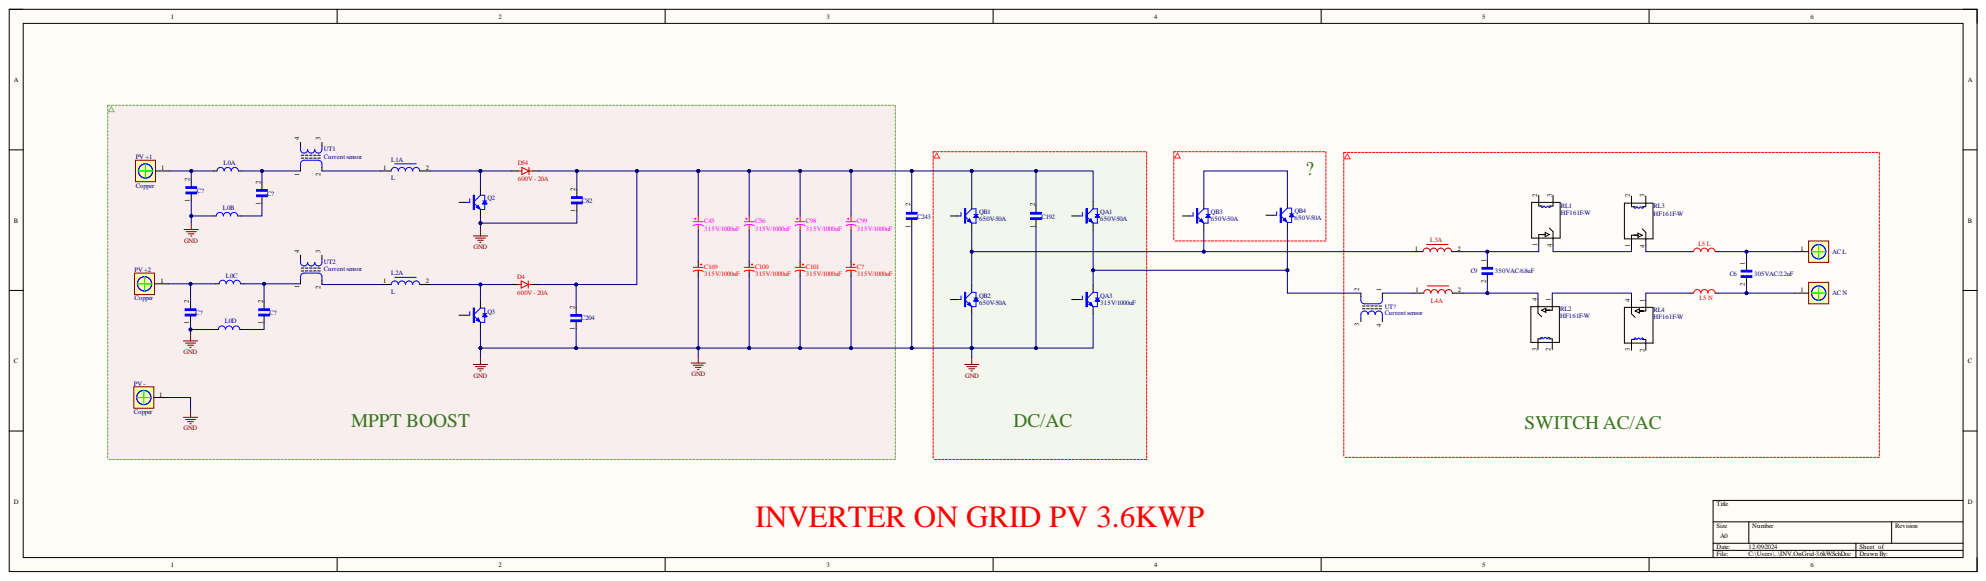
[picture p101: page 1]

INVERTER ON GRID PV 3.6KWP

Siz e A0 | Nu mb er | R e vis io n

Date : 1 2/0 9/2 0 24 | S h e et o f
File : C:\Us e r s\. .\INV .OnGrid -3 . 6kW. SchDo c | Dr awn By :
