OnePice-C/INV.5KW/Mẫu thiết kế INV/On Grid Hybrid 5Kw.Deye.pdf

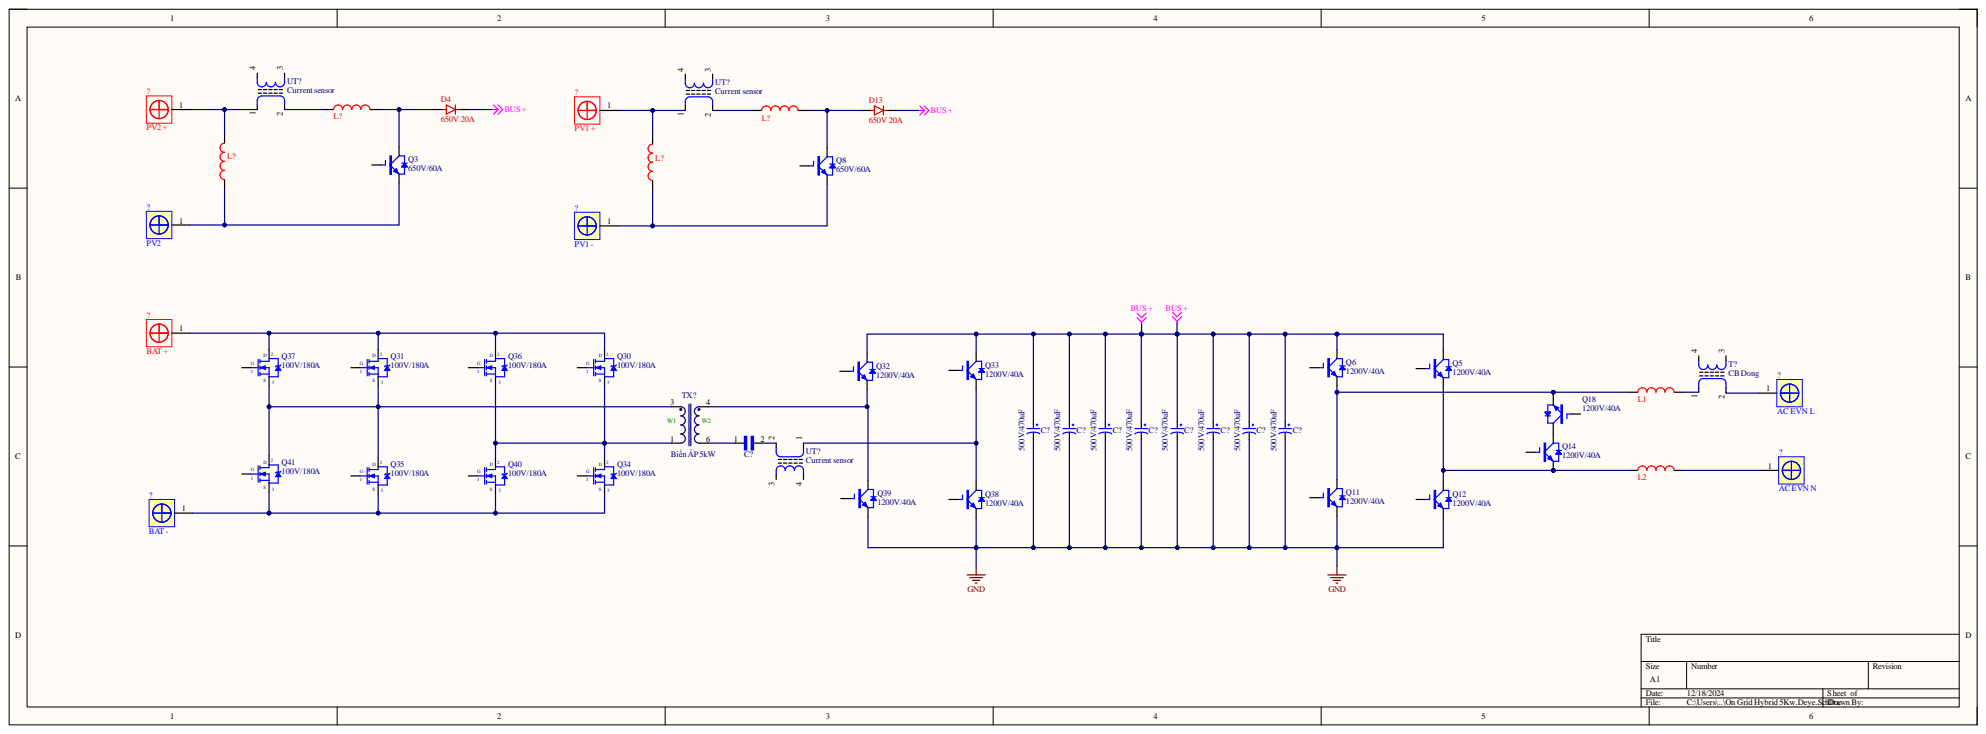
[picture p102: page 1]

Siz e A1 | Numb er | R evisio n

Date : 12/18/20 24 | She et of
File : C:\Us e r s\. .\On Grid Hybrid 5Kw .Deye . | S chDr Doacwn By:
