OnePice-C/INV.5KW/Mẫu thiết kế INV/Solis/OG5K.Solis.Main.pdf

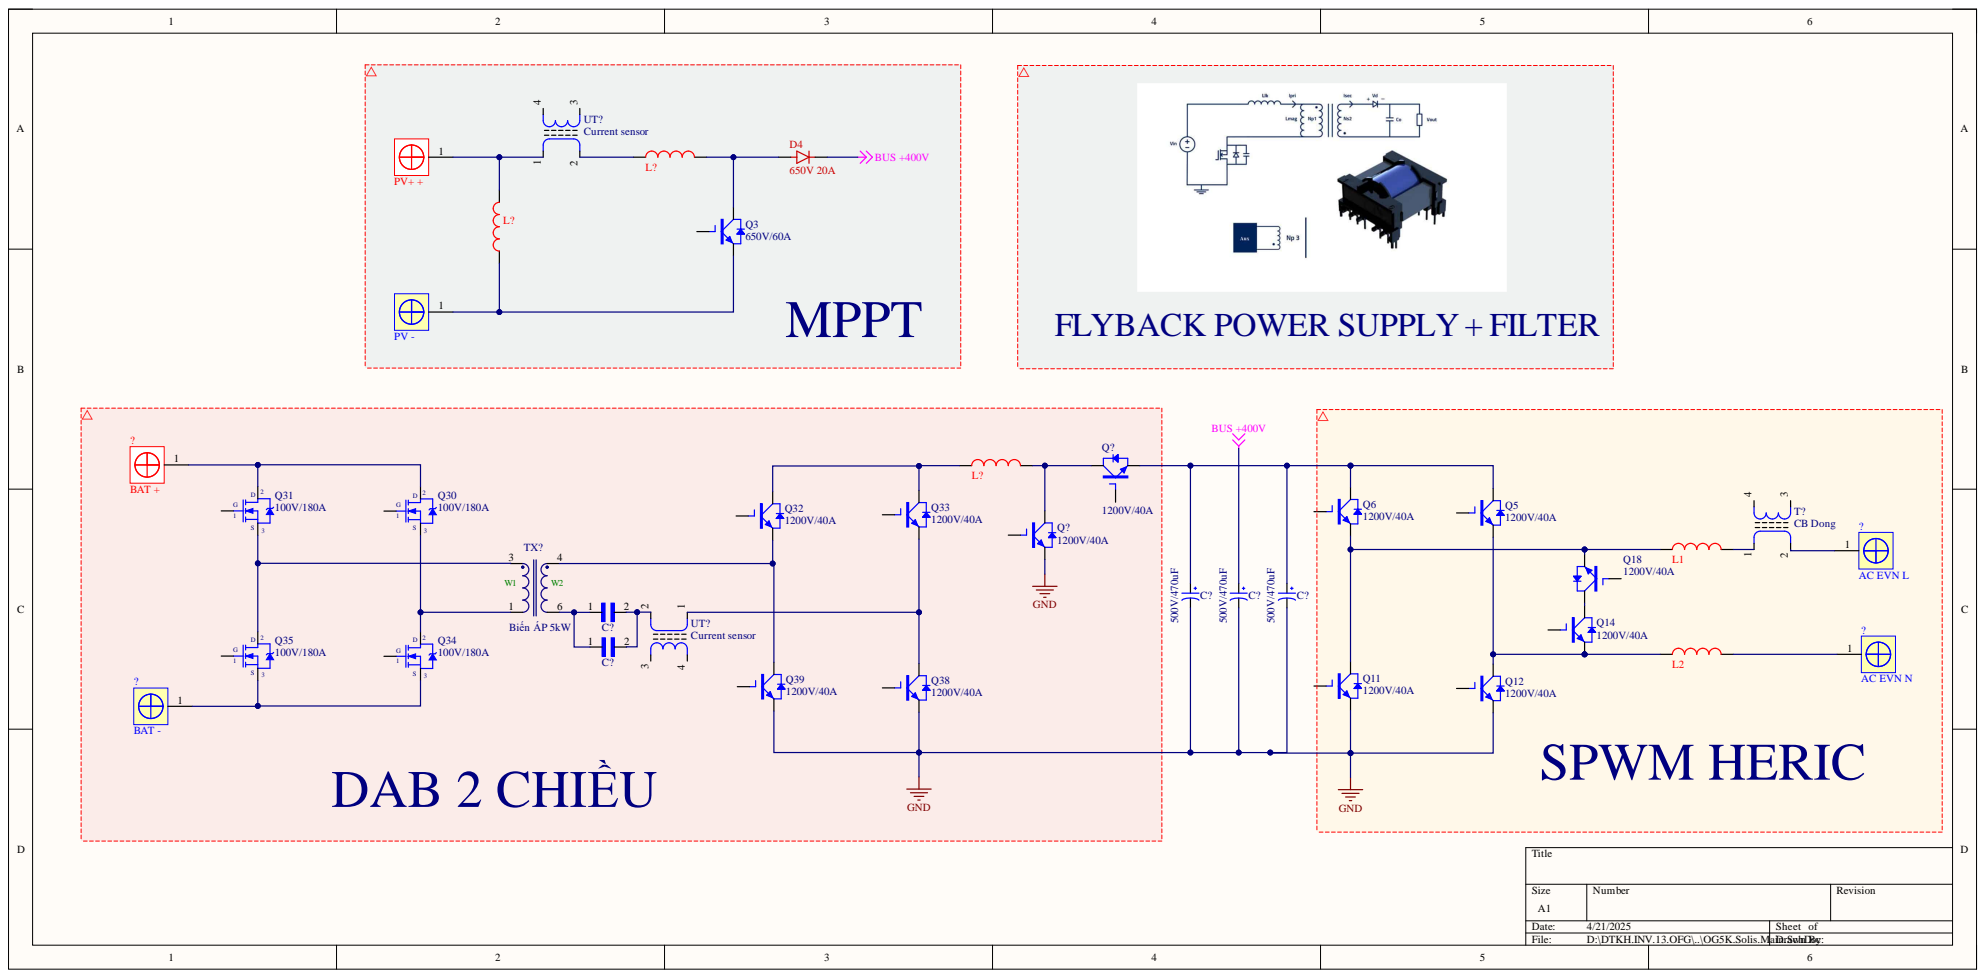
[picture p103: page 1]

Size A1 | Nu mber | Revision

Dat e : 4/21/2025 | Sheet of
File: D:\DTKH.INV .13.OFG\. .\OG5K.Solis.MainDrawn .SchDBy: oc
