OnePice-C/INV.5KW/Mẫu thiết kế INV/Off Grid 5kw.MPS/INV.5KW.OffGrid. MPS.pdf

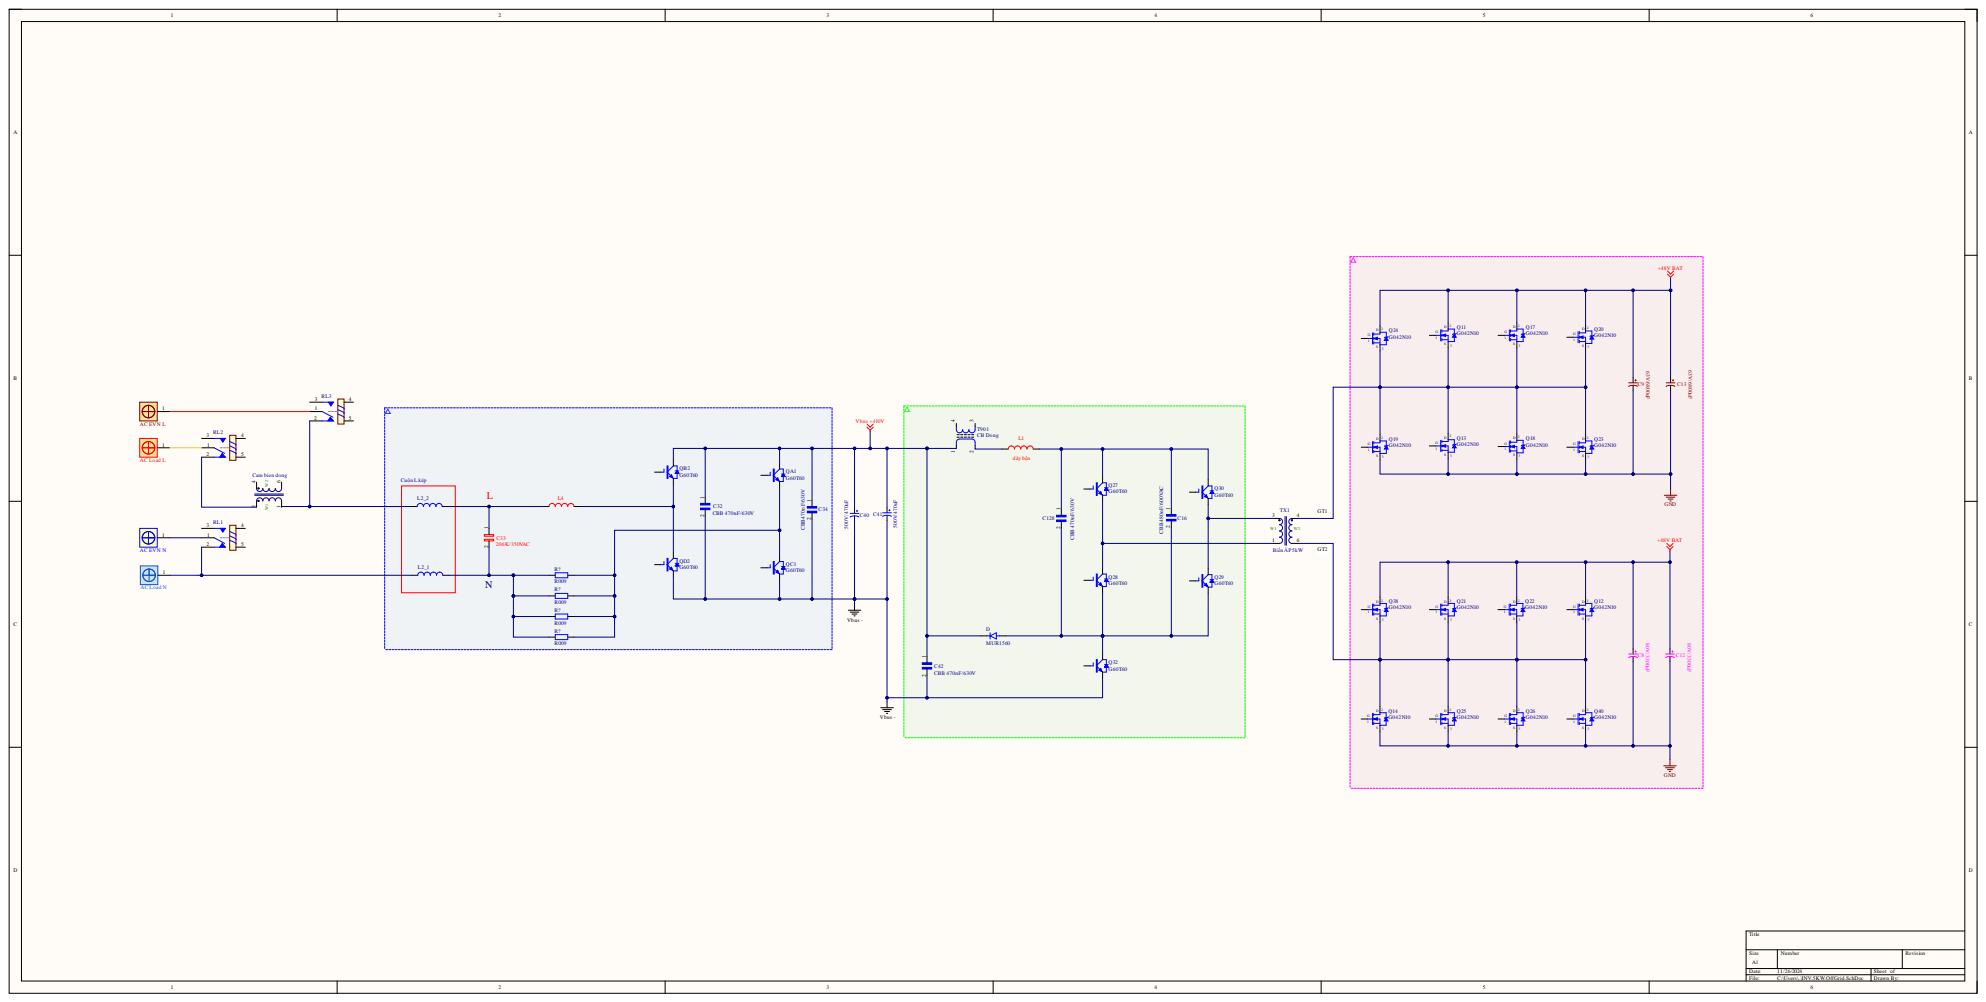
[picture p104: page 1]

Size A 1 | N umber | Rev i s ion

Dat e: 1 1 / 2 6 /2024 Fi l e: C: \U sers \ . . \IN V . 5 K W . OffGri d .Sch D oc | Sheet o f Draw n By :
