OnePice-C/INV.5KW/Mẫu thiết kế INV/Solis/Off Grid 5kw.Solis.pdf

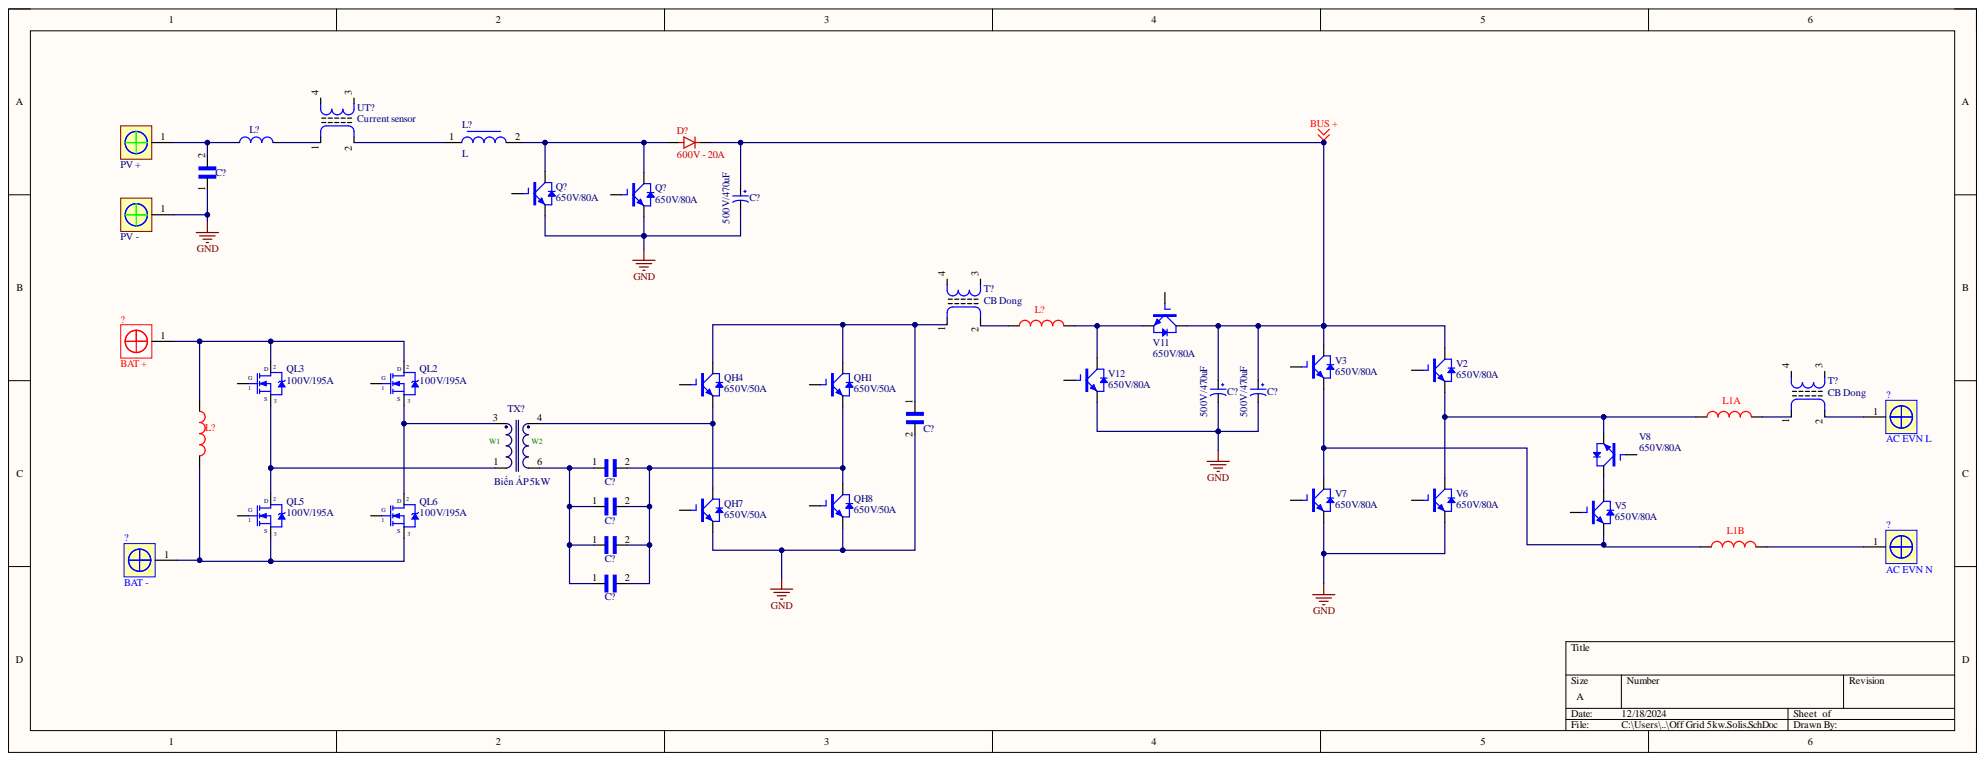
[picture p105: page 1]

: 1 2 / 1 8 /2 0 2 4 | S h e e t o f
Fi l e : C : \ U s e r s \ . . \ O ff G r i d 5 k w . S o li s . S c hDo c | D r a w n B y :
