OnePice-C/INV.5KW/(list of files, drawings)

Other design files:
INV.5KW.OG.Design/Hardware/Full/INV.OG5K.CTL.V1/INV.CTL.V1.SchDoc
INV.5KW.OG.Design/Hardware/Full/INV.OG5K.MAIN.V1/INV.Main.SchDoc
INV.5KW.OG.Design/Hardware/Full/INV.OG5K.PWR.V1/INV.OG5K.PW.V1.SchDoc
INV.5KW.OG.Design/Hardware/INV.5KW.OG.SCH.Sample/INV.ControlMCU.SchDoc
INV.5KW.OG.Design/Hardware/INV.5KW.OG.SCH.Sample/INV.Main.SchDoc
INV.5KW.OG.Design/Hardware/INV.5KW.OG.SCH.Sample/INV.Power.SchDoc
INV.5KW.OG.Design/Hardware/INV.OG5K.CTL.V1/INV.CTL.V1.SchDoc
INV.5KW.OG.Design/Hardware/INV.OG5K.CTL.V1/INV.OG5K.CTL.V1.PrjPcb
INV.5KW.OG.Design/Hardware/INV.OG5K.MAIN.V1/INV.Main.SCH.SchDoc
INV.5KW.OG.Design/Hardware/INV.OG5K.MAIN.V1/INV.OG5K.MAIN.PRJ.PrjPcb
INV.5KW.OG.Design/Hardware/INV.OG5K.MAIN.V1/INV.V1.0/INV.Main.SCH.SchDoc
INV.5KW.OG.Design/Hardware/INV.OG5K.MAIN.V1/INV.V1.0/INV.OG5K.MAIN.PRJ.PrjPcb
INV.5KW.OG.Design/Hardware/INV.OG5K.PWR.V1/INV.OG5K.PW.V1.PrjPcb
INV.5KW.OG.Design/Hardware/INV.OG5K.PWR.V1/INV.OG5K.PW.V1.SchDoc
INV.5KW.OG.Design/Hardware/Main_Display/Main_Display.PrjPcb
INV.5KW.OG.Design/Hardware/Main_Display/SCH_BLOCK.SchDoc
INV.5KW.OG.Design/Hardware/Main_Display/SCH_MCU.SchDoc
INV.5KW.OG.Design/Hardware/Main_Display/SCH_SOURCE.SchDoc
Mẫu thiết kế INV/INV.OnGrid-3.6kW.Afore.SchDoc
Mẫu thiết kế INV/Off Grid 5kw.MPS/INV.5KW.OffGrid MPS.SchDoc
Mẫu thiết kế INV/On Grid Hybrid 5Kw.Deye.SchDoc
Mẫu thiết kế INV/Solis/INV.5KW.OG.PrjPcb
Mẫu thiết kế INV/Solis/INV.ControlMCU.SchDoc
Mẫu thiết kế INV/Solis/INV.Main.SchDoc
Mẫu thiết kế INV/Solis/INV.Power.SchDoc
Mẫu thiết kế INV/Solis/OG5K.Solis.Main.SchDoc
