OnePice-C/INV.5KW/INV.5KW.OG.Design/firmware/FW.INV.HR.V1.0/use.main/CPU1_FLASH/syscfg/board.h

/*
 * Copyright (c) 2020 Texas Instruments Incorporated - http://www.ti.com
 * All rights reserved.
 *
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
 * *  Redistributions of source code must retain the above copyright
 *    notice, this list of conditions and the following disclaimer.
 *
 * *  Redistributions in binary form must reproduce the above copyright
 *    notice, this list of conditions and the following disclaimer in the
 *    documentation and/or other materials provided with the distribution.
 *
 * *  Neither the name of Texas Instruments Incorporated nor the names of
 *    its contributors may be used to endorse or promote products derived
 *    from this software without specific prior written permission.
 *
 * THIS SOFTWARE IS PROVIDED BY THE COPYRIGHT HOLDERS AND CONTRIBUTORS "AS IS"
 * AND ANY EXPRESS OR IMPLIED WARRANTIES, INCLUDING, BUT NOT LIMITED TO,
 * THE IMPLIED WARRANTIES OF MERCHANTABILITY AND FITNESS FOR A PARTICULAR
 * PURPOSE ARE DISCLAIMED. IN NO EVENT SHALL THE COPYRIGHT OWNER OR
 * CONTRIBUTORS BE LIABLE FOR ANY DIRECT, INDIRECT, INCIDENTAL, SPECIAL,
 * EXEMPLARY, OR CONSEQUENTIAL DAMAGES (INCLUDING, BUT NOT LIMITED TO,
 * PROCUREMENT OF SUBSTITUTE GOODS OR SERVICES; LOSS OF USE, DATA, OR PROFITS;
 * OR BUSINESS INTERRUPTION) HOWEVER CAUSED AND ON ANY THEORY OF LIABILITY,
 * WHETHER IN CONTRACT, STRICT LIABILITY, OR TORT (INCLUDING NEGLIGENCE OR
 * OTHERWISE) ARISING IN ANY WAY OUT OF THE USE OF THIS SOFTWARE,
 * EVEN IF ADVISED OF THE POSSIBILITY OF SUCH DAMAGE.
 *
 */

#ifndef BOARD_H
#define BOARD_H

//*****************************************************************************
//
// If building with a C++ compiler, make all of the definitions in this header
// have a C binding.
//
//*****************************************************************************
#ifdef __cplusplus
extern "C"
{
#endif

//
// Included Files
//

#include "driverlib.h"
#include "device.h"

//*****************************************************************************
//
// PinMux Configurations
//
//*****************************************************************************

//
// ANALOG -> myANALOGPinMux0 Pinmux
//

//
// EPWM1 -> myEPWM1 Pinmux
//
//
// EPWM1_A - GPIO Settings
//
#define GPIO_PIN_EPWM1_A 0
#define myEPWM1_EPWMA_GPIO 0
#define myEPWM1_EPWMA_PIN_CONFIG GPIO_0_EPWM1_A
//
// EPWM1_B - GPIO Settings
//
#define GPIO_PIN_EPWM1_B 1
#define myEPWM1_EPWMB_GPIO 1
#define myEPWM1_EPWMB_PIN_CONFIG GPIO_1_EPWM1_B

//
// EPWM2 -> myEPWM2 Pinmux
//
//
// EPWM2_A - GPIO Settings
//
#define GPIO_PIN_EPWM2_A 2
#define myEPWM2_EPWMA_GPIO 2
#define myEPWM2_EPWMA_PIN_CONFIG GPIO_2_EPWM2_A
//
// EPWM2_B - GPIO Settings
//
#define GPIO_PIN_EPWM2_B 3
#define myEPWM2_EPWMB_GPIO 3
#define myEPWM2_EPWMB_PIN_CONFIG GPIO_3_EPWM2_B
//
// GPIO41 - GPIO Settings
//
#define myGPIO0_GPIO_PIN_CONFIG GPIO_41_GPIO41
//
// GPIO58 - GPIO Settings
//
#define myGPIO1_GPIO_PIN_CONFIG GPIO_58_GPIO58

//*****************************************************************************
//
// ADC Configurations
//
//*****************************************************************************
#define myADC0_BASE ADCB_BASE
#define myADC0_RESULT_BASE ADCBRESULT_BASE
#define SOC0 ADC_SOC_NUMBER0
#define SOC0_FORCE ADC_FORCE_SOC0
#define SOC0_ADC_BASE ADCB_BASE
#define SOC0_RESULT_BASE ADCBRESULT_BASE
#define SOC0_SAMPLE_WINDOW 2000
#define SOC0_TRIGGER_SOURCE ADC_TRIGGER_EPWM1_SOCA
#define SOC0_CHANNEL ADC_CH_ADCIN2
void myADC0_init();

#define ADC_Current_BASE ADCC_BASE
#define ADC_Current_RESULT_BASE ADCCRESULT_BASE
#define SOC1 ADC_SOC_NUMBER1
#define SOC1_FORCE ADC_FORCE_SOC1
#define SOC1_ADC_BASE ADCC_BASE
#define SOC1_RESULT_BASE ADCCRESULT_BASE
#define SOC1_SAMPLE_WINDOW 320
#define SOC1_TRIGGER_SOURCE ADC_TRIGGER_EPWM1_SOCA
#define SOC1_CHANNEL ADC_CH_ADCIN3
void ADC_Current_init();


//*****************************************************************************
//
// ASYSCTL Configurations
//
//*****************************************************************************

//*****************************************************************************
//
// EPWM Configurations
//
//*****************************************************************************
#define myEPWM1_BASE EPWM1_BASE
#define myEPWM1_TBPRD 1666
#define myEPWM1_COUNTER_MODE EPWM_COUNTER_MODE_UP_DOWN
#define myEPWM1_TBPHS 0
#define myEPWM1_CMPA 0
#define myEPWM1_CMPB 0
#define myEPWM1_CMPC 0
#define myEPWM1_CMPD 0
#define myEPWM1_DBRED 80
#define myEPWM1_DBFED 80
#define myEPWM1_TZA_ACTION EPWM_TZ_ACTION_HIGH_Z
#define myEPWM1_TZB_ACTION EPWM_TZ_ACTION_HIGH_Z
#define myEPWM1_INTERRUPT_SOURCE EPWM_INT_TBCTR_DISABLED
#define myEPWM2_BASE EPWM2_BASE
#define myEPWM2_TBPRD 1666
#define myEPWM2_COUNTER_MODE EPWM_COUNTER_MODE_UP_DOWN
#define myEPWM2_TBPHS 0
#define myEPWM2_CMPA 0
#define myEPWM2_CMPB 0
#define myEPWM2_CMPC 0
#define myEPWM2_CMPD 0
#define myEPWM2_DBRED 80
#define myEPWM2_DBFED 80
#define myEPWM2_TZA_ACTION EPWM_TZ_ACTION_HIGH_Z
#define myEPWM2_TZB_ACTION EPWM_TZ_ACTION_HIGH_Z
#define myEPWM2_INTERRUPT_SOURCE EPWM_INT_TBCTR_DISABLED

//*****************************************************************************
//
// GPIO Configurations
//
//*****************************************************************************
#define myGPIO0 41
void myGPIO0_init();
#define myGPIO1 58
void myGPIO1_init();

//*****************************************************************************
//
// INTERRUPT Configurations
//
//*****************************************************************************

// Interrupt Settings for INT_myADC0_1
// ISR need to be defined for the registered interrupts
#define INT_myADC0_1 INT_ADCB1
#define INT_myADC0_1_INTERRUPT_ACK_GROUP INTERRUPT_ACK_GROUP1
extern __interrupt void INT_myADC0_1_ISR(void);

//*****************************************************************************
//
// SYNC Scheme Configurations
//
//*****************************************************************************

//*****************************************************************************
//
// Board Configurations
//
//*****************************************************************************
void	Board_init();
void	ADC_init();
void	ASYSCTL_init();
void	EPWM_init();
void	GPIO_init();
void	INTERRUPT_init();
void	SYNC_init();
void	PinMux_init();

//*****************************************************************************
//
// Mark the end of the C bindings section for C++ compilers.
//
//*****************************************************************************
#ifdef __cplusplus
}
#endif

#endif  // end of BOARD_H definition
