OnePice-C/INV.5KW/INV.5KW.OG.Design/firmware/FW.INV.HR.V1.0/use.main/inv_hr_main.c

// #############################################################################
//
//  FILE:   empty_driverlib_main.c
//
//! \addtogroup driver_example_list
//! <h1>Empty Project Example</h1>
//!
//! This example is an empty project setup for Driverlib development.
//!
//
// #############################################################################
//
//
//
// C2000Ware v5.04.00.00
//
// Copyright (C) 2024 Texas Instruments Incorporated - http://www.ti.com
//
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
//   Redistributions of source code must retain the above copyright
//   notice, this list of conditions and the following disclaimer.
//
//   Redistributions in binary form must reproduce the above copyright
//   notice, this list of conditions and the following disclaimer in the
//   documentation and/or other materials provided with the
//   distribution.
//
//   Neither the name of Texas Instruments Incorporated nor the names of
//   its contributors may be used to endorse or promote products derived
//   from this software without specific prior written permission.
//
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
//
// Included Files
//
#include "board.h"
#include "c2000ware_libraries.h"
#include "device.h"
#include "driverlib.h"

#include "DCLF32.h"
#include "Rampgen.h"
#include "dlog_4ch.h"
#include "power_meas_sine_analyzer.h"

#include "controler_CL.h"


__interrupt void INT_myADC0_1_ISR(void);


#pragma RETAIN(INV_DCAC_rgen)
#pragma RETAIN(INV_DCAC_Index_Modulation)
RAMPGEN INV_DCAC_rgen;
float32_t INV_DCAC_Index_Modulation;
float32_t INV_DCAC_Amplitude;

volatile float32_t INV_DCAC_vAC_Heric_Sensor = 0.0f;
volatile float32_t INV_DCAC_vAC_Heric_Sensor_1 = 0.0f;
volatile uint16_t ADC_Current = 0;

/*****************************************************************/

/*****************************************************************/

void sine_wave(void);
void PID_sine(void);

uint32_t Check_clock = 0;
uint16_t val_table_sine = 0;
uint8_t flag_table_sine = 0;
float32_t val_amp_sine = 0.8f;
uint16_t mesure_adc = 0;
/*
uint16_t table_sine[300] = {60,70,81,90, 100, 110, 120, 130, 140, 160, 176, 192,
208, 224, 240, 256, 271, 287, 303, 319, 334, 350, 365, 381, 397, 412, 428, 443,
458, 474, 489, 504, 519, 535, 550, 565, 580, 595, 609, 624, 639, 654, 668, 683,
697, 712, 726, 740, 754, 769, 783, 797, 810, 824, 838, 851, 865, 878, 892, 905,
918, 931, 944, 957, 970, 982, 995, 1007, 1020, 1032, 1044, 1056, 1068, 1080,
1091, 1103, 1114, 1126, 1137, 1148, 1159, 1170, 1180, 1191, 1201, 1212, 1222,
1232, 1242, 1252, 1261, 1271, 1280, 1290, 1299, 1308, 1317, 1325, 1334, 1342,
1351, 1359, 1367, 1375, 1382, 1390, 1397, 1404, 1411, 1418, 1425, 1432, 1438,
1445, 1451, 1457, 1463, 1468, 1474, 1479, 1485, 1490, 1495, 1499, 1504, 1508,
1513, 1517, 1521, 1524, 1528, 1531, 1535, 1538, 1541, 1543, 1546, 1548, 1551,
1553, 1555, 1557, 1558, 1560, 1561, 1562, 1563, 1564, 1564, 1565, 1565, 1565,
1565, 1565, 1564, 1564, 1563, 1562, 1561, 1560, 1558, 1557, 1555, 1553, 1551,
1548, 1546, 1543, 1541, 1538, 1535, 1531, 1528, 1524, 1521, 1517, 1513, 1508,
1504, 1499, 1495, 1490, 1485, 1479, 1474, 1468, 1463, 1457, 1451, 1445, 1438,
1432, 1425, 1418, 1411, 1404, 1397, 1390, 1382, 1375, 1367, 1359, 1351, 1342,
1334, 1325, 1317, 1308, 1299, 1290, 1280, 1271, 1261, 1252, 1242, 1232, 1222,
1212, 1201, 1191, 1180, 1170, 1159, 1148, 1137, 1126, 1114, 1103, 1091, 1080,
1068, 1056, 1044, 1032, 1020, 1007, 995, 982, 970, 957, 944, 931, 918, 905, 892,
878, 865, 851, 838, 824, 810, 797, 783, 769, 754, 740, 726, 712, 697, 683, 668,
654, 639, 624, 609, 595, 580, 565, 550, 535, 519, 504, 489, 474, 458, 443, 428,
412, 397, 381, 365, 350, 334, 319, 303, 287, 271, 256, 240, 224, 208, 192, 176,
160, 145, 129, 113, 97, 81,70};
*/

uint16_t table_sine[300] = {
    60,   77,   94,   110,  127,  144,  161,  178,  194,  211,  228,  244,
    261,  278,  294,  311,  328,  344,  361,  377,  394,  410,  427,  443,
    459,  475,  492,  508,  524,  540,  556,  572,  588,  604,  619,  635,
    651,  666,  682,  697,  713,  728,  743,  759,  774,  789,  804,  818,
    833,  848,  863,  877,  891,  906,  920,  934,  948,  962,  976,  990,
    1003, 1017, 1030, 1044, 1057, 1070, 1083, 1096, 1109, 1121, 1134, 1146,
    1159, 1171, 1183, 1195, 1207, 1218, 1230, 1241, 1253, 1264, 1275, 1286,
    1297, 1307, 1318, 1328, 1338, 1349, 1358, 1368, 1378, 1387, 1397, 1406,
    1415, 1424, 1433, 1441, 1450, 1458, 1466, 1474, 1482, 1490, 1498, 1505,
    1512, 1519, 1526, 1533, 1540, 1546, 1552, 1558, 1564, 1570, 1576, 1581,
    1586, 1592, 1596, 1601, 1606, 1610, 1615, 1619, 1623, 1626, 1630, 1633,
    1637, 1640, 1643, 1645, 1648, 1650, 1652, 1654, 1656, 1658, 1659, 1661,
    1662, 1663, 1664, 1664, 1665, 1665, 1665, 1665, 1665, 1664, 1664, 1663,
    1662, 1661, 1659, 1658, 1656, 1654, 1652, 1650, 1648, 1645, 1643, 1640,
    1637, 1633, 1630, 1626, 1623, 1619, 1615, 1610, 1606, 1601, 1596, 1592,
    1586, 1581, 1576, 1570, 1564, 1558, 1552, 1546, 1540, 1533, 1526, 1519,
    1512, 1505, 1498, 1490, 1482, 1474, 1466, 1458, 1450, 1441, 1433, 1424,
    1415, 1406, 1397, 1387, 1378, 1368, 1358, 1349, 1338, 1328, 1318, 1307,
    1297, 1286, 1275, 1264, 1253, 1241, 1230, 1218, 1207, 1195, 1183, 1171,
    1159, 1146, 1134, 1121, 1109, 1096, 1083, 1070, 1057, 1044, 1030, 1017,
    1003, 990,  976,  962,  948,  934,  920,  906,  891,  877,  862,  848,
    833,  818,  804,  789,  774,  759,  743,  728,  713,  697,  682,  666,
    651,  635,  619,  604,  588,  572,  556,  540,  524,  508,  492,  475,
    459,  443,  427,  410,  394,  377,  361,  344,  328,  311,  294,  278,
    261,  244,  228,  211,  194,  178,  161,  144,  127,  110,  94,   77};

//
// Main
//
void main(void) {

  //
  // Initialize device clock and peripherals
  //
Device_init();
  Check_clock = SysCtl_getClock(DEVICE_OSCSRC_FREQ);
  //
  // Disable pin locks and enable internal pull-ups.
  //
  Device_initGPIO();

  //
  // Initialize PIE and clear PIE registers. Disables CPU interrupts.
  //
  Interrupt_initModule();

  //
  // Initialize the PIE vector table with pointers to the shell Interrupt
  // Service Routines (ISR).
  
  Interrupt_initVectorTable();

  //
  // PinMux and Peripheral Initialization
  //
  Board_init();

  //
  // C2000Ware Library initialization
  //
  C2000Ware_libraries_init();

  //
  // Enable Global Interrupt (INTM) and real time interrupt (DBGM)
  //
  // config Global
  INV_globalVariablesInit();

  /*****************************************************************************
   *  DEAD_BAND = 800ns = 1/(200Mhz/1/1) * 80(valua set) * 2(DBRED:80, DBFED:80)
   **
   ****************************************************************************/

  EINT;
  ERTM;

  while (1) {

    GPIO_togglePin(41);
    DEVICE_DELAY_US(500000);

    
  }
}

__interrupt void INT_myADC0_1_ISR(void) {

    GPIO_togglePin(58);

    // PID_sine();
    // sine_wave();

    INV_readCurrentAndVoltageSignals(); 

#if defined (SINV_CTL_VOL)

    #if SINV_CTL_VOL == 1

        INV_vACVoltageControl_PI();

    #elif SINV_CTL_VOL == 2

        INV_vACVoltageControl_Basic();

    #else
    #error undefined SINV_CTL_VOL
    #endif
#else
    #error SINV_CTL_VOL is not define
#endif

#if defined (MODE_ACDC_DCAC)

    #if MODE_ACDC_DCAC == 1

        INV_runISR1_lab_ACDC_CL();

    #elif MODE_ACDC_DCAC == 2

        INV_runISR1_lab_DCAC_CL();
          
    #else 
    #error undefined MODE_ACDC_DCAC
    #endif
#else
    #error MODE_ACDC_DCAC is not define
#endif

    // POWER_MEAS_SINE_ANALYZER_run(&INV_mains_L1);

/*********************************Clear Interrupt ADC****************************************/

    ADC_clearInterruptStatus(myADC0_BASE, ADC_INT_NUMBER1);

    if (true == ADC_getInterruptOverflowStatus(myADC0_BASE, ADC_INT_NUMBER1)) {

        ADC_clearInterruptOverflowStatus(myADC0_BASE, ADC_INT_NUMBER1);
        ADC_clearInterruptStatus(myADC0_BASE, ADC_INT_NUMBER1);
    }

    Interrupt_clearACKGroup(INT_myADC0_1_INTERRUPT_ACK_GROUP);
}


void sine_wave(void) {

  val_table_sine++;
  if (val_table_sine >= 300) {
    val_table_sine = 0;
    flag_table_sine++;
    if (flag_table_sine >= 2) {
      flag_table_sine = 0;
    }
  }
  switch (flag_table_sine) {

  case 0:
    EPWM_setCounterCompareValue(myEPWM1_BASE, EPWM_COUNTER_COMPARE_A,
                                table_sine[val_table_sine] * val_amp_sine);
    EPWM_setCounterCompareValue(myEPWM2_BASE, EPWM_COUNTER_COMPARE_A, 0);

    break;
  case 1:
    EPWM_setCounterCompareValue(myEPWM2_BASE, EPWM_COUNTER_COMPARE_A,
                                table_sine[val_table_sine] * val_amp_sine);
    EPWM_setCounterCompareValue(myEPWM1_BASE, EPWM_COUNTER_COMPARE_A, 0);
    break;
  }
}

void PID_sine(void) {

  mesure_adc = 1000 + INV_DCAC_vAC_Heric_Sensor;
  if (mesure_adc < 2145) {
    val_amp_sine = val_amp_sine + 0.000005f;

  } else if (mesure_adc > 2155) {
    val_amp_sine = val_amp_sine - 0.000005f;
  } else {
    val_amp_sine = val_amp_sine;
  }

  if (val_amp_sine > 1.0f) {
    val_amp_sine = 1.0f;
  } else if (val_amp_sine < 0.0f) {
    val_amp_sine = 0.0f;
  } else {
    val_amp_sine = val_amp_sine;
  }
}

// set
// myGPIO0
//  End of File
//
