OnePice-C/INV.5KW/INV.5KW.OG.Design/firmware/FW.INV.HR.V1.0/use.main/CPU1_FLASH/syscfg/board.c

/*
 * Copyright (c) 2020 Texas Instruments Incorporated - http://www.ti.com
 * All rights reserved.
 *
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
 * *  Redistributions of source code must retain the above copyright
 *    notice, this list of conditions and the following disclaimer.
 *
 * *  Redistributions in binary form must reproduce the above copyright
 *    notice, this list of conditions and the following disclaimer in the
 *    documentation and/or other materials provided with the distribution.
 *
 * *  Neither the name of Texas Instruments Incorporated nor the names of
 *    its contributors may be used to endorse or promote products derived
 *    from this software without specific prior written permission.
 *
 * THIS SOFTWARE IS PROVIDED BY THE COPYRIGHT HOLDERS AND CONTRIBUTORS "AS IS"
 * AND ANY EXPRESS OR IMPLIED WARRANTIES, INCLUDING, BUT NOT LIMITED TO,
 * THE IMPLIED WARRANTIES OF MERCHANTABILITY AND FITNESS FOR A PARTICULAR
 * PURPOSE ARE DISCLAIMED. IN NO EVENT SHALL THE COPYRIGHT OWNER OR
 * CONTRIBUTORS BE LIABLE FOR ANY DIRECT, INDIRECT, INCIDENTAL, SPECIAL,
 * EXEMPLARY, OR CONSEQUENTIAL DAMAGES (INCLUDING, BUT NOT LIMITED TO,
 * PROCUREMENT OF SUBSTITUTE GOODS OR SERVICES; LOSS OF USE, DATA, OR PROFITS;
 * OR BUSINESS INTERRUPTION) HOWEVER CAUSED AND ON ANY THEORY OF LIABILITY,
 * WHETHER IN CONTRACT, STRICT LIABILITY, OR TORT (INCLUDING NEGLIGENCE OR
 * OTHERWISE) ARISING IN ANY WAY OUT OF THE USE OF THIS SOFTWARE,
 * EVEN IF ADVISED OF THE POSSIBILITY OF SUCH DAMAGE.
 *
 */

#include "board.h"

//*****************************************************************************
//
// Board Configurations
// Initializes the rest of the modules. 
// Call this function in your application if you wish to do all module 
// initialization.
// If you wish to not use some of the initializations, instead of the 
// Board_init use the individual Module_inits
//
//*****************************************************************************
void Board_init()
{
	EALLOW;

	PinMux_init();
	SYNC_init();
	ASYSCTL_init();
	ADC_init();
	EPWM_init();
	GPIO_init();
	INTERRUPT_init();

	EDIS;
}

//*****************************************************************************
//
// PINMUX Configurations
//
//*****************************************************************************
void PinMux_init()
{
	//
	// PinMux for modules assigned to CPU1
	//
	
	//
	// ANALOG -> myANALOGPinMux0 Pinmux
	//
	// Analog PinMux for B2
	GPIO_setPinConfig(GPIO_235_GPIO235);
	// AIO -> Analog mode selected
	GPIO_setAnalogMode(235, GPIO_ANALOG_ENABLED);
	// Analog PinMux for C3, GPIO206
	GPIO_setPinConfig(GPIO_206_GPIO206);
	// AGPIO -> Analog mode selected
	GPIO_setAnalogMode(206, GPIO_ANALOG_ENABLED);
	//
	// EPWM1 -> myEPWM1 Pinmux
	//
	GPIO_setPinConfig(myEPWM1_EPWMA_PIN_CONFIG);
	GPIO_setPadConfig(myEPWM1_EPWMA_GPIO, GPIO_PIN_TYPE_STD);
	GPIO_setQualificationMode(myEPWM1_EPWMA_GPIO, GPIO_QUAL_SYNC);

	GPIO_setPinConfig(myEPWM1_EPWMB_PIN_CONFIG);
	GPIO_setPadConfig(myEPWM1_EPWMB_GPIO, GPIO_PIN_TYPE_STD);
	GPIO_setQualificationMode(myEPWM1_EPWMB_GPIO, GPIO_QUAL_SYNC);

	//
	// EPWM2 -> myEPWM2 Pinmux
	//
	GPIO_setPinConfig(myEPWM2_EPWMA_PIN_CONFIG);
	GPIO_setPadConfig(myEPWM2_EPWMA_GPIO, GPIO_PIN_TYPE_STD);
	GPIO_setQualificationMode(myEPWM2_EPWMA_GPIO, GPIO_QUAL_SYNC);

	GPIO_setPinConfig(myEPWM2_EPWMB_PIN_CONFIG);
	GPIO_setPadConfig(myEPWM2_EPWMB_GPIO, GPIO_PIN_TYPE_STD);
	GPIO_setQualificationMode(myEPWM2_EPWMB_GPIO, GPIO_QUAL_SYNC);

	// GPIO41 -> myGPIO0 Pinmux
	GPIO_setPinConfig(GPIO_41_GPIO41);
	// GPIO58 -> myGPIO1 Pinmux
	GPIO_setPinConfig(GPIO_58_GPIO58);

}

//*****************************************************************************
//
// ADC Configurations
//
//*****************************************************************************
void ADC_init(){
	myADC0_init();
	ADC_Current_init();
}

void myADC0_init(){
	//
	// ADC Initialization: Write ADC configurations and power up the ADC
	//
	// Set the analog voltage reference selection and ADC module's offset trims.
	// This function sets the analog voltage reference to internal (with the reference voltage of 1.65V or 2.5V) or external for ADC
	// which is same as ASysCtl APIs.
	//
	ADC_setVREF(myADC0_BASE, ADC_REFERENCE_INTERNAL, ADC_REFERENCE_3_3V);
	//
	// Configures the analog-to-digital converter module prescaler.
	//
	ADC_setPrescaler(myADC0_BASE, ADC_CLK_DIV_4_0);
	//
	// Configures the analog-to-digital converter resolution and signal mode.
	//
	ADC_setMode(myADC0_BASE, ADC_RESOLUTION_16BIT, ADC_MODE_SINGLE_ENDED);
	//
	// Sets the timing of the end-of-conversion pulse
	//
	ADC_setInterruptPulseMode(myADC0_BASE, ADC_PULSE_END_OF_CONV);
	//
	// Powers up the analog-to-digital converter core.
	//
	ADC_enableConverter(myADC0_BASE);
	//
	// Delay for 1ms to allow ADC time to power up
	//
	DEVICE_DELAY_US(5000);
	//
	// Enable alternate timings for DMA trigger
	//
	ADC_enableAltDMATiming(myADC0_BASE);
	//
	// SOC Configuration: Setup ADC EPWM channel and trigger settings
	//
	// Disables SOC burst mode.
	//
	ADC_disableBurstMode(myADC0_BASE);
	//
	// Sets the priority mode of the SOCs.
	//
	ADC_setSOCPriority(myADC0_BASE, ADC_PRI_ALL_ROUND_ROBIN);
	//
	// Start of Conversion 0 Configuration
	//
	//
	// Configures a start-of-conversion (SOC) in the ADC and its interrupt SOC trigger.
	// 	  	SOC number		: 0
	//	  	Trigger			: ADC_TRIGGER_EPWM1_SOCA
	//	  	Channel			: ADC_CH_ADCIN2
	//	 	Sample Window	: 400 SYSCLK cycles
	//		Interrupt Trigger: ADC_INT_SOC_TRIGGER_NONE
	//
	ADC_setupSOC(myADC0_BASE, ADC_SOC_NUMBER0, ADC_TRIGGER_EPWM1_SOCA, ADC_CH_ADCIN2, 400U);
	ADC_setInterruptSOCTrigger(myADC0_BASE, ADC_SOC_NUMBER0, ADC_INT_SOC_TRIGGER_NONE);
	//
	// ADC Interrupt 1 Configuration
	// 		Source	: ADC_INT_TRIGGER_EOC0
	// 		Interrupt Source: enabled
	//		Continuous Mode	: enabled
	//
	//
	ADC_setInterruptSource(myADC0_BASE, ADC_INT_NUMBER1, ADC_INT_TRIGGER_EOC0);
	ADC_clearInterruptStatus(myADC0_BASE, ADC_INT_NUMBER1);
	ADC_enableContinuousMode(myADC0_BASE, ADC_INT_NUMBER1);
	ADC_enableInterrupt(myADC0_BASE, ADC_INT_NUMBER1);
}

void ADC_Current_init(){
	//
	// ADC Initialization: Write ADC configurations and power up the ADC
	//
	// Set the analog voltage reference selection and ADC module's offset trims.
	// This function sets the analog voltage reference to internal (with the reference voltage of 1.65V or 2.5V) or external for ADC
	// which is same as ASysCtl APIs.
	//
	ADC_setVREF(ADC_Current_BASE, ADC_REFERENCE_INTERNAL, ADC_REFERENCE_3_3V);
	//
	// Configures the analog-to-digital converter module prescaler.
	//
	ADC_setPrescaler(ADC_Current_BASE, ADC_CLK_DIV_4_0);
	//
	// Configures the analog-to-digital converter resolution and signal mode.
	//
	ADC_setMode(ADC_Current_BASE, ADC_RESOLUTION_16BIT, ADC_MODE_SINGLE_ENDED);
	//
	// Sets the timing of the end-of-conversion pulse
	//
	ADC_setInterruptPulseMode(ADC_Current_BASE, ADC_PULSE_END_OF_ACQ_WIN);
	//
	// Sets the timing of early interrupt generation.
	//
	ADC_setInterruptCycleOffset(ADC_Current_BASE, 0U);
	//
	// Powers up the analog-to-digital converter core.
	//
	ADC_enableConverter(ADC_Current_BASE);
	//
	// Delay for 1ms to allow ADC time to power up
	//
	DEVICE_DELAY_US(5000);
	//
	// Enable alternate timings for DMA trigger
	//
	ADC_enableAltDMATiming(ADC_Current_BASE);
	//
	// SOC Configuration: Setup ADC EPWM channel and trigger settings
	//
	// Disables SOC burst mode.
	//
	ADC_disableBurstMode(ADC_Current_BASE);
	//
	// Sets the priority mode of the SOCs.
	//
	ADC_setSOCPriority(ADC_Current_BASE, ADC_PRI_ALL_ROUND_ROBIN);
	//
	// Start of Conversion 1 Configuration
	//
	//
	// Configures a start-of-conversion (SOC) in the ADC and its interrupt SOC trigger.
	// 	  	SOC number		: 1
	//	  	Trigger			: ADC_TRIGGER_EPWM1_SOCA
	//	  	Channel			: ADC_CH_ADCIN3
	//	 	Sample Window	: 64 SYSCLK cycles
	//		Interrupt Trigger: ADC_INT_SOC_TRIGGER_NONE
	//
	ADC_setupSOC(ADC_Current_BASE, ADC_SOC_NUMBER1, ADC_TRIGGER_EPWM1_SOCA, ADC_CH_ADCIN3, 64U);
	ADC_setInterruptSOCTrigger(ADC_Current_BASE, ADC_SOC_NUMBER1, ADC_INT_SOC_TRIGGER_NONE);
}


//*****************************************************************************
//
// ASYSCTL Configurations
//
//*****************************************************************************
void ASYSCTL_init(){
	//
	// asysctl initialization
	//
	// Disables the temperature sensor output to the ADC.
	//
	ASysCtl_disableTemperatureSensor();
	//
	// Set the analog voltage reference selection to internal.
	//
	ASysCtl_setAnalogReferenceInternal( ASYSCTL_VREFHIA | ASYSCTL_VREFHIB | ASYSCTL_VREFHIC );
	//
	// Set the internal analog voltage reference selection to 1.65V.
	//
	ASysCtl_setAnalogReference1P65( ASYSCTL_VREFHIA | ASYSCTL_VREFHIB | ASYSCTL_VREFHIC );
}

//*****************************************************************************
//
// EPWM Configurations
//
//*****************************************************************************
void EPWM_init(){
    EPWM_setClockPrescaler(myEPWM1_BASE, EPWM_CLOCK_DIVIDER_1, EPWM_HSCLOCK_DIVIDER_1);	
    EPWM_setTimeBasePeriod(myEPWM1_BASE, 1666);	
    EPWM_setTimeBaseCounter(myEPWM1_BASE, 0);	
    EPWM_setTimeBaseCounterMode(myEPWM1_BASE, EPWM_COUNTER_MODE_UP_DOWN);	
    EPWM_disablePhaseShiftLoad(myEPWM1_BASE);	
    EPWM_setPhaseShift(myEPWM1_BASE, 0);	
    EPWM_setSyncInPulseSource(myEPWM1_BASE, EPWM_SYNC_IN_PULSE_SRC_DISABLE);	
    EPWM_setCounterCompareValue(myEPWM1_BASE, EPWM_COUNTER_COMPARE_A, 0);	
    EPWM_setCounterCompareShadowLoadMode(myEPWM1_BASE, EPWM_COUNTER_COMPARE_A, EPWM_COMP_LOAD_ON_CNTR_ZERO);	
    EPWM_setCounterCompareValue(myEPWM1_BASE, EPWM_COUNTER_COMPARE_B, 0);	
    EPWM_setCounterCompareShadowLoadMode(myEPWM1_BASE, EPWM_COUNTER_COMPARE_B, EPWM_COMP_LOAD_ON_CNTR_ZERO);	
    EPWM_setActionQualifierAction(myEPWM1_BASE, EPWM_AQ_OUTPUT_A, EPWM_AQ_OUTPUT_NO_CHANGE, EPWM_AQ_OUTPUT_ON_TIMEBASE_ZERO);	
    EPWM_setActionQualifierAction(myEPWM1_BASE, EPWM_AQ_OUTPUT_A, EPWM_AQ_OUTPUT_NO_CHANGE, EPWM_AQ_OUTPUT_ON_TIMEBASE_PERIOD);	
    EPWM_setActionQualifierAction(myEPWM1_BASE, EPWM_AQ_OUTPUT_A, EPWM_AQ_OUTPUT_HIGH, EPWM_AQ_OUTPUT_ON_TIMEBASE_UP_CMPA);	
    EPWM_setActionQualifierAction(myEPWM1_BASE, EPWM_AQ_OUTPUT_A, EPWM_AQ_OUTPUT_LOW, EPWM_AQ_OUTPUT_ON_TIMEBASE_DOWN_CMPA);	
    EPWM_setActionQualifierAction(myEPWM1_BASE, EPWM_AQ_OUTPUT_A, EPWM_AQ_OUTPUT_NO_CHANGE, EPWM_AQ_OUTPUT_ON_TIMEBASE_UP_CMPB);	
    EPWM_setActionQualifierAction(myEPWM1_BASE, EPWM_AQ_OUTPUT_A, EPWM_AQ_OUTPUT_NO_CHANGE, EPWM_AQ_OUTPUT_ON_TIMEBASE_DOWN_CMPB);	
    EPWM_setActionQualifierAction(myEPWM1_BASE, EPWM_AQ_OUTPUT_B, EPWM_AQ_OUTPUT_NO_CHANGE, EPWM_AQ_OUTPUT_ON_TIMEBASE_ZERO);	
    EPWM_setActionQualifierAction(myEPWM1_BASE, EPWM_AQ_OUTPUT_B, EPWM_AQ_OUTPUT_NO_CHANGE, EPWM_AQ_OUTPUT_ON_TIMEBASE_PERIOD);	
    EPWM_setActionQualifierAction(myEPWM1_BASE, EPWM_AQ_OUTPUT_B, EPWM_AQ_OUTPUT_NO_CHANGE, EPWM_AQ_OUTPUT_ON_TIMEBASE_UP_CMPA);	
    EPWM_setActionQualifierAction(myEPWM1_BASE, EPWM_AQ_OUTPUT_B, EPWM_AQ_OUTPUT_NO_CHANGE, EPWM_AQ_OUTPUT_ON_TIMEBASE_DOWN_CMPA);	
    EPWM_setActionQualifierAction(myEPWM1_BASE, EPWM_AQ_OUTPUT_B, EPWM_AQ_OUTPUT_NO_CHANGE, EPWM_AQ_OUTPUT_ON_TIMEBASE_UP_CMPB);	
    EPWM_setActionQualifierAction(myEPWM1_BASE, EPWM_AQ_OUTPUT_B, EPWM_AQ_OUTPUT_NO_CHANGE, EPWM_AQ_OUTPUT_ON_TIMEBASE_DOWN_CMPB);	
    EPWM_setDeadBandDelayPolarity(myEPWM1_BASE, EPWM_DB_RED, EPWM_DB_POLARITY_ACTIVE_LOW);	
    EPWM_setDeadBandDelayMode(myEPWM1_BASE, EPWM_DB_RED, true);	
    EPWM_setRisingEdgeDelayCountShadowLoadMode(myEPWM1_BASE, EPWM_RED_LOAD_ON_CNTR_ZERO);	
    EPWM_disableRisingEdgeDelayCountShadowLoadMode(myEPWM1_BASE);	
    EPWM_setRisingEdgeDelayCount(myEPWM1_BASE, 80);	
    EPWM_setDeadBandDelayMode(myEPWM1_BASE, EPWM_DB_FED, true);	
    EPWM_setFallingEdgeDelayCountShadowLoadMode(myEPWM1_BASE, EPWM_FED_LOAD_ON_CNTR_ZERO);	
    EPWM_disableFallingEdgeDelayCountShadowLoadMode(myEPWM1_BASE);	
    EPWM_setFallingEdgeDelayCount(myEPWM1_BASE, 80);	
    EPWM_setDeadBandOutputSwapMode(myEPWM1_BASE, EPWM_DB_OUTPUT_A, true);	
    EPWM_setDeadBandOutputSwapMode(myEPWM1_BASE, EPWM_DB_OUTPUT_B, true);	
    EPWM_enableADCTrigger(myEPWM1_BASE, EPWM_SOC_A);	
    EPWM_setADCTriggerSource(myEPWM1_BASE, EPWM_SOC_A, EPWM_SOC_TBCTR_U_CMPA);	
    EPWM_setADCTriggerEventPrescale(myEPWM1_BASE, EPWM_SOC_A, 1);	
    EPWM_enableADCTriggerEventCountInit(myEPWM1_BASE, EPWM_SOC_A);	
    EPWM_setClockPrescaler(myEPWM2_BASE, EPWM_CLOCK_DIVIDER_1, EPWM_HSCLOCK_DIVIDER_1);	
    EPWM_setTimeBasePeriod(myEPWM2_BASE, 1666);	
    EPWM_setTimeBaseCounter(myEPWM2_BASE, 0);	
    EPWM_setTimeBaseCounterMode(myEPWM2_BASE, EPWM_COUNTER_MODE_UP_DOWN);	
    EPWM_disablePhaseShiftLoad(myEPWM2_BASE);	
    EPWM_setPhaseShift(myEPWM2_BASE, 0);	
    EPWM_setSyncInPulseSource(myEPWM2_BASE, EPWM_SYNC_IN_PULSE_SRC_DISABLE);	
    EPWM_setCounterCompareValue(myEPWM2_BASE, EPWM_COUNTER_COMPARE_A, 0);	
    EPWM_setCounterCompareShadowLoadMode(myEPWM2_BASE, EPWM_COUNTER_COMPARE_A, EPWM_COMP_LOAD_ON_CNTR_ZERO);	
    EPWM_setCounterCompareValue(myEPWM2_BASE, EPWM_COUNTER_COMPARE_B, 0);	
    EPWM_setCounterCompareShadowLoadMode(myEPWM2_BASE, EPWM_COUNTER_COMPARE_B, EPWM_COMP_LOAD_ON_CNTR_ZERO);	
    EPWM_setActionQualifierAction(myEPWM2_BASE, EPWM_AQ_OUTPUT_A, EPWM_AQ_OUTPUT_NO_CHANGE, EPWM_AQ_OUTPUT_ON_TIMEBASE_ZERO);	
    EPWM_setActionQualifierAction(myEPWM2_BASE, EPWM_AQ_OUTPUT_A, EPWM_AQ_OUTPUT_NO_CHANGE, EPWM_AQ_OUTPUT_ON_TIMEBASE_PERIOD);	
    EPWM_setActionQualifierAction(myEPWM2_BASE, EPWM_AQ_OUTPUT_A, EPWM_AQ_OUTPUT_HIGH, EPWM_AQ_OUTPUT_ON_TIMEBASE_UP_CMPA);	
    EPWM_setActionQualifierAction(myEPWM2_BASE, EPWM_AQ_OUTPUT_A, EPWM_AQ_OUTPUT_LOW, EPWM_AQ_OUTPUT_ON_TIMEBASE_DOWN_CMPA);	
    EPWM_setActionQualifierAction(myEPWM2_BASE, EPWM_AQ_OUTPUT_A, EPWM_AQ_OUTPUT_NO_CHANGE, EPWM_AQ_OUTPUT_ON_TIMEBASE_UP_CMPB);	
    EPWM_setActionQualifierAction(myEPWM2_BASE, EPWM_AQ_OUTPUT_A, EPWM_AQ_OUTPUT_NO_CHANGE, EPWM_AQ_OUTPUT_ON_TIMEBASE_DOWN_CMPB);	
    EPWM_setActionQualifierAction(myEPWM2_BASE, EPWM_AQ_OUTPUT_B, EPWM_AQ_OUTPUT_NO_CHANGE, EPWM_AQ_OUTPUT_ON_TIMEBASE_ZERO);	
    EPWM_setActionQualifierAction(myEPWM2_BASE, EPWM_AQ_OUTPUT_B, EPWM_AQ_OUTPUT_NO_CHANGE, EPWM_AQ_OUTPUT_ON_TIMEBASE_PERIOD);	
    EPWM_setActionQualifierAction(myEPWM2_BASE, EPWM_AQ_OUTPUT_B, EPWM_AQ_OUTPUT_NO_CHANGE, EPWM_AQ_OUTPUT_ON_TIMEBASE_UP_CMPA);	
    EPWM_setActionQualifierAction(myEPWM2_BASE, EPWM_AQ_OUTPUT_B, EPWM_AQ_OUTPUT_NO_CHANGE, EPWM_AQ_OUTPUT_ON_TIMEBASE_DOWN_CMPA);	
    EPWM_setActionQualifierAction(myEPWM2_BASE, EPWM_AQ_OUTPUT_B, EPWM_AQ_OUTPUT_NO_CHANGE, EPWM_AQ_OUTPUT_ON_TIMEBASE_UP_CMPB);	
    EPWM_setActionQualifierAction(myEPWM2_BASE, EPWM_AQ_OUTPUT_B, EPWM_AQ_OUTPUT_NO_CHANGE, EPWM_AQ_OUTPUT_ON_TIMEBASE_DOWN_CMPB);	
    EPWM_setDeadBandDelayPolarity(myEPWM2_BASE, EPWM_DB_RED, EPWM_DB_POLARITY_ACTIVE_LOW);	
    EPWM_setDeadBandDelayMode(myEPWM2_BASE, EPWM_DB_RED, true);	
    EPWM_setRisingEdgeDelayCountShadowLoadMode(myEPWM2_BASE, EPWM_RED_LOAD_ON_CNTR_ZERO);	
    EPWM_disableRisingEdgeDelayCountShadowLoadMode(myEPWM2_BASE);	
    EPWM_setRisingEdgeDelayCount(myEPWM2_BASE, 80);	
    EPWM_setDeadBandDelayMode(myEPWM2_BASE, EPWM_DB_FED, true);	
    EPWM_setFallingEdgeDelayCountShadowLoadMode(myEPWM2_BASE, EPWM_FED_LOAD_ON_CNTR_ZERO);	
    EPWM_disableFallingEdgeDelayCountShadowLoadMode(myEPWM2_BASE);	
    EPWM_setFallingEdgeDelayCount(myEPWM2_BASE, 80);	
    EPWM_setDeadBandOutputSwapMode(myEPWM2_BASE, EPWM_DB_OUTPUT_A, true);	
    EPWM_setDeadBandOutputSwapMode(myEPWM2_BASE, EPWM_DB_OUTPUT_B, true);	
}

//*****************************************************************************
//
// GPIO Configurations
//
//*****************************************************************************
void GPIO_init(){
	myGPIO0_init();
	myGPIO1_init();
}

void myGPIO0_init(){
	GPIO_setPadConfig(myGPIO0, GPIO_PIN_TYPE_STD);
	GPIO_setQualificationMode(myGPIO0, GPIO_QUAL_SYNC);
	GPIO_setDirectionMode(myGPIO0, GPIO_DIR_MODE_OUT);
	GPIO_setControllerCore(myGPIO0, GPIO_CORE_CPU1);
}
void myGPIO1_init(){
	GPIO_setPadConfig(myGPIO1, GPIO_PIN_TYPE_STD);
	GPIO_setQualificationMode(myGPIO1, GPIO_QUAL_SYNC);
	GPIO_setDirectionMode(myGPIO1, GPIO_DIR_MODE_OUT);
	GPIO_setControllerCore(myGPIO1, GPIO_CORE_CPU1);
}

//*****************************************************************************
//
// INTERRUPT Configurations
//
//*****************************************************************************
void INTERRUPT_init(){
	
	// Interrupt Settings for INT_myADC0_1
	// ISR need to be defined for the registered interrupts
	Interrupt_register(INT_myADC0_1, &INT_myADC0_1_ISR);
	Interrupt_enable(INT_myADC0_1);
}
//*****************************************************************************
//
// SYNC Scheme Configurations
//
//*****************************************************************************
void SYNC_init(){
	SysCtl_setSyncOutputConfig(SYSCTL_SYNC_OUT_SRC_EPWM1SYNCOUT);
	//
	// SOCA
	//
	SysCtl_enableExtADCSOCSource(0);
	//
	// SOCB
	//
	SysCtl_enableExtADCSOCSource(0);
}
