OnePice-C/INV.5KW/INV.5KW.OG.Design/firmware/FW.INV.HR.V1.0/use.main/CPU1_FLASH/syscfg/clocktree.h

//#############################################################################
//
// FILE:   clockTree.h
//
// TITLE:  Setups device clocking for examples.
//
//#############################################################################
// $Copyright:
// Copyright (C) 2025 Texas Instruments Incorporated - http://www.ti.com
//
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
//   Redistributions of source code must retain the above copyright 
//   notice, this list of conditions and the following disclaimer.
// 
//   Redistributions in binary form must reproduce the above copyright
//   notice, this list of conditions and the following disclaimer in the 
//   documentation and/or other materials provided with the   
//   distribution.
// 
//   Neither the name of Texas Instruments Incorporated nor the names of
//   its contributors may be used to endorse or promote products derived
//   from this software without specific prior written permission.
// 
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
#ifndef CLOCKTREE_H
#define CLOCKTREE_H

//*****************************************************************************
//
// Summary of SYSPLL related clock configuration
//
//*****************************************************************************
//
// Input Clock to SYSPLL (OSCCLK)	= 25 MHz    (X1 provides OSCCLK)
//
//##### SYSPLL ENABLED #####
//
// PLLRAWCLK				= 200 MHz   (Output of SYSPLL if enabled) 
// PLLSYSCLK				= 200 MHz
// CPU1CLK					= 200 MHz
// CPU2CLK					= 200 MHz 
// CPU1_SYSCLK				= 200 MHz
// CPU2_SYSCLK 				= 200 MHz
// LSPCLK					= 50 MHz 
// EPWMCLK 					= 100 MHz	
	
//*****************************************************************************
//
// Macro definitions used in device.c (SYSPLL / LSPCLK)
//
//*****************************************************************************
//
//	Input Clock to SYSPLL (OSCCLK) = X1 = 25 MHz
//
#define DEVICE_OSCSRC_FREQ          25000000U
//
// Define to pass to SysCtl_setClock(). Will configure the clock as follows:
// SYSPLL ENABLED
// SYSCLK = 200 MHz = 25 MHz (OSCCLK) * 32 (IMULT) / (2 (REFDIV) * 2 (ODIV) * 1 (SYSCLKDIVSEL))
//
#define DEVICE_SETCLOCK_CFG         (SYSCTL_OSCSRC_XTAL_SE  | SYSCTL_IMULT(32) | \
									 SYSCTL_REFDIV(2) | SYSCTL_ODIV(2) | \
									 SYSCTL_SYSDIV(1) | SYSCTL_PLL_ENABLE | \
									 SYSCTL_DCC_BASE_0)
									 
									 
#define DEVICE_SYSCLK_FREQ          ((DEVICE_OSCSRC_FREQ * 32) / (2 * 2 * 1))

//
// Define to pass to SysCtl_setLowSpeedClock().
// Low Speed Clock (LSPCLK) = 200 MHz / 4 = 50 MHz
//
#define DEVICE_LSPCLK_CFG  			SYSCTL_LSPCLK_PRESCALE_4

#define DEVICE_LSPCLK_FREQ          (DEVICE_SYSCLK_FREQ / 4)

//*****************************************************************************
//
// Summary of AUXPLL related clock configuration
//
//*****************************************************************************
//
// Input Clock to AUXOSCCLK	= 25 MHz (X1 provides AUXOSCCLK)  
//
//##### AUXPLL ENABLED #####
//
// AUXPLLRAWCLK				= 125 MHz (Output of AUXPLL if enabled)
// AUXPLLCLK				= 125 MHz 
//
//*****************************************************************************
//
// Macro definitions used in device.c (AUXPLL)
//
//*****************************************************************************
//
//	Input Clock to AUXPLL (AUXOSCCLK) = X1 = 25 MHz
//
#define DEVICE_AUXOSCSRC_FREQ 		25000000U
//
// Define to pass to SysCtl_setAuxClock(). Will configure the clock as follows:
// AUXPLL ENABLED
// AUXPLLCLK = 125 MHz = 25 MHz (AUXOSCCLK) * 40 (IMULT) / (2 (REFDIV) * 4 (ODIV) * 1 (AUXCLKDIVSEL))
#define DEVICE_AUXCLK_FREQ          (DEVICE_AUXOSCSRC_FREQ * 40) / (2 * 4 * 1)
//
#define DEVICE_AUXSETCLOCK_CFG      (SYSCTL_AUXPLL_OSCSRC_XTAL_SE  | SYSCTL_AUXPLL_IMULT(40) | \
									 SYSCTL_REFDIV(2) | SYSCTL_ODIV(4)| \
									 SYSCTL_AUXPLL_DIV_1 | SYSCTL_AUXPLL_ENABLE | \
									 SYSCTL_DCC_BASE_0)
									 
									 

	
//*****************************************************************************
//
// CPU1CLK / CPU2CLK Domain (200 MHz)
//
//*****************************************************************************
// VCRC
// TMU
// FPU
// HWBIST
//	

//*****************************************************************************
//
// CPU1 SYSCLK Domain (200 MHz)
//
//*****************************************************************************
// DCC
// DCSM
// CPUTIMERx
// DMA
// CLAROM
// CLA1
// XINT
// PIE
// GSxRAMs
// LSxRAMs
// MSGRAMs
// Mx/DxRAM
// BootROM
// ERAD
// WD
//	

/////////////////////	
// Gated CPU1 SYSCLK
/////////////////////
// USB
//

//*****************************************************************************
//
// CPU2 SYSCLK Domain (200 MHz)
//
//*****************************************************************************
// BootROM
// DCSM
// GSxRAMs
// WD
// CPUTIMERx
// DMA
// CLA1
// XINT
// PIE
// LSxRAMs
// MSGRAMs
// Mx/DxRAM
// ERAD
//
	
/////////////////////	
// Gated CPU2 SYSCLK
/////////////////////
// CPU2_CLA1
// CPU2_Timer
//
//*****************************************************************************
//
// Gated Peripheral EPWM Domain (100 MHz) 
//
//*****************************************************************************
// EPWM
// HRPWM
//
//*****************************************************************************
//
// Gated Peripheral SYSCLK Domain (200 MHz) 
//
//*****************************************************************************
// ADC
// CMPSS
// DAC
// ePWM
// eCAP
// eQEP
// I2C
// AES
// SDFM
// FSI
// PMBUS
// BGCRC
// SPI
// SCI
// EPG
// CAN
// UART
// LIN
// MCAN
//	
//*****************************************************************************
//
// Gated LSPCLK Domain (50 MHz) 
//
//*****************************************************************************
// SCI
// SPI

#endif // CLOCKTREE_H
