OnePice-C/INV.5KW/(notices)

Notices in the files:
Doc.Design.INV.OFG/Grid_Tie_Inverter_V5-main/STM32CubeIDE_Code/Core/Src/PID.c:
This program is free software: you can redistribute it and/or modify it under
the terms of the GNU General Public License as published by the Free Software
Doc.Design.INV.OFG/Grid_Tie_Inverter_V5-main/STM32CubeIDE_Code/Core/Src/main.c:
MIT License
Copyright (c) [2023] [James Fotherby]
Doc.Design.INV.OFG/Grid_Tie_Inverter_V5-main/STM32CubeIDE_Code/Core/Inc/main.h:
Copyright (c) 2023 STMicroelectronics.
All rights reserved.
This software is licensed under terms that can be found in the LICENSE file
